revjmoney/revturn-lathe-firmware/tools/resonance/runs/c_speed_50-200rpm/report.md

| C accel (deg/s2) | workout | seconds | sound over quiet (dB) | shake RMS (m/s2) | shake peak | chuck frame change |
|---|---|---|---|---|---|---|
| 50 | ok in 27.0 s | 26.98 | 1.03 | 0.34 | 0.77 | 7.08 |
| 100 | ok in 15.8 s | 15.84 | 0.88 | 0.36 | 0.92 | 7.03 |
| 150 | ok in 12.5 s | 12.56 | 0.99 | 0.38 | 1.42 | 6.93 |
| 200 | ok in 11.3 s | 11.32 | 1.16 | 0.41 | 1.68 | 15.39 |
