revjmoney/revturn-lathe-firmware/tools/resonance/runs/c_spin_one_dot_manual_exposure/spin_report.md

| commanded rpm | camera rpm | error | mark contrast |
|---|---|---|---|
| 10 | 9.9 | -0.1 | 4597.5 |
| 20 | 21.8 | +1.8 | 5310.2 |
| 30 | 31.6 | +1.6 | 5629.8 |
| 60 | 59.8 | -0.2 | 4653.1 |
| 90 | 92.1 | +2.1 | 4888.3 |
| 120 | 120.4 | +0.4 | 3014.3 |
| 150 | 148.1 | -1.9 | 5080.2 |
| 200 | 199.3 | -0.7 | 5007.6 |
| 250 | 249.0 | -1.0 | 4621.6 |
| 275 | 274.4 | -0.6 | 4504.1 |
| 300 | 296.0 | -4.0 | 2987.7 |

camera shift 1.3 s
