revjmoney/revturn-lathe-firmware/tools/resonance/runs/c_spin_two_marks/spin_report.md

| commanded rpm | camera rpm | error | mark contrast |
|---|---|---|---|
| 10 | 10.1 | +0.1 | 1208.2 |
| 20 | 20.4 | +0.4 | 1436.2 |
| 30 | 60.6 | +30.6 | 1276.8 |
| 60 | 120.0 | +60.0 | 1216.7 |
| 90 | 180.2 | +90.2 | 1178.0 |
| 120 | 239.5 | +119.5 | 1102.3 |
| 150 | 150.1 | +0.1 | 1090.0 |
| 200 | 198.9 | -1.1 | 913.7 |
| 250 | 248.5 | -1.5 | 649.2 |
| 275 | 123.0 | -152.0 | 599.2 |
| 300 | 300.4 | +0.4 | 571.6 |

camera shift -0.5 s
