revjmoney/revturn-lathe-firmware/tools/resonance/runs/chords-2026-11-11T19-04-08/machine-info.txt

[VER:1.1f.20261015:]
[OPT:VNSL,100,1024,4,0]
[AXS:4:XYZC]
[NEWOPT:ENUMS,RT+,CCMP,NOPROBE,RF,ES,LATHE,REBOOT,EXPR,TC,SED,RTC,WIFI,FTP,mDNS,FS,YM]
[FIRMWARE:grblHAL]
[SIGNALS:E]
[NVS STORAGE:*FLASH 4K]
[FREE MEMORY:157K]
[DRIVER:ESP32@240MHz]
[DRIVER VERSION:261003]
[DRIVER OPTIONS:4.3.2]
[BOARD:REVTURN by JMSCNC (ESP32 lathe)]
[HOSTNAME:revturn.local]
[NETCON:Websocket]
[PLUGIN:FS stream v1.16]
[PLUGIN:WebUI v0.32]
[SPINDLE:Stepper]
