revjmoney/revturn-lathe-firmware/tools/resonance/runs/chords-2026-11-11T19-04-08/summary.md

# chords.nc (chords)

Recorded 2026-11-11T19:01:48.073Z: 55989 phone samples at 403 Hz, 1289 lathe status lines, background 0.028 m/s^2, median step 2.011 m/s^2.

## Weird things (5 steps flagged)
- **LOUD** X+Z 10 Hz beat: rms 3.0208, strongest 173.1 Hz = 1x pitch, reached 0.999
- **LOUD** Z + spindle, 2 Hz beat: rms 2.9063, strongest 182.9 Hz = 1x pitch, reached 0.997
- **LOUD** all three near unison: 2, 3, 5 Hz beats: rms 2.8585, strongest 181.0 Hz = 1x pitch, reached 1.0
- **LOUD** all three at their resonance: rms 3.3559, strongest 128.1 Hz = 1x pitch, reached 0.997
- **LOUD** spread: rms 2.7664, strongest 199.9 Hz = 1x pitch, reached 0.999

## Chords (loudest first)
- 3.356 m/s^2 (122x background): all three at their resonance  [strongest 128.1 Hz]
- 3.159 m/s^2 (115x background): X+Z both at their resonance, 1 Hz beat  [strongest 127.7 Hz]
- 3.021 m/s^2 (110x background): X+Z 10 Hz beat  [strongest 173.1 Hz]
- 2.906 m/s^2 (106x background): Z + spindle, 2 Hz beat  [strongest 182.9 Hz]
- 2.865 m/s^2 (104x background): X+Z near unison, 2 Hz beat  [strongest 181.0 Hz]
- 2.858 m/s^2 (104x background): all three near unison: 2, 3, 5 Hz beats  [strongest 181.0 Hz]
- 2.766 m/s^2 (101x background): spread  [strongest 199.9 Hz]
- 2.579 m/s^2 (94x background): X+Z minor second, a clash  [strongest 170.3 Hz]
- 2.066 m/s^2 (75x background): A minor chord: X A3, Z C4, C E4  [strongest 141.5 Hz]
- 2.011 m/s^2 (73x background): low rumble  [strongest 99.7 Hz]
- 1.426 m/s^2 (52x background): X + spindle, X at resonance  [strongest 149.0 Hz]
- 1.325 m/s^2 (48x background): C major chord: X C4, Z E4, C G4  [strongest 73.7 Hz]
- 1.306 m/s^2 (47x background): all three in tune: A4 unison  [strongest 183.3 Hz]
- 1.182 m/s^2 (43x background): X+Z perfect fifth  [strongest 72.9 Hz]
- 1.040 m/s^2 (38x background): mid  [strongest 199.5 Hz]
- 0.992 m/s^2 (36x background): X+Z fast, spindle 2 octaves up  [strongest 103.7 Hz]
- 0.831 m/s^2 (30x background): X+Z octave  [strongest 182.9 Hz]
- 0.788 m/s^2 (29x background): everything fast  [strongest 136.4 Hz]
- 0.540 m/s^2 (20x background): X + spindle, 2 Hz beat  [strongest 182.9 Hz]
