revjmoney/revturn-lathe-firmware/tools/resonance/runs/scale_c-2026-11-11T18-59-36/summary.md

# scale_c.nc (C)

Recorded 2026-11-11T18:53:38.636Z: 142893 phone samples at 403 Hz, 2553 lathe status lines, background 0.028 m/s^2, median step 0.127 m/s^2.

## Weird things (45 steps flagged)
- **RING** q 570.6094 Hz = 57.0624 rpm: rms 0.158, strongest 52.8 Hz = other pitch, reached 0.999
- **RING** q 640.4874 Hz = 64.0503 rpm: rms 0.1141, strongest 50.9 Hz = other pitch, reached 0.999
- **RING** E5 659.2551 Hz = 65.9272 rpm: rms 0.1106, strongest 52.0 Hz = other pitch, reached 1.001
- **RING** q 718.9228 Hz = 71.8941 rpm: rms 0.1036, strongest 51.3 Hz = other pitch, reached 1.001
- **RING** F#5 739.9888 Hz = 74.0007 rpm: rms 0.1018, strongest 52.4 Hz = other pitch, reached 1.0
- **RING** q 761.6722 Hz = 76.1691 rpm: rms 0.1317, strongest 95.0 Hz = other pitch, reached 0.998
- **RING** G5 783.9909 Hz = 78.401 rpm: rms 0.1186, strongest 49.7 Hz = other pitch, reached 0.995
- **RING** q 806.9636 Hz = 80.6984 rpm: rms 0.0901, strongest 95.0 Hz = other pitch, reached 1.004
- **RING** q 854.9481 Hz = 85.4969 rpm: rms 0.1233, strongest 54.4 Hz = other pitch, reached 0.994
- **RING** A5 880 Hz = 88.0022 rpm: rms 0.1246, strongest 97.0 Hz = other pitch, reached 1.0
- **RING** q 905.786 Hz = 90.5809 rpm: rms 0.1472, strongest 90.7 Hz = other pitch, reached 1.005
- **RING** A#5 932.3275 Hz = 93.2351 rpm: rms 0.1667, strongest 55.2 Hz = other pitch, reached 0.997
- **RING** B5 987.7666 Hz = 98.7791 rpm: rms 0.1259, strongest 100.9 Hz = other pitch, reached None
- **RING** q 1016.7104 Hz = 101.6736 rpm: rms 0.1239, strongest 52.8 Hz = other pitch, reached None
- **RING** C6 1046.5023 Hz = 104.6528 rpm: rms 0.129, strongest 58.7 Hz = other pitch, reached None
- **RING** q 1077.1671 Hz = 107.7194 rpm: rms 0.1401, strongest 113.5 Hz = other pitch, reached None
- **RING** C#6 1108.7305 Hz = 110.8758 rpm: rms 0.1123, strongest 52.8 Hz = other pitch, reached None
- **RING** q 1141.2188 Hz = 114.1247 rpm: rms 0.1139, strongest 51.6 Hz = other pitch, reached None
- **RING** D6 1174.6591 Hz = 117.4688 rpm: rms 0.1261, strongest 55.6 Hz = other pitch, reached None
- **RING** q 1209.0792 Hz = 120.9109 rpm: rms 0.1487, strongest 93.4 Hz = other pitch, reached None
- **RING** D#6 1244.5079 Hz = 124.4539 rpm: rms 0.1327, strongest 55.6 Hz = other pitch, reached None
- **RING** q 1280.9748 Hz = 128.1007 rpm: rms 0.1304, strongest 52.4 Hz = other pitch, reached None
- **RING** E6 1318.5102 Hz = 131.8543 rpm: rms 0.166, strongest 102.9 Hz = other pitch, reached None
- **RING** q 1357.1455 Hz = 135.7179 rpm: rms 0.2455, strongest 94.6 Hz = other pitch, reached None
- **RING** F6 1396.9129 Hz = 139.6948 rpm: rms 0.2007, strongest 88.3 Hz = other pitch, reached None
- **RING** q 1437.8456 Hz = 143.7882 rpm: rms 0.1965, strongest 106.0 Hz = other pitch, reached None
- **RING** F#6 1479.9777 Hz = 148.0015 rpm: rms 0.2465, strongest 91.1 Hz = other pitch, reached None
- **RING** q 1523.3443 Hz = 152.3382 rpm: rms 0.1742, strongest 58.0 Hz = other pitch, reached None
- **RING** G6 1567.9817 Hz = 156.8021 rpm: rms 0.2034, strongest 113.1 Hz = other pitch, reached None
- **RING** q 1613.9271 Hz = 161.3967 rpm: rms 0.1731, strongest 88.3 Hz = other pitch, reached None
- **RING** G#6 1661.2188 Hz = 166.126 rpm: rms 0.175, strongest 93.8 Hz = other pitch, reached None
- **RING** A6 1760 Hz = 176.0044 rpm: rms 0.2097, strongest 96.6 Hz = other pitch, reached None
- **RING** A#6 1864.655 Hz = 186.4702 rpm: rms 0.1624, strongest 54.4 Hz = other pitch, reached None
- **RING** q 1919.2936 Hz = 191.9342 rpm: rms 0.1744, strongest 54.4 Hz = other pitch, reached None
- **RING** B6 1975.5332 Hz = 197.5583 rpm: rms 0.2016, strongest 112.4 Hz = other pitch, reached None
- **RING** q 2033.4207 Hz = 203.3472 rpm: rms 0.2557, strongest 97.8 Hz = other pitch, reached None
- **RING** C7 2093.0045 Hz = 209.3057 rpm: rms 0.2007, strongest 54.0 Hz = other pitch, reached None
- **RING** q 2154.3342 Hz = 215.4388 rpm: rms 0.2348, strongest 52.8 Hz = other pitch, reached None
- **RING** C#7 2217.461 Hz = 221.7516 rpm: rms 0.2119, strongest 55.6 Hz = other pitch, reached None
- **RING** q 2282.4376 Hz = 228.2495 rpm: rms 0.2605, strongest 147.0 Hz = other pitch, reached None
- **RING** D7 2349.3181 Hz = 234.9377 rpm: rms 0.2348, strongest 151.0 Hz = other pitch, reached None
- **RING** q 2418.1584 Hz = 241.8219 rpm: rms 0.2424, strongest 24.8 Hz = other pitch, reached None
- **RING** D#7 2489.0159 Hz = 248.9078 rpm: rms 0.2801, strongest 26.0 Hz = other pitch, reached None
- **RING** E7 2637.0205 Hz = 263.7086 rpm: rms 0.2524, strongest 26.8 Hz = other pitch, reached 1.001
- **RING** q 2714.2911 Hz = 271.4359 rpm: rms 0.2526, strongest 27.2 Hz = other pitch, reached 0.998

## Smooth notes (21): C2 (6.5408), C#2 (6.9297), F3 (17.4618), F#3 (18.5002), G3 (19.6003), G#3 (20.7658), A3 (22.0006), A#3 (23.3088), B3 (24.6948), C4 (26.1632), D4 (29.3672), E4 (32.9636), F4 (34.9237), F#4 (37.0004), G4 (39.2005), G#4 (41.5315), A4 (44.0011), A#4 (46.6175), B4 (49.3896), C5 (52.3264), D5 (58.7344)
## Roughest steps: D#2 77.7817 Hz / 7.7784 = 0.2911, q 75.5675 Hz / 7.5569 = 0.2851, D#7 2489.0159 Hz / 248.9078 = 0.2801, C#3 138.5913 Hz / 13.8595 = 0.2609, q 2282.4376 Hz / 228.2495 = 0.2605, q 80.0609 Hz / 8.0063 = 0.2598, q 2033.4207 Hz / 203.3472 = 0.2557, q 2714.2911 Hz / 271.4359 = 0.2526
