revjmoney/revturn-lathe-firmware/tools/resonance/runs/scale_x-2026-11-11T18-37-28/summary.md

# scale_x.nc (X)

Recorded 2026-11-11T18:32:01.567Z: 130684 phone samples at 403 Hz, 2996 lathe status lines, background 0.027 m/s^2, median step 0.807 m/s^2.

## Weird things (7 steps flagged)
- **RING** C2 65.4064 Hz = 3.0901 ipm: rms 0.7142, strongest 75.7 Hz = other pitch, reached 0.994
- **RING** C#2 69.2957 Hz = 3.2738 ipm: rms 0.6755, strongest 194.8 Hz = other pitch, reached 0.998
- **RING** q 71.3262 Hz = 3.3697 ipm: rms 0.6167, strongest 188.8 Hz = other pitch, reached 0.993
- **RING** q 75.5675 Hz = 3.5701 ipm: rms 0.6621, strongest 176.2 Hz = other pitch, reached 0.992
- **LOUD** B3 246.9417 Hz = 11.6665 ipm: rms 1.2924, strongest 156.1 Hz = 1x pitch, reached 0.999
- **LOUD** B4 493.8833 Hz = 23.3331 ipm: rms 3.2949, strongest 156.1 Hz = 1/2 pitch, reached 0.999
- **LOUD** q 508.3552 Hz = 24.0168 ipm: rms 2.6687, strongest 149.0 Hz = 1/2 pitch, reached 1.0

## Smooth notes (11): D2 (3.4685), D#2 (3.6747), D3 (6.937), F#3 (8.74), G3 (9.2597), G#3 (9.8103), A3 (10.3937), A#3 (11.0117), F#5 (34.9601), G5 (37.0389), G#5 (39.2414)
## Roughest steps: B4 493.8833 Hz / 23.3331 = 3.2949, q 508.3552 Hz / 24.0168 = 2.6687, q 479.8234 Hz / 22.6688 = 2.2621, C5 523.2511 Hz / 24.7205 = 1.9989, A#4 466.1638 Hz / 22.0235 = 1.671, q 640.4874 Hz / 30.2592 = 1.5945, q 538.5836 Hz / 25.4449 = 1.529, q 452.893 Hz / 21.3965 = 1.516
