revjmoney/revturn-lathe-firmware/tools/resonance/runs/scale_z-2026-11-11T18-43-09/summary.md

# scale_z.nc (Z)

Recorded 2026-11-11T18:37:50.652Z: 127518 phone samples at 403 Hz, 2930 lathe status lines, background 0.026 m/s^2, median step 1.836 m/s^2.

## Weird things (0 steps flagged)

## Smooth notes (12): C2 (2.5591), D#4 (12.173), E4 (12.8969), F4 (13.6637), F#4 (14.4762), G4 (15.337), G#4 (16.249), A4 (17.2152), A#4 (18.2389), B4 (19.3235), C5 (20.4725), C#5 (21.6898)
## Roughest steps: G#3 207.6523 Hz / 8.1245 = 3.0739, G3 195.9977 Hz / 7.6685 = 3.0602, C3 130.8128 Hz / 5.1181 = 3.0349, A3 220 Hz / 8.6076 = 3.0336, C#3 138.5913 Hz / 5.4225 = 2.9716, q 127.0888 Hz / 4.9724 = 2.9675, A#3 233.0819 Hz / 9.1195 = 2.9142, q 134.6459 Hz / 5.2681 = 2.9038
