revjmoney/revturn-lathe-firmware/tools/resonance/runs/chords-2026-11-11T19-04-08/report.csv

n | label | xHz | zHz | cHz | xIpm | zIpm | rpm | pathF | rms | peak_hz | motor_seen | motor_share | peak_is | reached | timed | seconds | flags
4000 | X+Z both at their resonance, 1 Hz beat | 127 | 128 |  | 6 | 5.0081 | 0 | 7.8154 | 3.1595 | 127.7 | 127.0 128.0 | 0.986 | 1x | 0.997 | False | 3.48
4001 | X+Z near unison, 2 Hz beat | 220 | 222 |  | 10.3937 | 8.6859 | 0 | 13.5452 | 2.8647 | 181.0 | 182.9 180.9 | 0.91 | 1x | 1.0 | False | 3.4
4002 | X+Z 10 Hz beat | 220 | 230 |  | 10.3937 | 8.9989 | 0 | 13.748 | 3.0208 | 173.1 | 182.9 172.9 | 0.986 | 1x | 0.999 | False | 3.36 | LOUD
4003 | X+Z minor second, a clash | 220 | 233.08 |  | 10.3937 | 9.1194 | 0 | 13.8272 | 2.5785 | 170.3 | 182.9 169.8 | 0.956 | 1x | 0.999 | False | 3.28
4004 | X+Z perfect fifth | 220 | 330 |  | 10.3937 | 12.9114 | 0 | 16.5751 | 1.1818 | 72.9 | 182.9 72.9 | 0.901 | 1x | 1.0 | False | 3.02
4005 | X+Z octave | 220 | 440 |  | 10.3937 | 17.2152 | 0 | 20.1095 | 0.8314 | 182.9 | 182.9 37.1 | 0.937 | 1/2 | 0.998 | False | 2.85
4006 | X + spindle, 2 Hz beat | 220 |  | 222 | 10.3937 | 0 | 22.2006 | 10.3937 | 0.5404 | 182.9 | 182.9 180.9 | 0.679 | 1x | 0.996 | False | 3.91
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
