revjmoney/revturn-lathe-firmware/tools/resonance/runs/c_accel_2500-3400/report.md

| C accel (deg/s2) | workout | seconds | sound over quiet (dB) | shake RMS (m/s2) | shake peak | chuck frame change |
|---|---|---|---|---|---|---|
| 2500 | ok in 19.4 s | 19.45 | 1.05 | 0.34 | 0.66 | 5.95 |
| 2600 | ok in 19.3 s | 19.30 | 0.68 | 0.34 | 0.68 | 5.49 |
| 2700 | ok in 19.2 s | 19.25 | 0.74 | 0.34 | 0.71 | 6.52 |
| 2800 | ok in 19.1 s | 19.11 | 0.81 | 0.34 | 0.67 | 6.79 |
| 2900 | ok in 19.0 s | 19.05 | 0.97 | 0.34 | 0.90 | 5.86 |
| 3000 | ok in 19.1 s | 19.10 | 1.20 | 0.34 | 0.85 | 6.81 |
| 3100 | ok in 18.9 s | 18.93 | 1.35 | 0.34 | 0.75 | 6.58 |
| 3200 | ok in 18.9 s | 18.93 | 1.55 | 0.34 | 0.80 | 7.54 |
| 3300 | ok in 19.0 s | 19.02 | 1.73 | 0.34 | 0.87 | 8.37 |
| 3400 | ok in 18.8 s | 18.78 | 2.17 | 0.34 | 0.80 | 20.27 |
