revjmoney/revturn-lathe-firmware/tools/resonance/runs/c_accel_400-760/report.md

| C accel (deg/s2) | workout | seconds | sound over quiet (dB) | shake RMS (m/s2) | shake peak | chuck frame change |
|---|---|---|---|---|---|---|
| 400 | ok in 27.5 s | 27.52 | 0.66 | 0.35 | 2.58 | 5.46 |
| 440 | ok in 26.7 s | 26.70 | 0.91 | 0.35 | 1.68 | 5.08 |
| 480 | ok in 25.8 s | 25.84 | 1.27 | 0.35 | 2.20 | 4.87 |
| 520 | ok in 25.4 s | 25.46 | 1.73 | 0.35 | 1.95 | 5.08 |
| 560 | ok in 24.7 s | 24.76 | 2.26 | 0.35 | 1.95 | 5.42 |
| 600 | ok in 24.2 s | 24.23 | 2.76 | 0.35 | 2.04 | 9.49 |
| 640 | ok in 23.8 s | 23.85 | 3.24 | 0.35 | 1.09 | 5.64 |
| 680 | ok in 23.4 s | 23.44 | 3.68 | 0.35 | 2.02 | 5.71 |
| 720 | ok in 23.1 s | 23.13 | 4.07 | 0.35 | 1.70 | 5.10 |
| 760 | ok in 22.9 s | 22.93 | 4.51 | 0.34 | 2.01 | 5.53 |
