revjmoney/revturn-lathe-firmware/tools/resonance/runs/c_accel_800-1250/report.md

| C accel (deg/s2) | workout | seconds | sound over quiet (dB) | shake RMS (m/s2) | shake peak | chuck frame change |
|---|---|---|---|---|---|---|
| 800 | ok in 22.6 s | 22.63 | 0.81 | 0.34 | 0.96 | 7.18 |
| 850 | ok in 22.3 s | 22.34 | 0.67 | 0.34 | 1.42 | 5.94 |
| 900 | ok in 22.0 s | 22.05 | 1.00 | 0.34 | 1.73 | 6.12 |
| 950 | ok in 21.9 s | 21.96 | 1.44 | 0.34 | 1.66 | 6.24 |
| 1000 | ok in 21.5 s | 21.52 | 1.90 | 0.34 | 1.60 | 6.38 |
| 1050 | ok in 21.4 s | 21.43 | 2.35 | 0.34 | 1.02 | 6.44 |
| 1100 | ok in 21.2 s | 21.26 | 3.58 | 0.34 | 1.95 | 7.33 |
| 1150 | ok in 21.0 s | 21.05 | 3.37 | 0.35 | 1.05 | 19.30 |
| 1200 | ok in 21.0 s | 21.02 | 3.75 | 0.34 | 1.32 | 7.32 |
| 1250 | ok in 20.8 s | 20.84 | 4.18 | 0.34 | 1.39 | 6.96 |
