revjmoney/revturn-lathe-firmware/tools/resonance/runs/scale_c-2026-11-11T18-59-36/report.csv

n | axis | note | q | hz | speed | rms | peak_hz | motor_seen | motor_share | peak_is | reached | timed | seconds | flags
3000 | C | C2 | 0 | 65.4064 | 6.5408 | 0.0696 | 130.9 | 65.4 | 0.649 | 2x | 1.07 | False | 1.96
3001 | C |  | 1 | 67.3229 | 6.7325 | 0.0922 | 134.8 | 67.3 | 0.683 | 2x | 1.04 | False | 1.76
3002 | C | C#2 | 2 | 69.2957 | 6.9297 | 0.0924 | 138.8 | 69.3 | 0.787 | 2x | 1.01 | False | 1.79
3003 | C |  | 3 | 71.3262 | 7.1328 | 0.0932 | 71.4 | 71.3 | 0.69 | 1x | 0.981 | False | 1.76
3004 | C | D2 | 4 | 73.4162 | 7.3418 | 0.1703 | 146.7 | 73.4 | 0.836 | 2x | 0.953 | False | 1.76
3005 | C |  | 5 | 75.5675 | 7.5569 | 0.2851 | 152.2 | 75.6 | 0.872 | 2x | 1.059 | False | 1.8
3006 | C | D#2 | 6 | 77.7817 | 7.7784 | 0.2911 | 77.7 | 77.8 | 0.973 | 1x | 1.028 | False | 1.61
3007 | C |  | 7 | 80.0609 | 8.0063 | 0.2598 | 160.1 | 80.1 | 0.914 | 2x | 0.999 | False | 1.75
3008 | C | E2 | 8 | 82.4069 | 8.2409 | 0.2523 | 164.8 | 82.4 | 0.971 | 2x | 0.971 | False | 1.72
3009 | C |  | 9 | 84.8216 | 8.4824 | 0.1958 | 84.8 | 84.8 | 0.965 | 1x | 0.943 | False | 1.7
3010 | C | F2 | 10 | 87.3071 | 8.7309 | 0.1977 | 87.5 | 87.3 | 0.876 | 1x | 1.031 | False | 1.77
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
