revjmoney/revturn-lathe-firmware/tools/resonance/runs/scale_x-2026-11-11T18-37-28/report.csv

n | axis | note | q | hz | speed | rms | peak_hz | motor_seen | motor_share | peak_is | reached | seconds | flags
1000 | X | C2 | 0 | 65.4064 | 3.0901 | 0.7142 | 75.7 | 65.4 | 0.05 | other | 0.994 | 2.87 | RING
1001 | X |  | 1 | 67.3229 | 3.1806 | 0.6115 | 134.0 | 67.3 | 0.737 | 2x | 0.99 | 2.82
1002 | X | C#2 | 2 | 69.2957 | 3.2738 | 0.6755 | 194.8 | 69.3 | 0.122 | other | 0.998 | 2.8 | RING
1003 | X |  | 3 | 71.3262 | 3.3697 | 0.6167 | 188.8 | 71.3 | 0.195 | other | 0.993 | 2.85 | RING
1004 | X | D2 | 4 | 73.4162 | 3.4685 | 0.593 | 147.1 | 73.4 | 0.356 | 2x | 0.999 | 2.83
1005 | X |  | 5 | 75.5675 | 3.5701 | 0.6621 | 176.2 | 75.6 | 0.237 | other | 0.992 | 2.82 | RING
1006 | X | D#2 | 6 | 77.7817 | 3.6747 | 0.6148 | 169.9 | 77.8 | 0.296 | other | 0.996 | 2.82
1007 | X |  | 7 | 80.0609 | 3.7824 | 0.7352 | 162.4 | 80.1 | 0.563 | 2x | 0.999 | 2.82
1008 | X | E2 | 8 | 82.4069 | 3.8932 | 0.7497 | 164.8 | 82.4 | 0.309 | 2x | 0.991 | 2.82
1009 | X |  | 9 | 84.8216 | 4.0073 | 0.7226 | 148.6 | 84.8 | 0.382 | other | 0.992 | 2.88
1010 | X | F2 | 10 | 87.3071 | 4.1247 | 0.8027 | 141.1 | 87.3 | 0.333 | other | 0.993 | 2.71
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
