revjmoney/revturn-lathe-firmware/tools/resonance/runs/scale_z-2026-11-11T18-43-09/report.csv

n | axis | note | q | hz | speed | rms | peak_hz | motor_seen | motor_share | peak_is | reached | seconds | flags
2000 | Z | C2 | 0 | 65.4064 | 2.5591 | 1.4152 | 130.9 | 65.4 | 0.705 | 2x | 1.0 | 2.83
2001 | Z |  | 1 | 67.3229 | 2.634 | 1.4668 | 134.4 | 67.3 | 0.743 | 2x | 0.986 | 2.94
2002 | Z | C#2 | 2 | 69.2957 | 2.7112 | 1.6434 | 138.8 | 69.3 | 0.821 | 2x | 0.987 | 2.35
2003 | Z |  | 3 | 71.3262 | 2.7907 | 1.7028 | 142.7 | 71.3 | 0.818 | 2x | 0.988 | 2.63
2004 | Z | D2 | 4 | 73.4162 | 2.8724 | 1.7288 | 146.7 | 73.4 | 0.818 | 2x | 0.987 | 2.56
2005 | Z |  | 5 | 75.5675 | 2.9566 | 1.63 | 151.4 | 75.6 | 0.749 | 2x | 0.999 | 2.81
2006 | Z | D#2 | 6 | 77.7817 | 3.0433 | 1.632 | 155.3 | 77.8 | 0.83 | 2x | 0.996 | 2.62
2007 | Z |  | 7 | 80.0609 | 3.1324 | 1.5171 | 80.4 | 80.1 | 0.831 | 1x | 0.993 | 3.02
2008 | Z | E2 | 8 | 82.4069 | 3.2242 | 1.5699 | 82.4 | 82.4 | 0.885 | 1x | 0.989 | 2.59
2009 | Z |  | 9 | 84.8216 | 3.3187 | 1.5405 | 84.8 | 84.8 | 0.879 | 1x | 0.997 | 2.61
2010 | Z | F2 | 10 | 87.3071 | 3.4159 | 1.5438 | 87.5 | 87.3 | 0.887 | 1x | 0.991 | 2.62
2011 | Z |  | 11 | 89.8653 | 3.516 | 1.6144 | 89.9 | 89.9 | 0.898 | 1x | 0.997 | 2.6
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
