revjmoney/revturn-lathe-firmware/tools/resonance/runs/spindle_sweep-2026-11-11T17-56-22/report.csv

rpm | rms_m_s2 | x_background | peak_hz | peak_share | seconds
20 | 0.1097 | 4.16 | 200.0 | 0.422 | 3.2
35 | 0.0826 | 3.14 | 83.8 | 0.135 | 2.6
50 | 0.0765 | 2.91 | 96.9 | 0.042 | 2.6
65 | 0.0791 | 3.00 | 162.6 | 0.044 | 2.6
80 | 0.1593 | 6.05 | 51.5 | 0.039 | 2.7
95 | 0.1151 | 4.37 | 90.4 | 0.041 | 2.5
110 | 0.1690 | 6.42 | 93.9 | 0.046 | 2.6
125 | 0.2439 | 9.26 | 98.0 | 0.030 | 2.6
140 | 0.2280 | 8.66 | 99.5 | 0.070 | 2.6
155 | 0.2073 | 7.87 | 97.5 | 0.049 | 2.6
170 | 0.2895 | 10.99 | 93.4 | 0.048 | 2.6
185 | 0.2031 | 7.71 | 103.5 | 0.033 | 2.6
200 | 0.2691 | 10.22 | 94.4 | 0.037 | 2.6
215 | 0.1589 | 6.03 | 102.0 | 0.036 | 2.7
230 | 0.1714 | 6.51 | 58.1 | 0.026 | 2.6
245 | 0.2044 | 7.76 | 96.9 | 0.059 | 2.6
260 | 0.2467 | 9.36 | 13.1 | 0.035 | 2.6
275 | 0.2700 | 10.25 | 13.6 | 0.037 | 2.7
