revjmoney/revturn-lathe-firmware/tools/resonance/runs/x_sweep-2026-11-11T17-59-14/report.csv

feed | rms_m_s2 | x_background | peak_hz | peak_share | seconds
2 | 0.3672 | 14.01 | 169.2 | 0.074 | 2.2
3 | 0.6368 | 24.30 | 85.8 | 0.262 | 2.8
4 | 0.6667 | 25.44 | 149.5 | 0.147 | 1.6
5 | 0.6837 | 26.09 | 191.9 | 0.118 | 1.8
6 | 1.1313 | 43.17 | 149.0 | 0.165 | 1.2
8 | 0.7447 | 28.42 | 169.2 | 0.078 | 1.4
10 | 0.5491 | 20.95 | 191.9 | 0.105 | 1.1
12 | 1.4162 | 54.04 | 149.0 | 0.165 | 1.5
14 | 0.6685 | 25.51 | 147.9 | 0.100 | 1.2
16 | 1.0422 | 39.77 | 169.2 | 0.177 | 1.3
18 | 0.6605 | 25.20 | 190.4 | 0.137 | 1.1
20 | 1.0832 | 41.33 | 191.4 | 0.157 | 1.1
22 | 1.4093 | 53.77 | 170.2 | 0.141 | 1.0
25 | 1.7964 | 68.54 | 139.4 | 0.137 | 1.1
