revjmoney/revturn-lathe-firmware/tools/resonance/runs/x_sweep_long-2026-11-11T18-24-11/report.csv

feed | rms_m_s2 | x_background | peak_hz | peak_share | seconds
2 | 0.4205 | 16.48 | 169.1 | 0.372 | 11.7
3 | 0.6652 | 26.06 | 85.3 | 0.420 | 11.3
4 | 0.7097 | 27.81 | 149.0 | 0.489 | 11.4
5 | 0.7933 | 31.08 | 191.4 | 0.513 | 10.5
6 | 1.2161 | 47.65 | 149.0 | 0.832 | 10.9
8 | 0.6800 | 26.64 | 169.1 | 0.376 | 10.7
10 | 0.5806 | 22.75 | 191.4 | 0.568 | 10.5
12 | 1.4199 | 55.63 | 149.0 | 0.680 | 10.4
14 | 0.7025 | 27.52 | 147.9 | 0.369 | 10.4
16 | 1.0965 | 42.96 | 169.1 | 0.577 | 10.1
18 | 0.5716 | 22.40 | 190.4 | 0.657 | 10.2
20 | 1.1095 | 43.47 | 191.4 | 0.750 | 10.3
22 | 1.5127 | 59.27 | 170.2 | 0.766 | 16.4
25 | 1.8521 | 72.57 | 138.3 | 0.538 | 14.0
28 | 0.9754 | 38.22 | 107.0 | 0.522 | 12.0
32 | 0.7458 | 29.22 | 64.6 | 0.443 | 9.9
36 | 0.4056 | 15.89 | 22.2 | 0.347 | 8.1
40 | 0.2904 | 11.38 | 20.2 | 0.135 | 6.8
