revjmoney/revturn-lathe-firmware/tools/resonance/runs/z_sweep-2026-11-11T18-04-04/report.csv

feed | rms_m_s2 | x_background | peak_hz | peak_share | seconds
2 | 1.1413 | 43.44 | 153.5 | 0.382 | 7.2
3 | 1.6582 | 63.12 | 76.7 | 0.386 | 7.2
4 | 1.9649 | 74.79 | 102.0 | 0.361 | 7.1
5 | 2.8891 | 109.96 | 127.7 | 0.829 | 7.1
6 | 2.3292 | 88.65 | 153.5 | 0.464 | 7.0
8 | 2.9357 | 111.74 | 198.4 | 0.733 | 6.8
10 | 2.1855 | 83.18 | 147.4 | 0.445 | 6.8
12 | 1.7610 | 67.03 | 96.4 | 0.169 | 6.6
14 | 0.5209 | 19.83 | 178.7 | 0.439 | 6.4
16 | 0.6434 | 24.49 | 198.4 | 0.580 | 6.3
18 | 0.5255 | 20.00 | 173.2 | 0.266 | 6.1
20 | 0.5396 | 20.54 | 127.7 | 0.358 | 6.1
22 | 0.8104 | 30.84 | 140.4 | 0.505 | 6.0
25 | 6.0413 | 229.94 | 138.9 | 0.474 | 5.7
