revjmoney/revturn-lathe-firmware/tools/resonance/runs/z_sweep-2026-11-11T18-17-05/report.csv

feed | rms_m_s2 | x_background | peak_hz | peak_share | seconds
2 | 1.3087 | 48.23 | 153.5 | 0.320 | 7.3
3 | 1.6361 | 60.29 | 76.7 | 0.437 | 7.2
4 | 2.0577 | 75.83 | 102.0 | 0.349 | 7.2
5 | 3.1338 | 115.49 | 127.7 | 0.839 | 7.1
6 | 2.3791 | 87.67 | 153.5 | 0.427 | 7.0
8 | 3.0555 | 112.60 | 198.4 | 0.754 | 6.9
10 | 2.2139 | 81.59 | 147.4 | 0.448 | 6.7
12 | 1.8255 | 67.27 | 153.5 | 0.196 | 6.6
14 | 1.0401 | 38.33 | 178.7 | 0.663 | 6.5
16 | 0.6067 | 22.36 | 198.4 | 0.349 | 6.4
18 | 0.4885 | 18.00 | 115.1 | 0.248 | 6.2
20 | 0.5447 | 20.07 | 127.7 | 0.333 | 6.1
22 | 0.7940 | 29.26 | 140.4 | 0.602 | 12.9
