revjmoney/revturn-lathe-firmware/docs/screenshots/revturn-cycles-thread.png

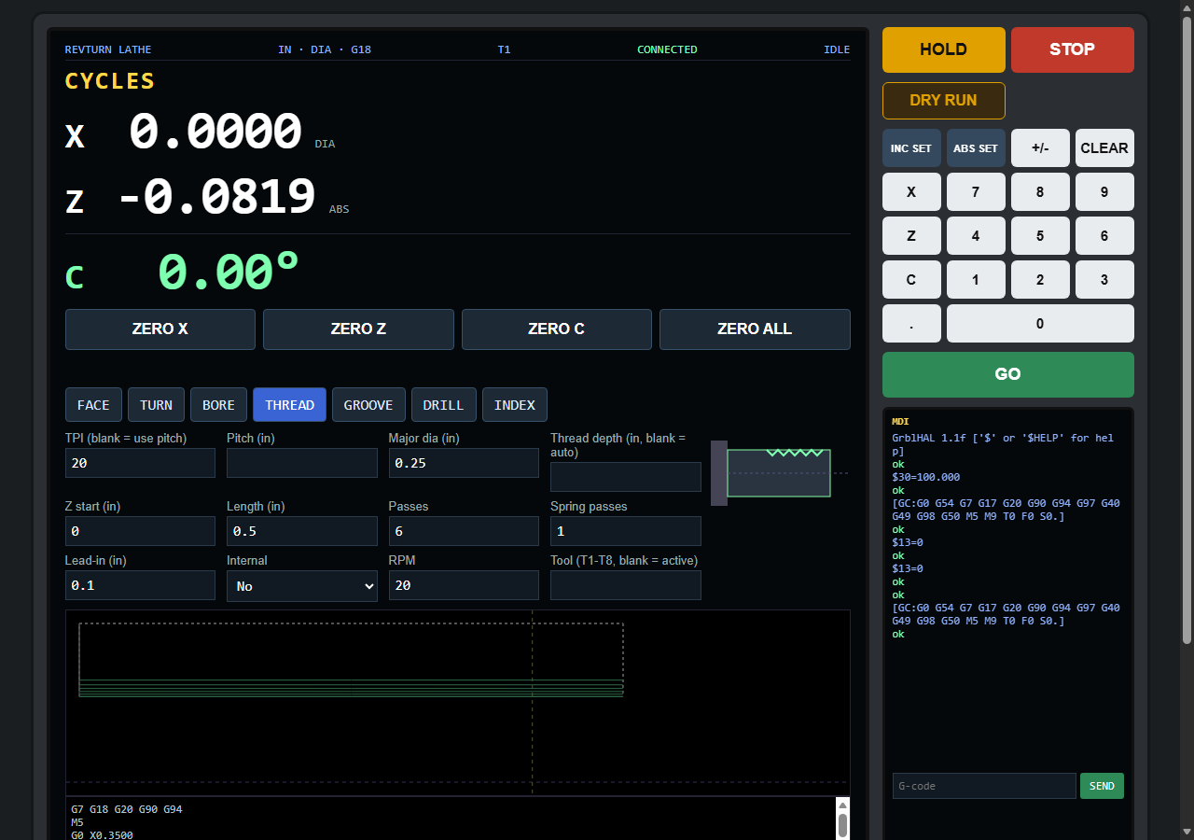
docs/screenshots/revturn-cycles-thread.png
