revjmoney/revturn-lathe-firmware/docs/screenshots/revturn-dro.png

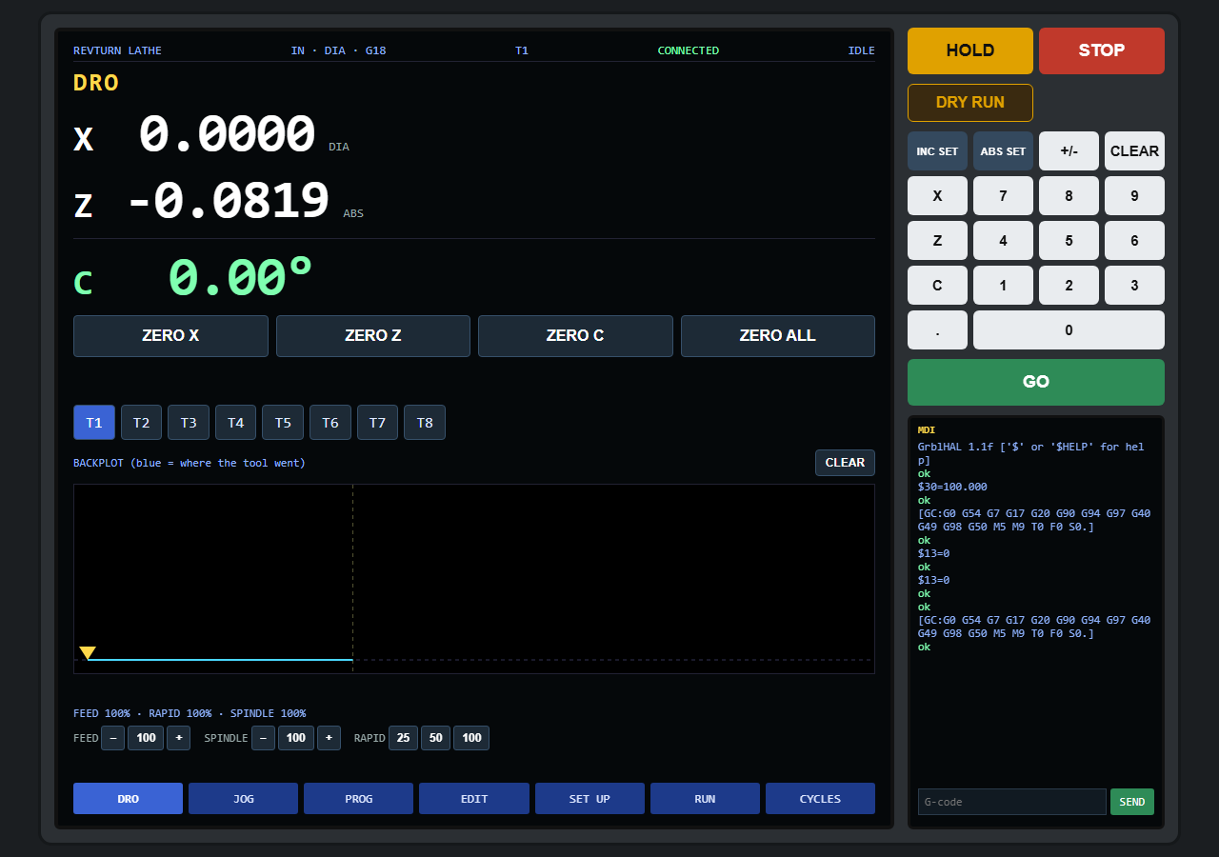
docs/screenshots/revturn-dro.png
