revjmoney/revturn-lathe-firmware/docs/screenshots/revturn-jog.png

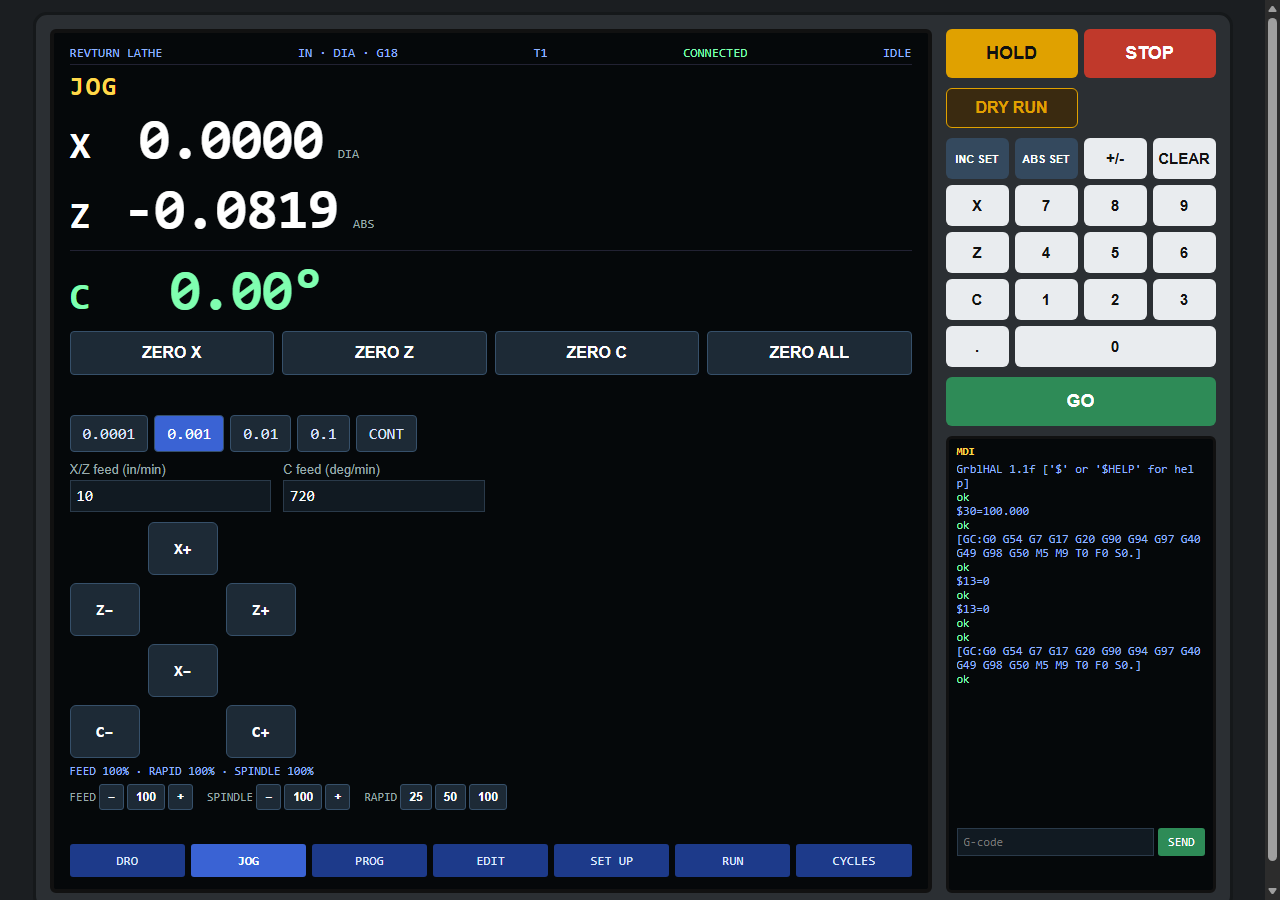
docs/screenshots/revturn-jog.png
