revjmoney/revturn-lathe-firmware/docs/screenshots/revturn-phone.png

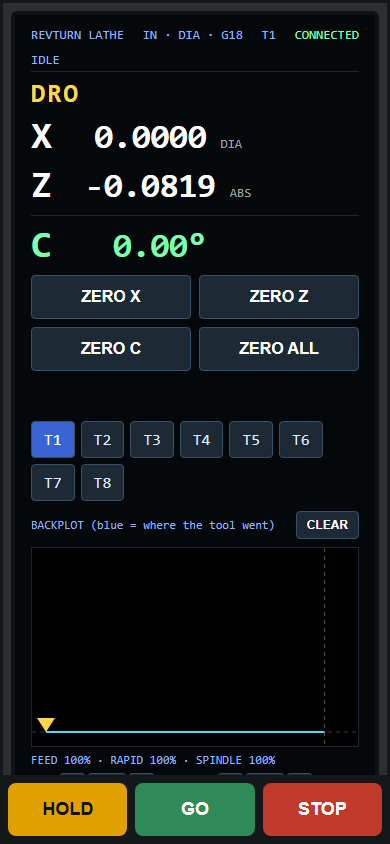
docs/screenshots/revturn-phone.png
