revjmoney/revturn-lathe-firmware/docs/screenshots/revturn-run-backplot.png

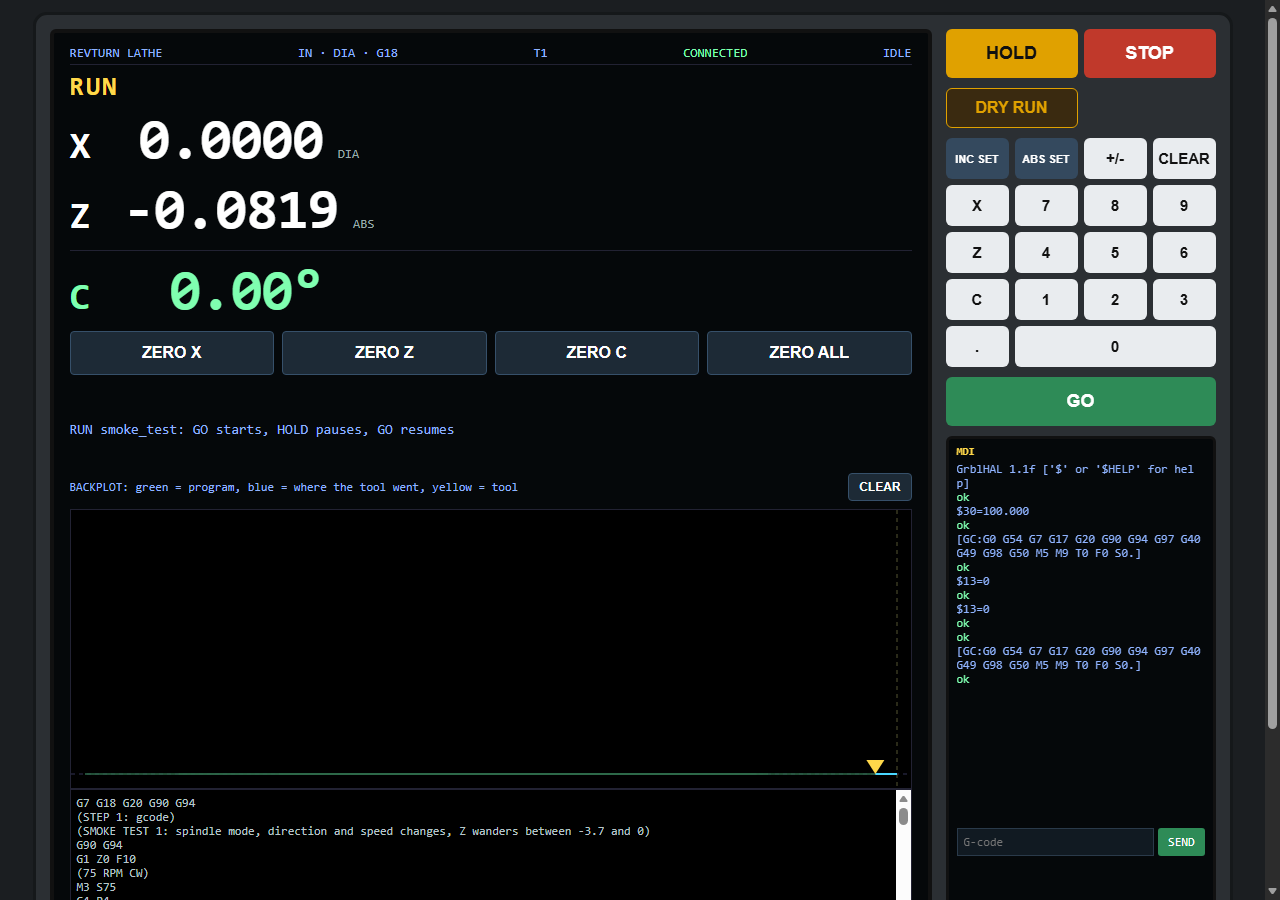
docs/screenshots/revturn-run-backplot.png
