revjmoney/revturn-lathe-firmware/hardware/drawings/drawings_r8_direct.png

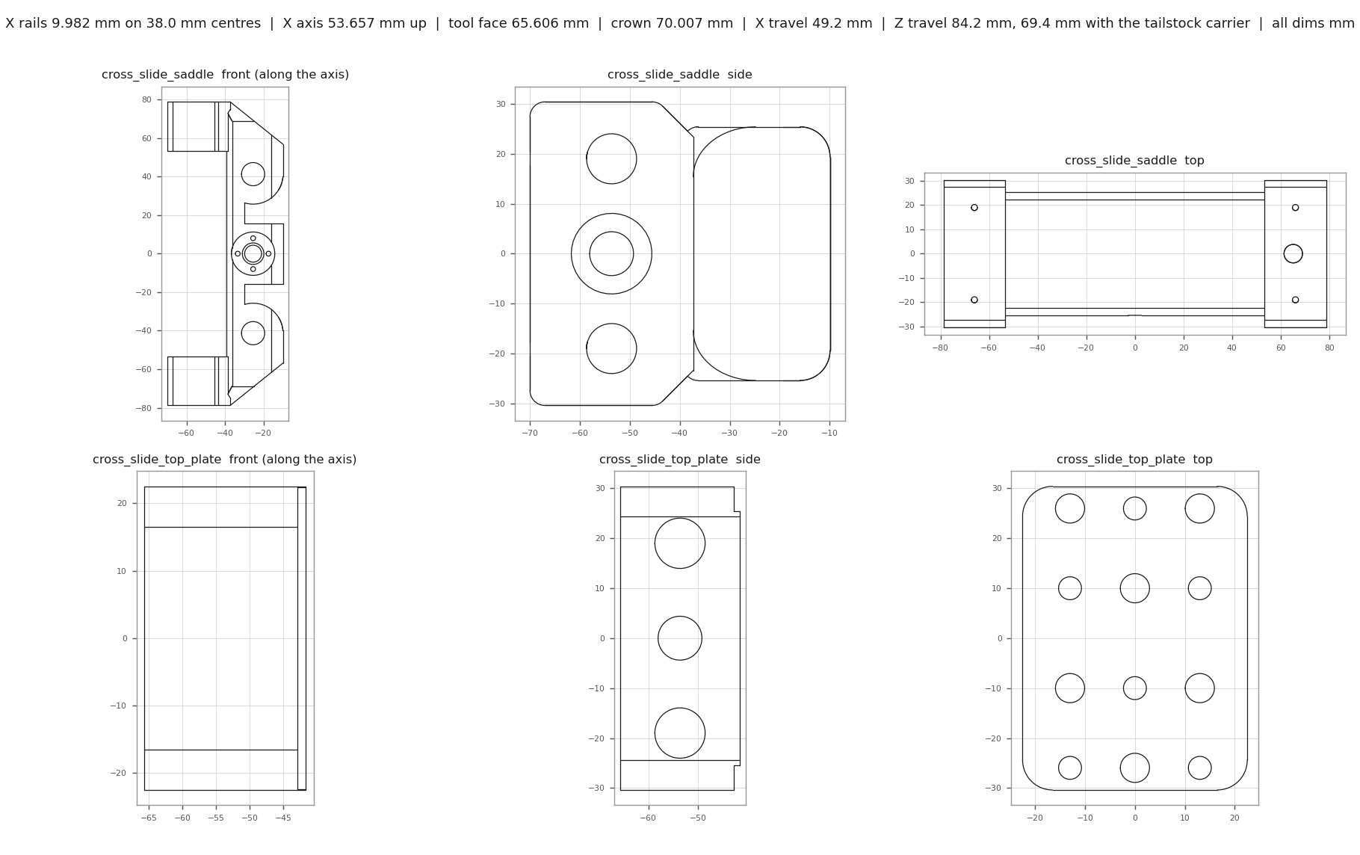
hardware/drawings/drawings_r8_direct.png
