revjmoney/revturn-lathe-firmware/hardware/drawings/tool-post/tool_post_at_90_iso.png

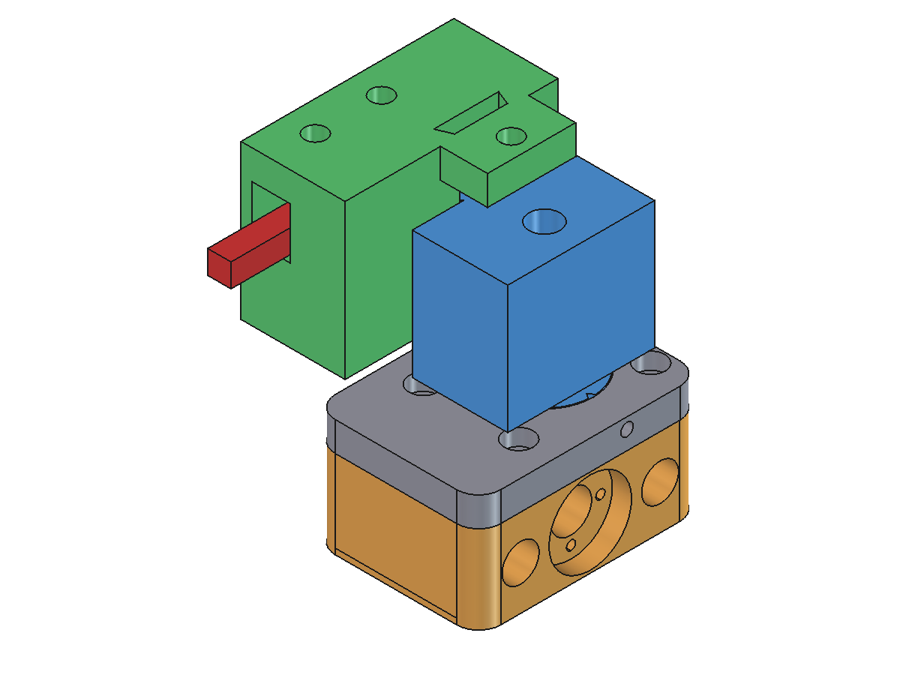
hardware/drawings/tool-post/tool_post_at_90_iso.png
