revjmoney/revturn-lathe-firmware/hardware/drawings/tool-post/tool_post_boring_iso.png

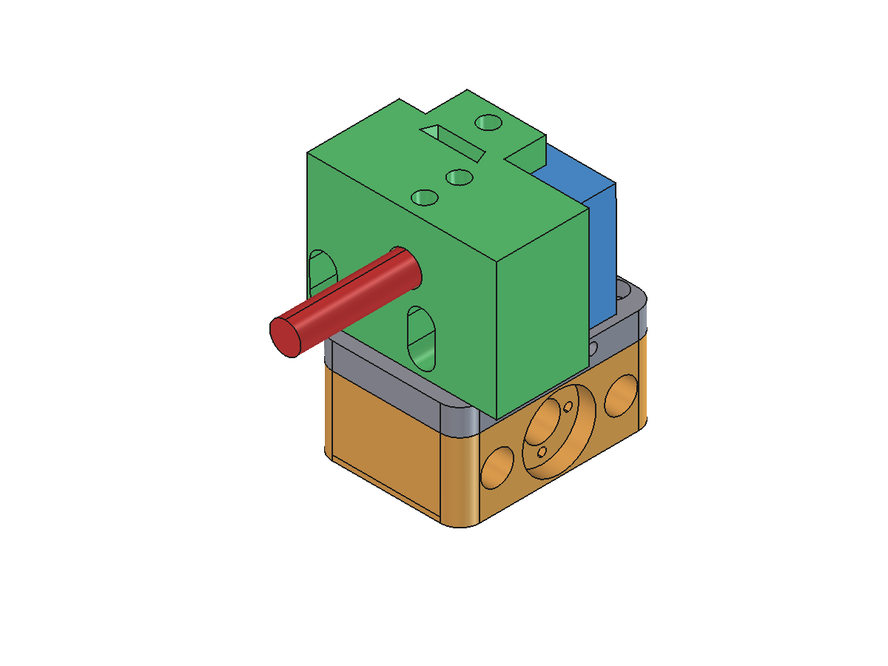
hardware/drawings/tool-post/tool_post_boring_iso.png
