revjmoney/revturn-lathe-firmware/hardware/drawings/x_motor_inline_rail_mount_r9.png

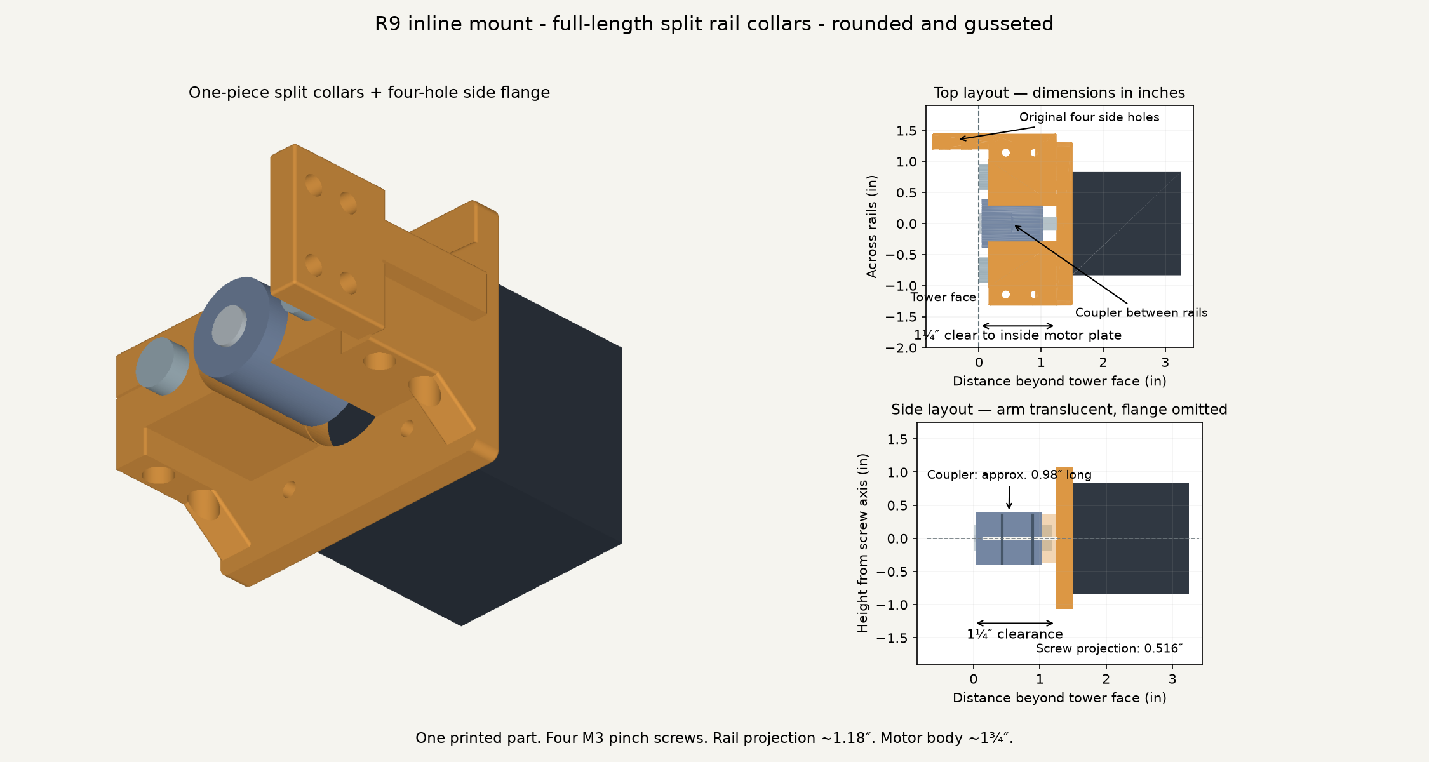
hardware/drawings/x_motor_inline_rail_mount_r9.png
