revjmoney/revturn-lathe-firmware/screen/src/brand/header-120.png

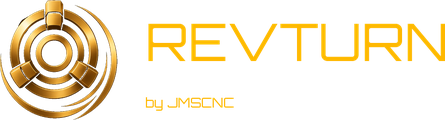
screen/src/brand/header-120.png
