revjmoney/revturn-lathe-firmware/screen/src/brand/monkey-320.png

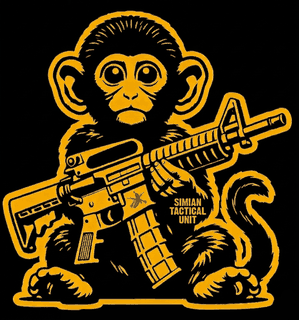
screen/src/brand/monkey-320.png
