revjmoney/revturn-lathe-firmware/site/media/drawings_bases.png

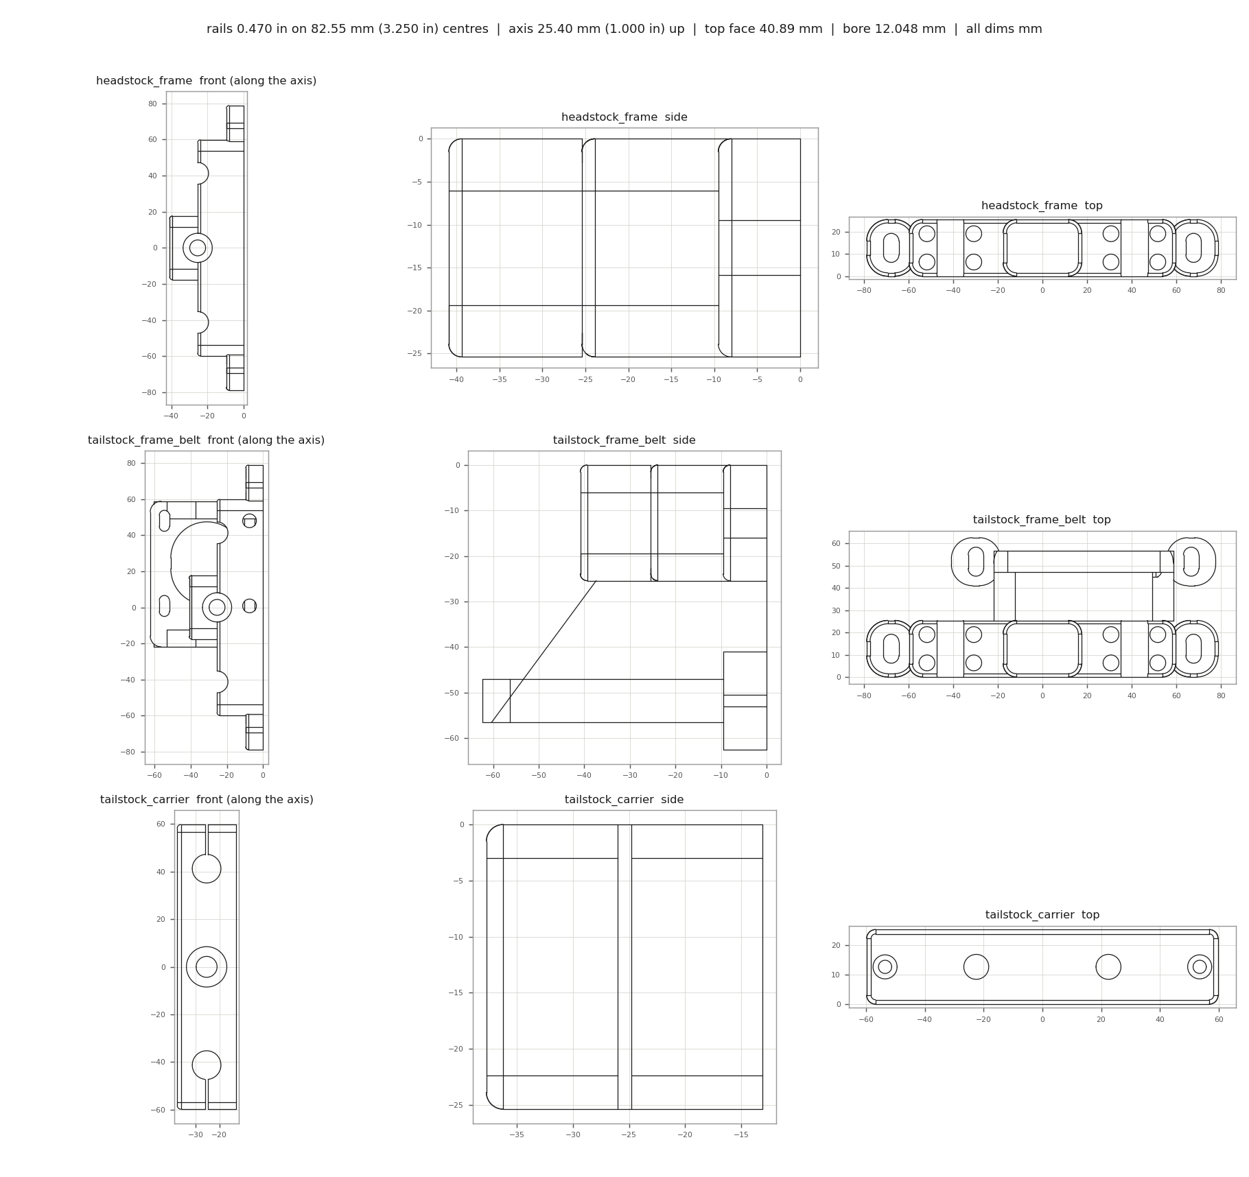
site/media/drawings_bases.png
