revjmoney/revturn-lathe-firmware/site/media/res-c-waterfall.jpg

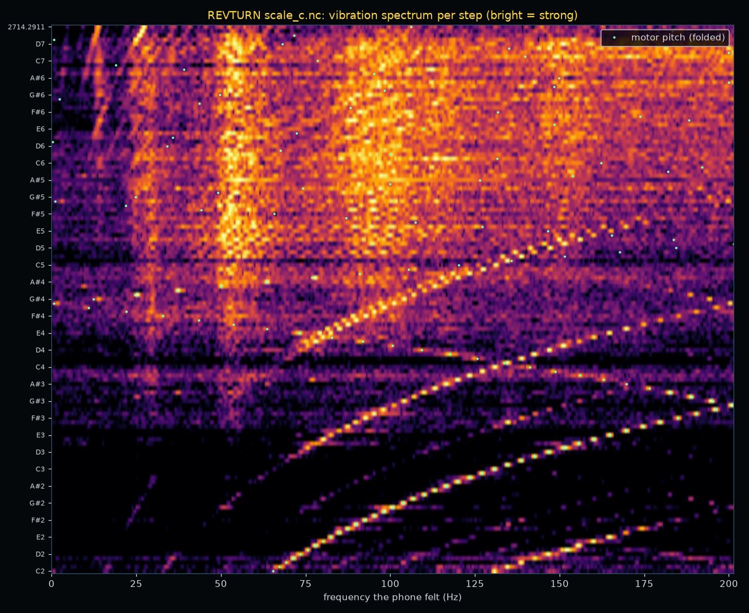
site/media/res-c-waterfall.jpg
