revjmoney/revturn-lathe-firmware/site/media/res-chords.png

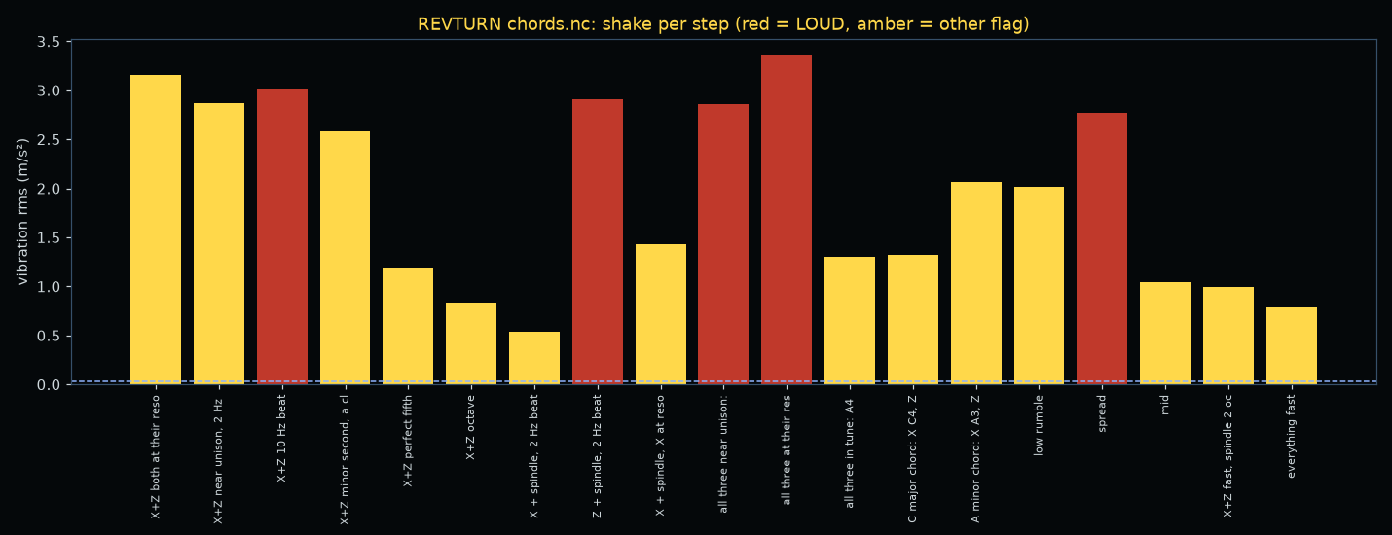
site/media/res-chords.png
