revjmoney/revturn-lathe-firmware/site/media/res-x-waterfall.jpg

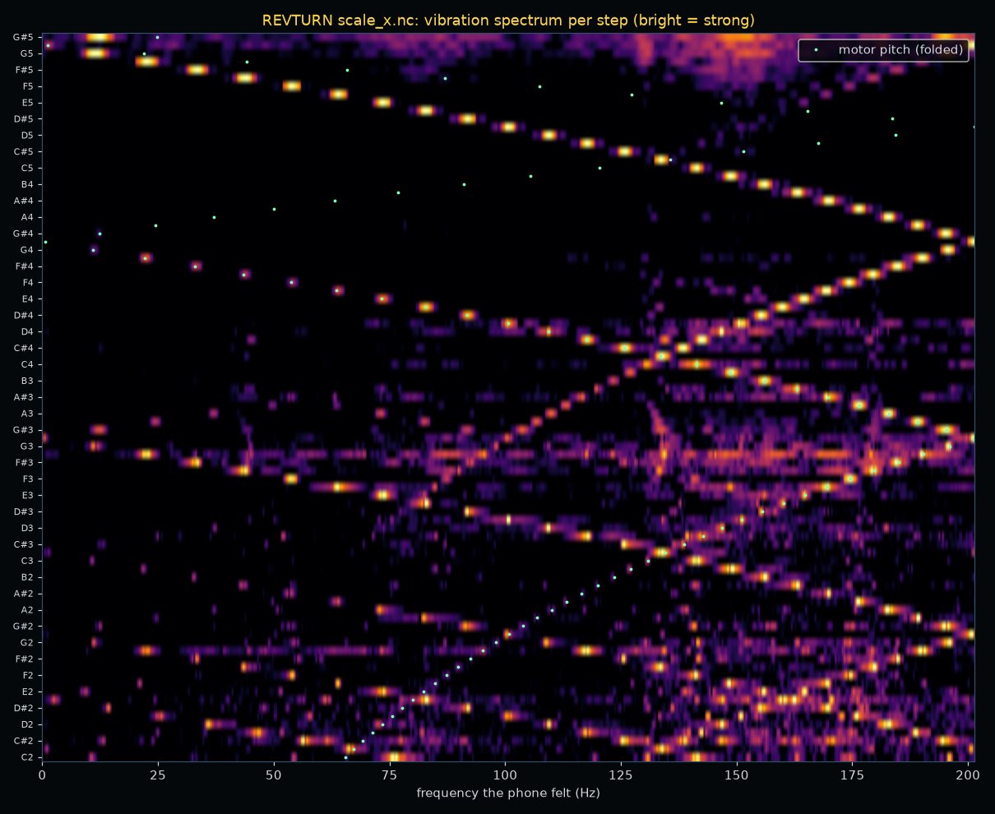
site/media/res-x-waterfall.jpg
