revjmoney/revturn-lathe-firmware/site/media/res-z-rms.png

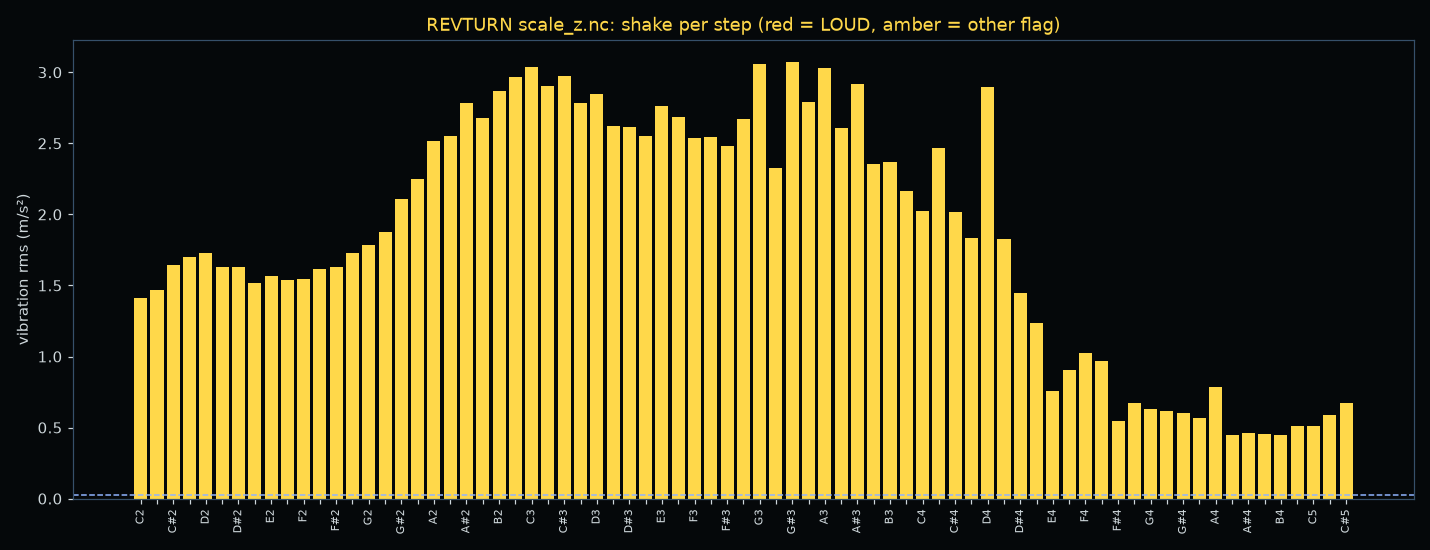
site/media/res-z-rms.png
