revjmoney/revturn-lathe-firmware/site/media/res-z-waterfall.jpg

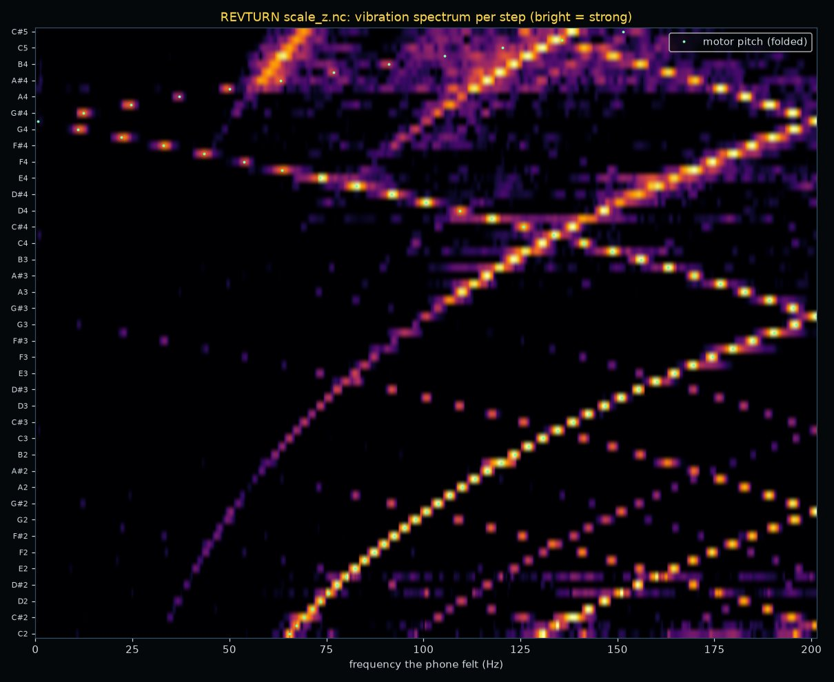
site/media/res-z-waterfall.jpg
