revjmoney/revturn-lathe-firmware/site/media/revturn-board.jpg

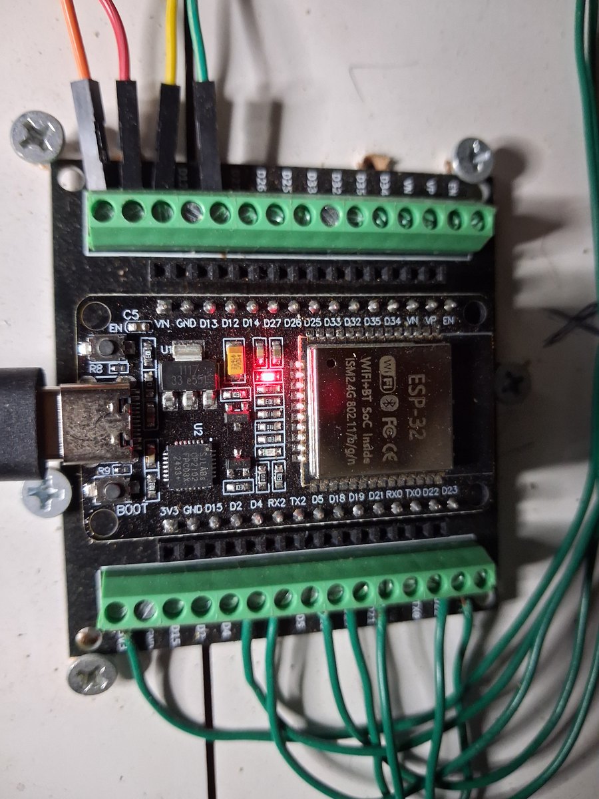
site/media/revturn-board.jpg
