revjmoney/revturn-lathe-firmware/site/media/screen-about.png

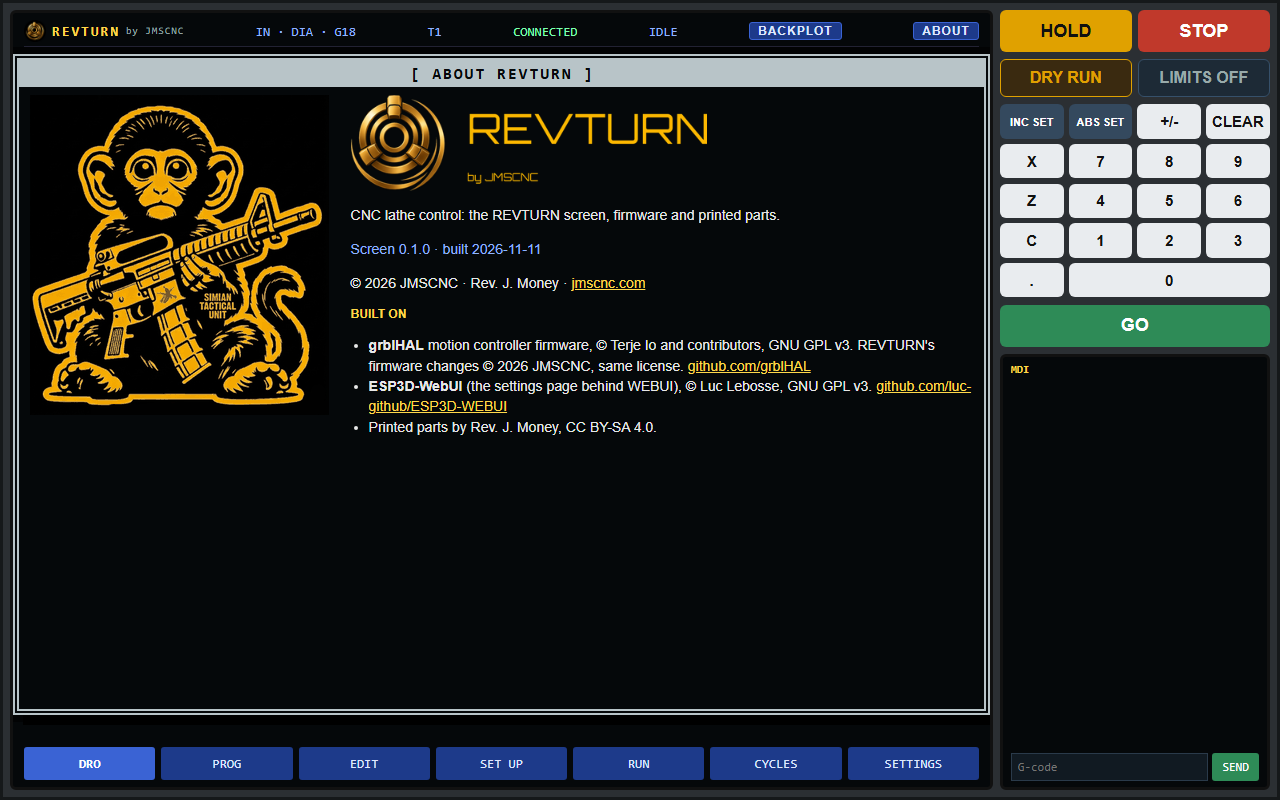
site/media/screen-about.png
