revjmoney/revturn-lathe-firmware/site/media/screen-cycles-face.png

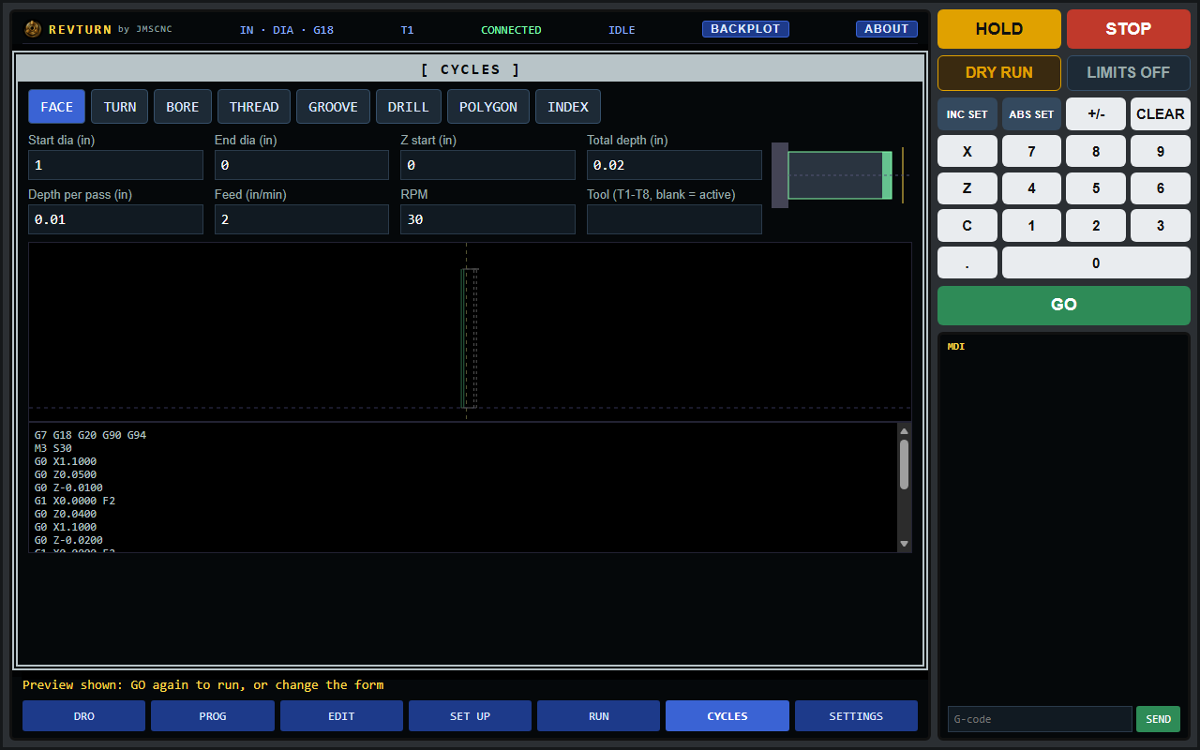
site/media/screen-cycles-face.png
