revjmoney/revturn-lathe-firmware/site/media/screen-cycles-turn.png

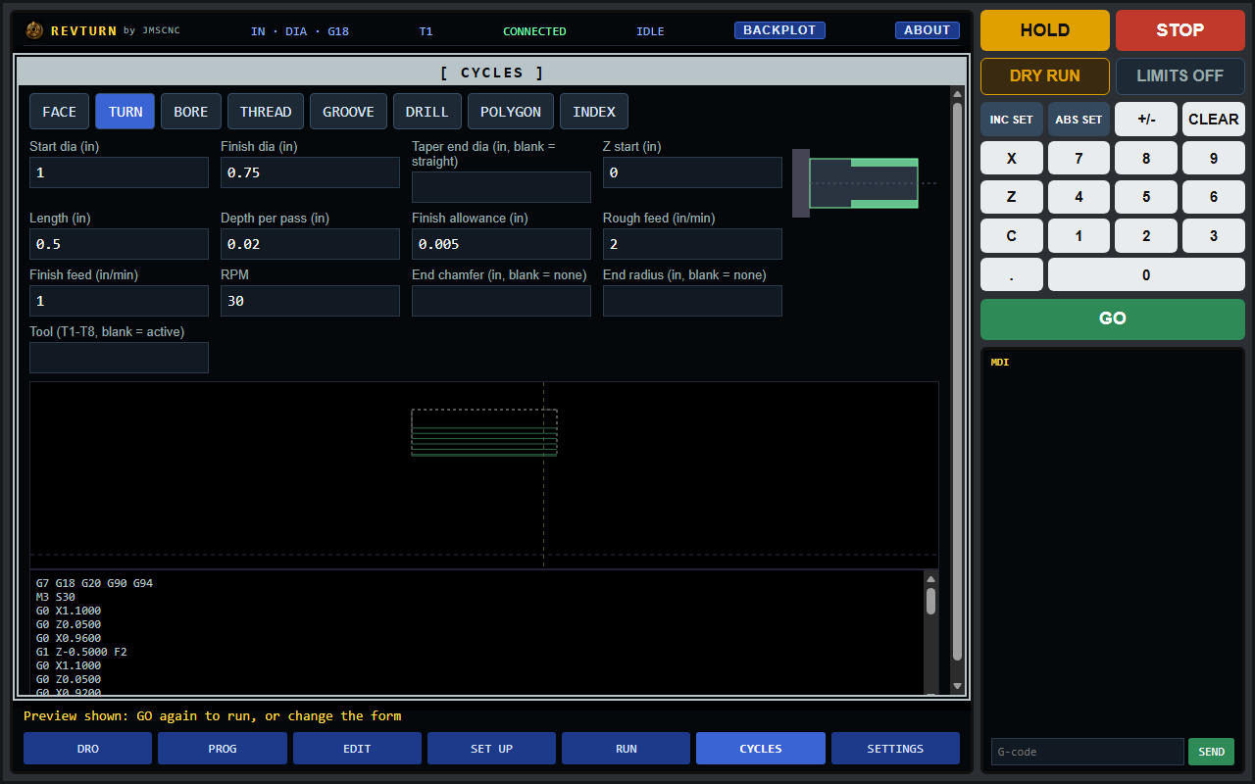
site/media/screen-cycles-turn.png
