revjmoney/revturn-lathe-firmware/site/media/screen-edit.png

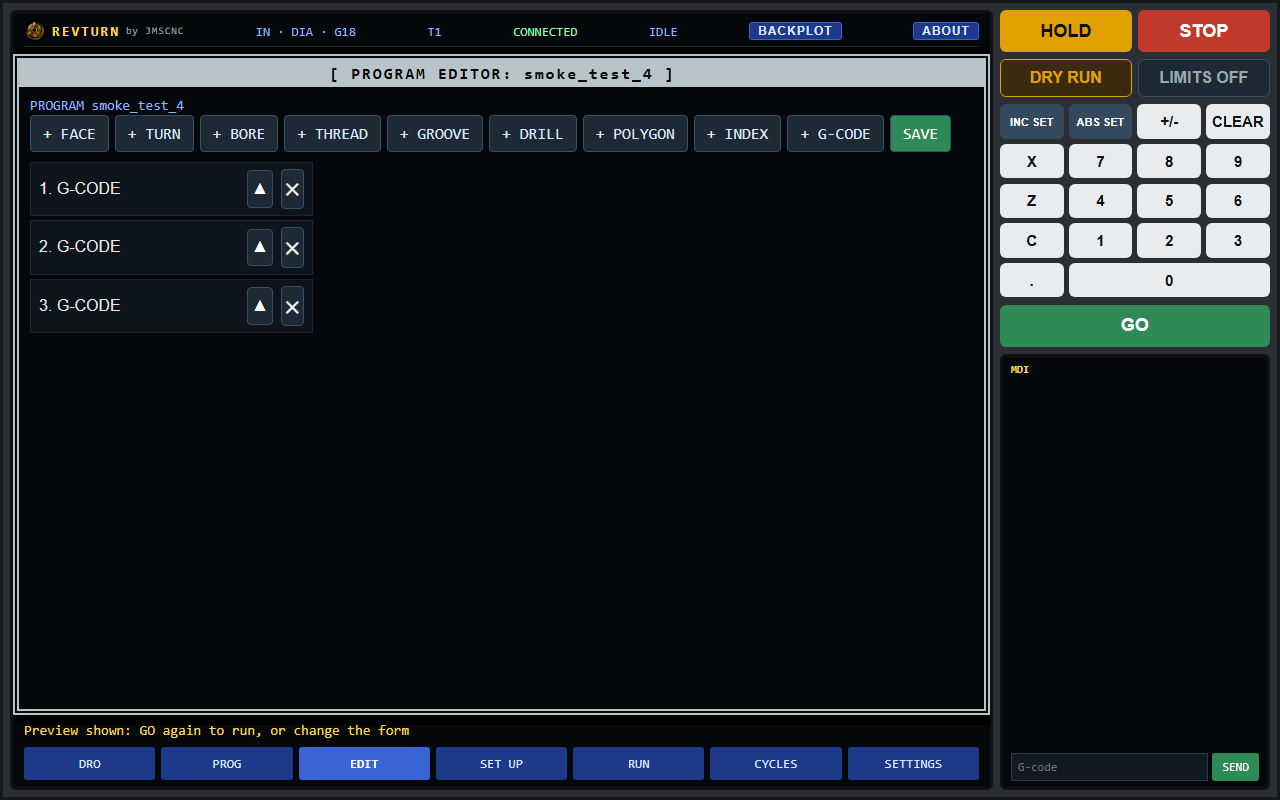
site/media/screen-edit.png
