revjmoney/revturn-lathe-firmware/site/media/screen-prog.png

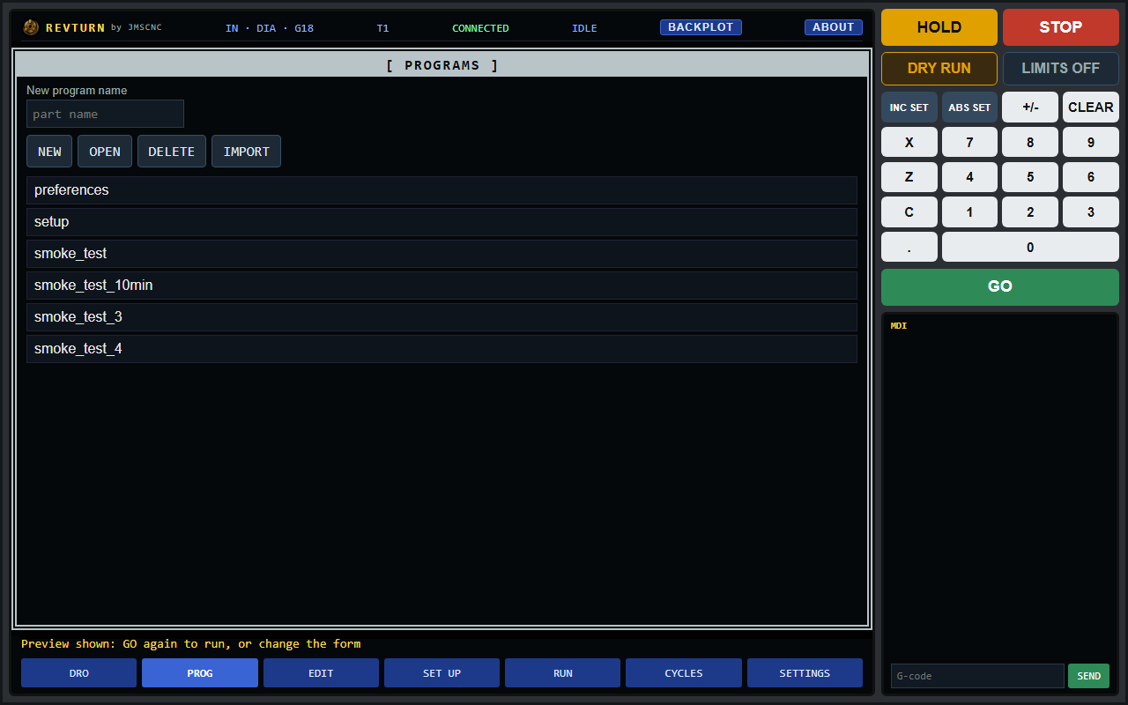
site/media/screen-prog.png
