revjmoney/revturn-lathe-firmware/site/media/screen-settings-general.png

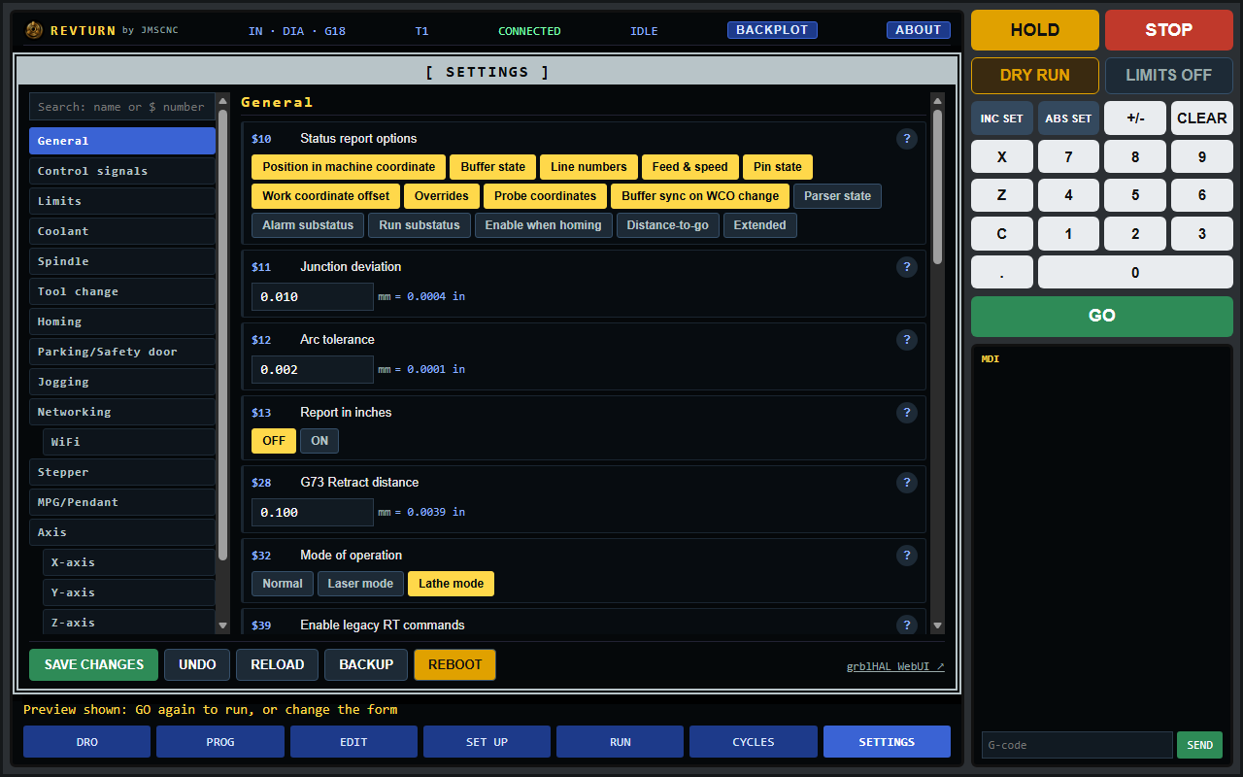
site/media/screen-settings-general.png
