revjmoney/revturn-lathe-firmware/site/media/screen-settings-spindle.png

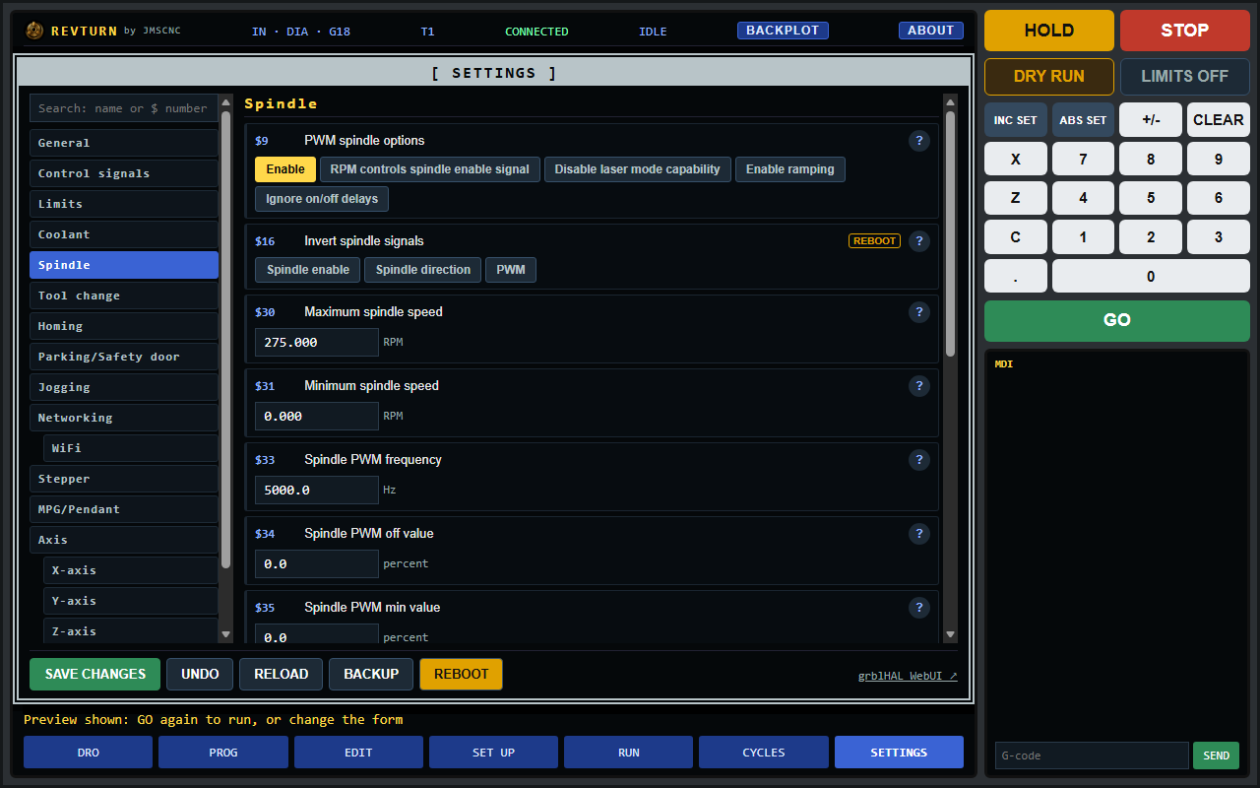
site/media/screen-settings-spindle.png
