revjmoney/revturn-lathe-firmware/site/media/tool_post_angles_top.png

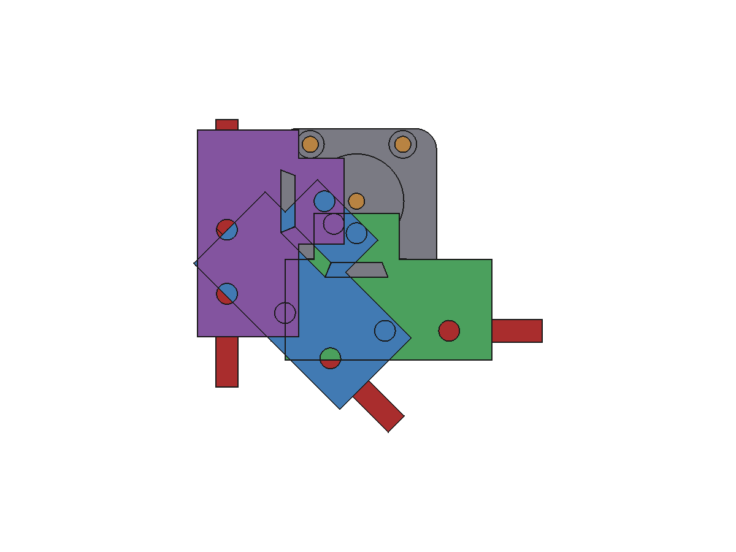
site/media/tool_post_angles_top.png
