revjmoney/revturn-lathe-firmware/site/media/tool_post_solid_quarter_iso.png

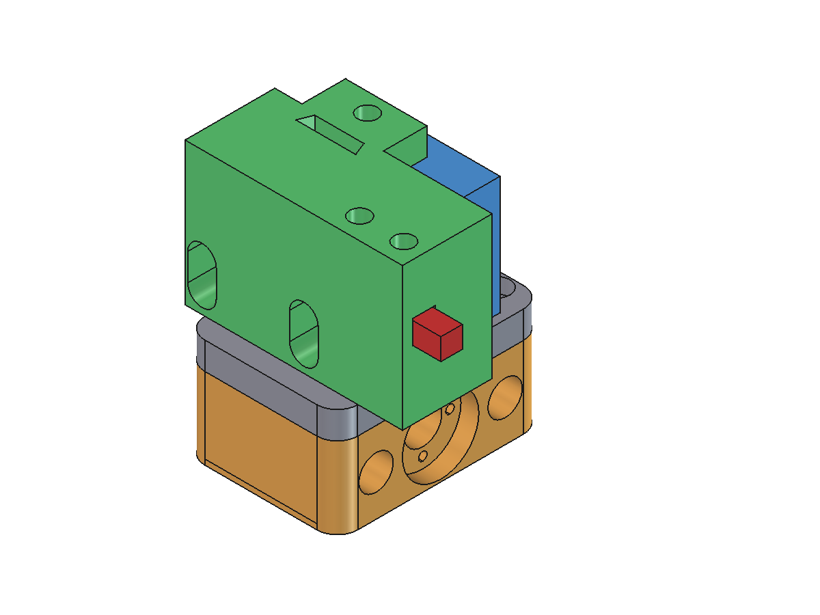
site/media/tool_post_solid_quarter_iso.png
