revjmoney/revturn-lathe-firmware/site/media/x_motor_inline_rail_mount_both_options.png

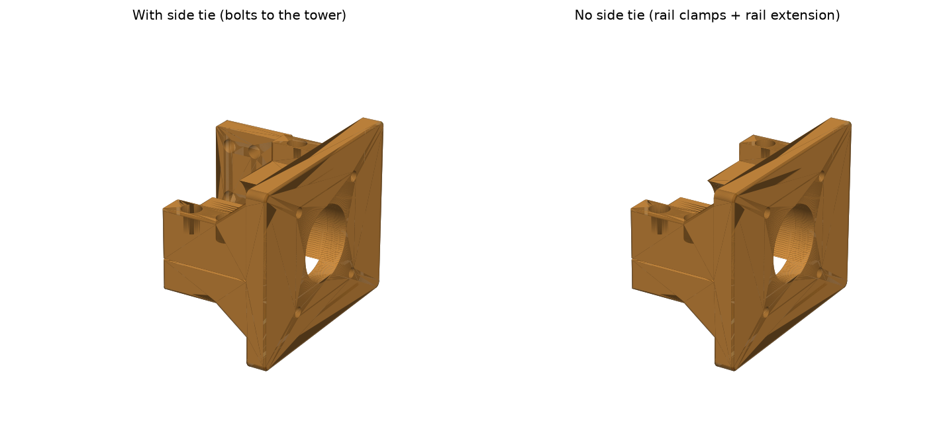
site/media/x_motor_inline_rail_mount_both_options.png
