revjmoney/revturn-lathe-firmware/tools/resonance/runs/chords-2026-11-11T19-04-08/waterfall.png

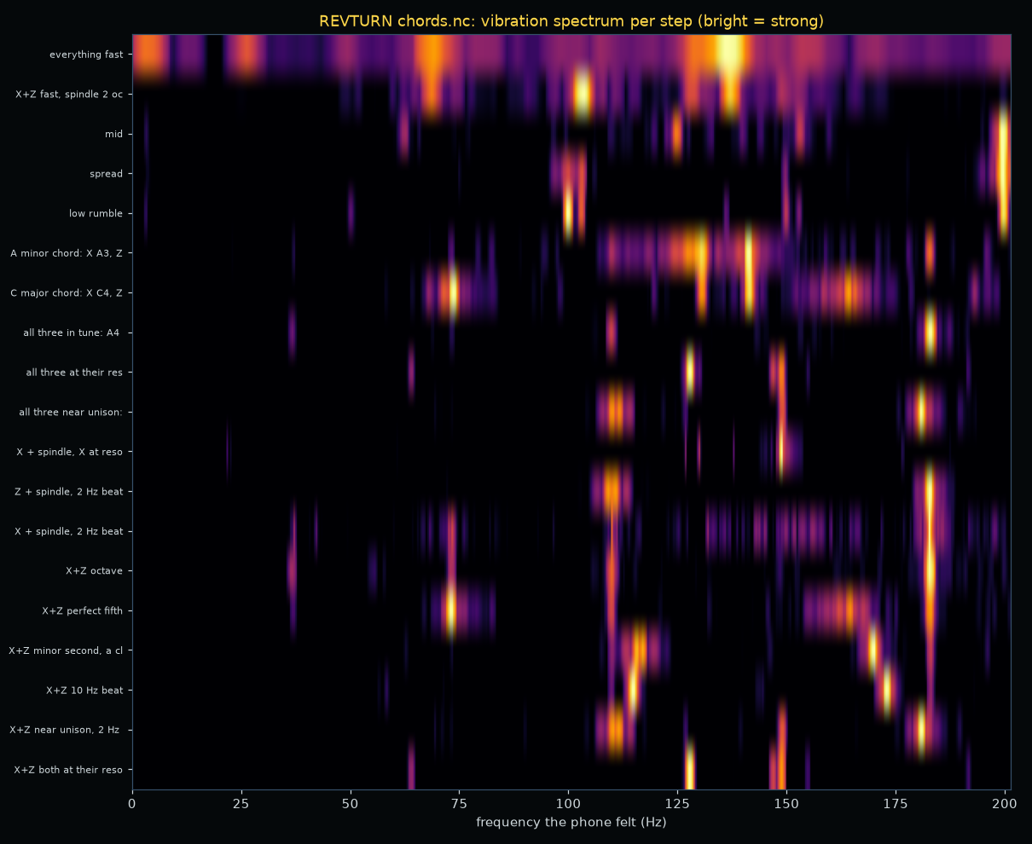
tools/resonance/runs/chords-2026-11-11T19-04-08/waterfall.png
