revjmoney/revturn-lathe-firmware/tools/resonance/runs/ode_to_joy-2026-11-11T21-31-43/song_shake.png

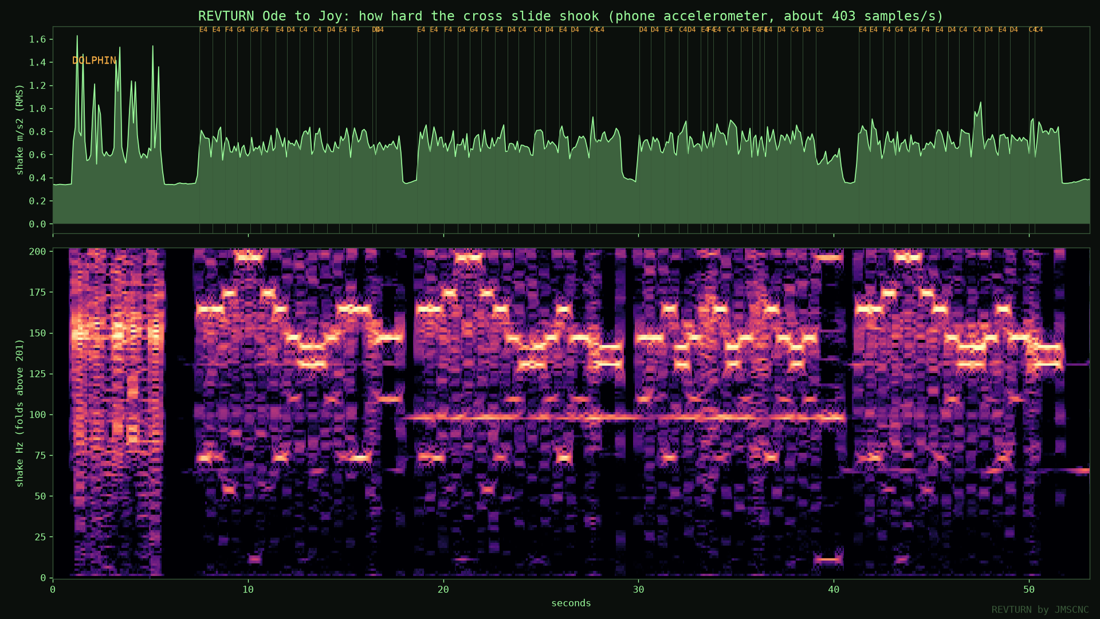
tools/resonance/runs/ode_to_joy-2026-11-11T21-31-43/song_shake.png
