revjmoney/revturn-lathe-firmware/tools/resonance/runs/ode_to_joy-2026-11-11T21-31-43/song_spectrogram.png

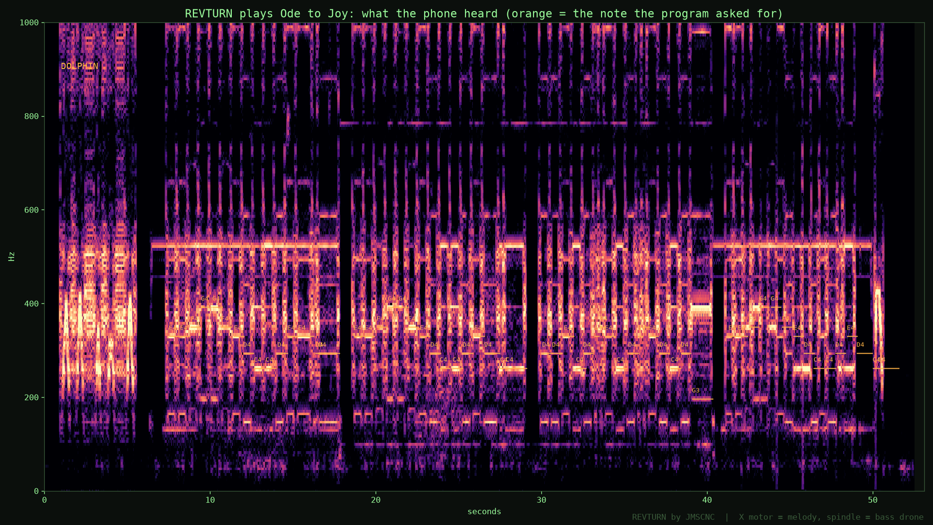
tools/resonance/runs/ode_to_joy-2026-11-11T21-31-43/song_spectrogram.png
