revjmoney/revturn-lathe-firmware/tools/resonance/runs/ode_to_joy_take1-2026-11-11T21-29-43/song_pitch.png

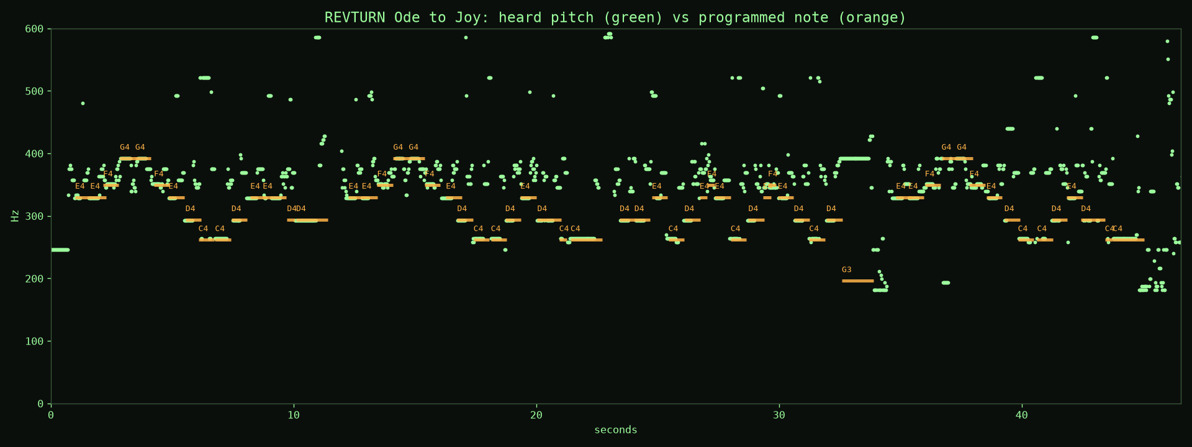
tools/resonance/runs/ode_to_joy_take1-2026-11-11T21-29-43/song_pitch.png
