revjmoney/revturn-lathe-firmware/tools/resonance/runs/ode_to_joy_zbass-2026-11-11T21-33-22/song_pitch.png

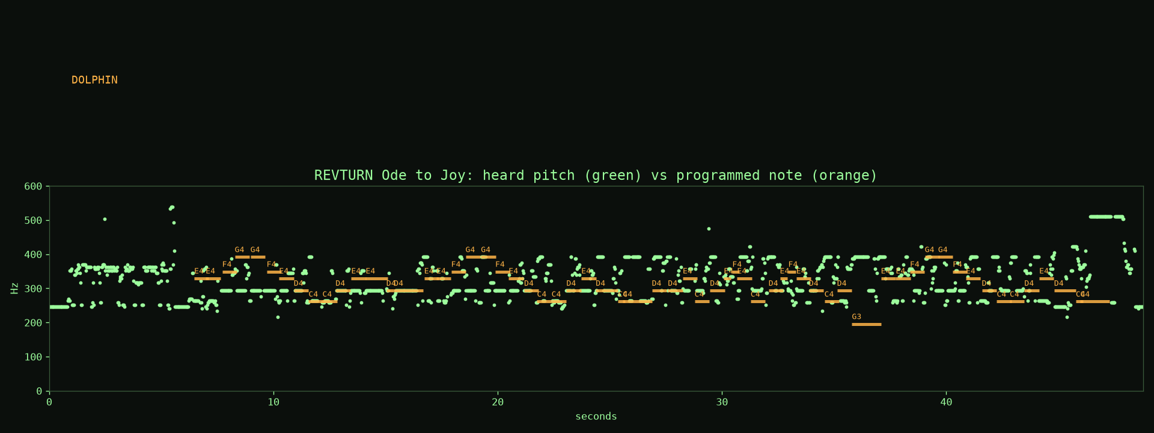
tools/resonance/runs/ode_to_joy_zbass-2026-11-11T21-33-22/song_pitch.png
