revjmoney/revturn-lathe-firmware/tools/resonance/runs/scale_c-2026-11-11T18-59-36/rms.png

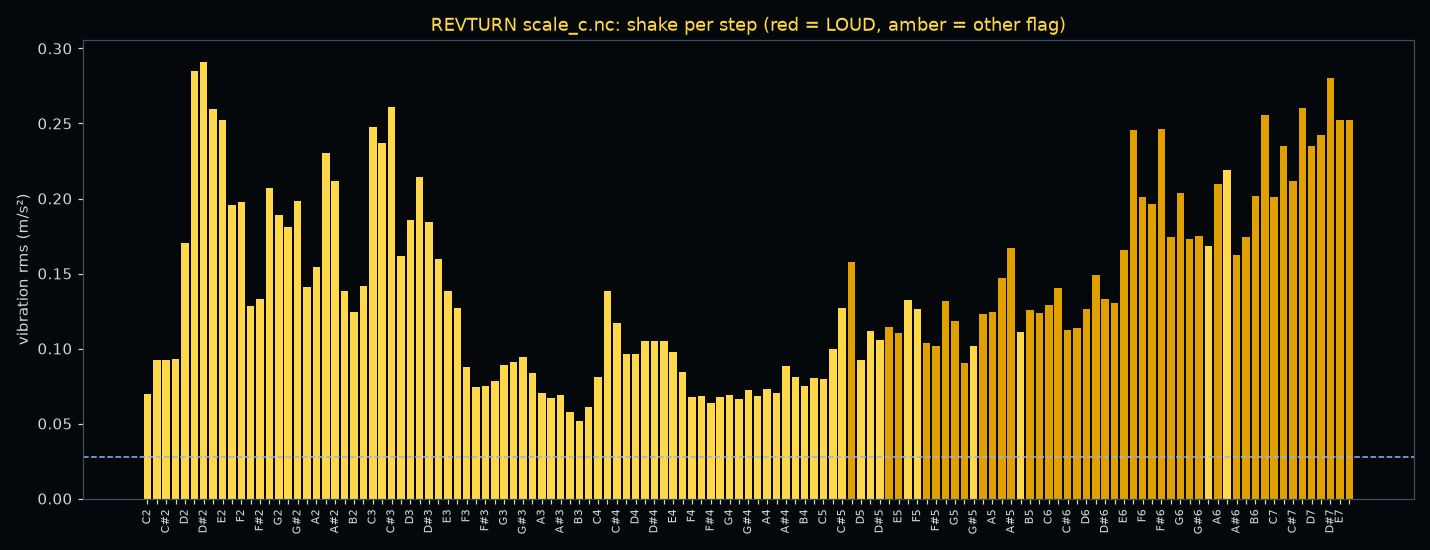
tools/resonance/runs/scale_c-2026-11-11T18-59-36/rms.png
