revjmoney/revturn-lathe-firmware/tools/resonance/runs/scale_x-2026-11-11T18-37-28/rms.png

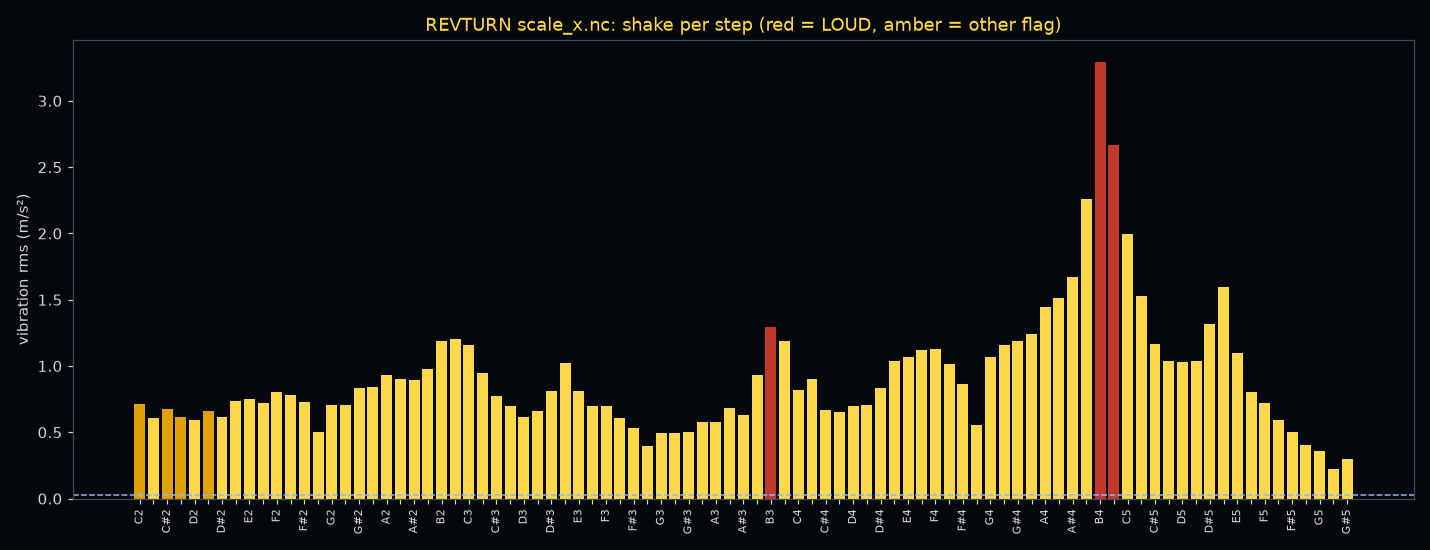
tools/resonance/runs/scale_x-2026-11-11T18-37-28/rms.png
