revjmoney/revturn-lathe-firmware/tools/resonance/runs/spindle_sweep-2026-11-11T17-56-22/report.png

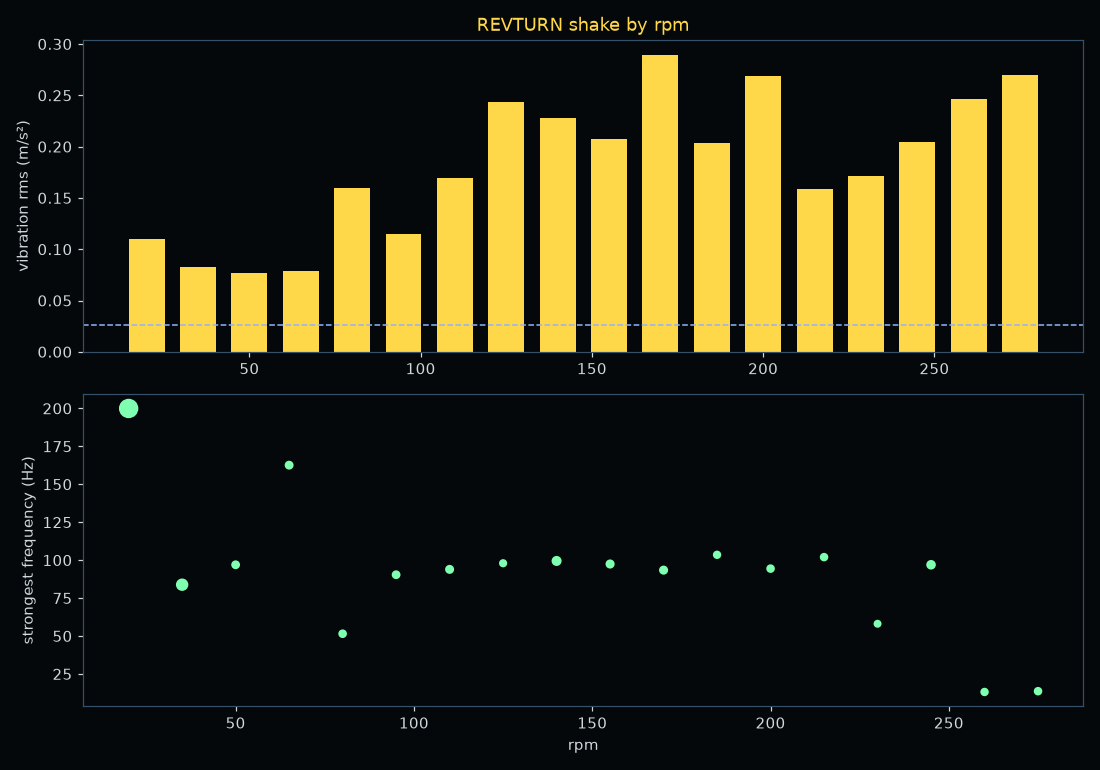
tools/resonance/runs/spindle_sweep-2026-11-11T17-56-22/report.png
