revjmoney/revturn-lathe-firmware/tools/resonance/runs/x_sweep-2026-11-11T17-59-14/report.png

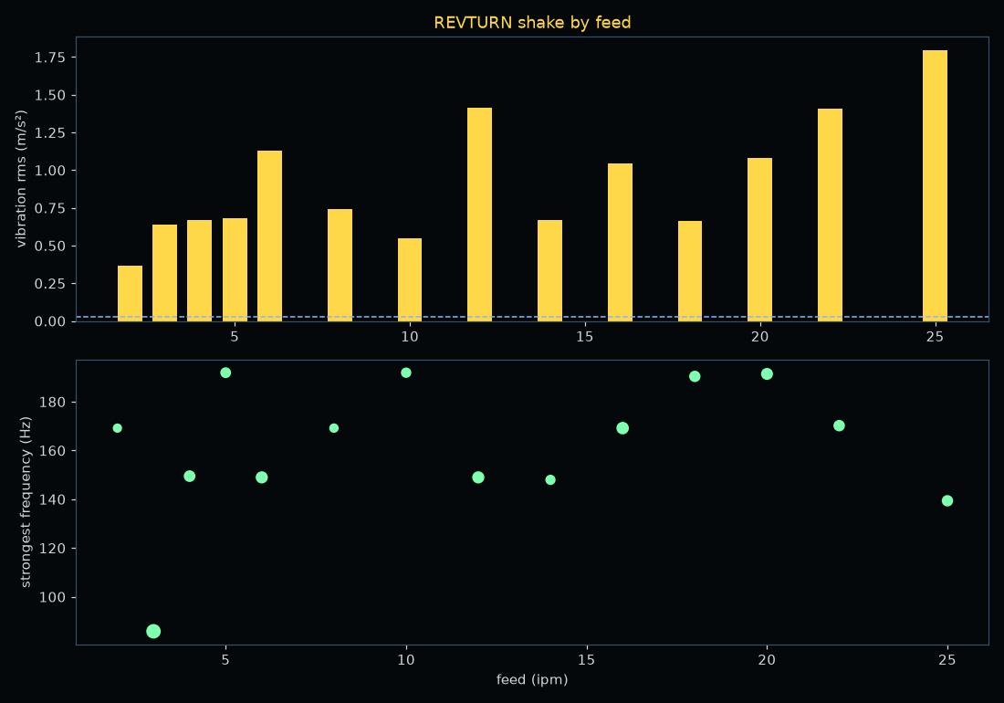
tools/resonance/runs/x_sweep-2026-11-11T17-59-14/report.png
