revjmoney/revturn-lathe-firmware/tools/resonance/runs/x_sweep_long-2026-11-11T18-24-11/report.png

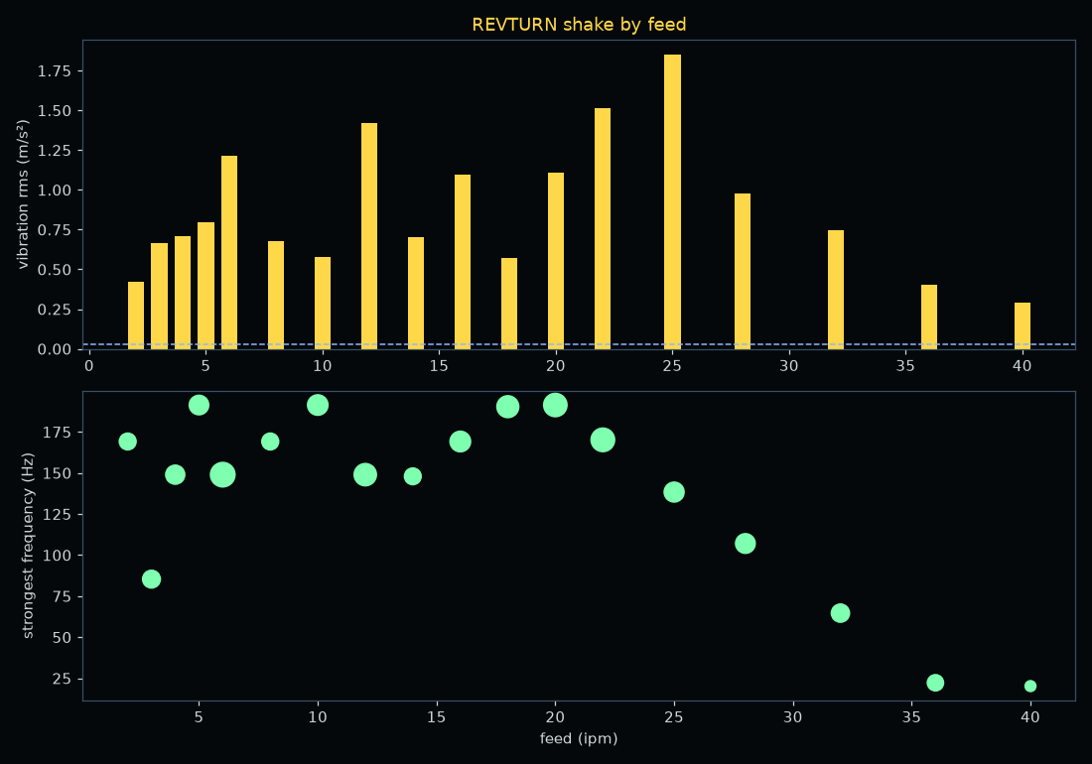
tools/resonance/runs/x_sweep_long-2026-11-11T18-24-11/report.png
