revjmoney/revturn-lathe-firmware/tools/resonance/runs/z_sweep-2026-11-11T18-04-04/report.png

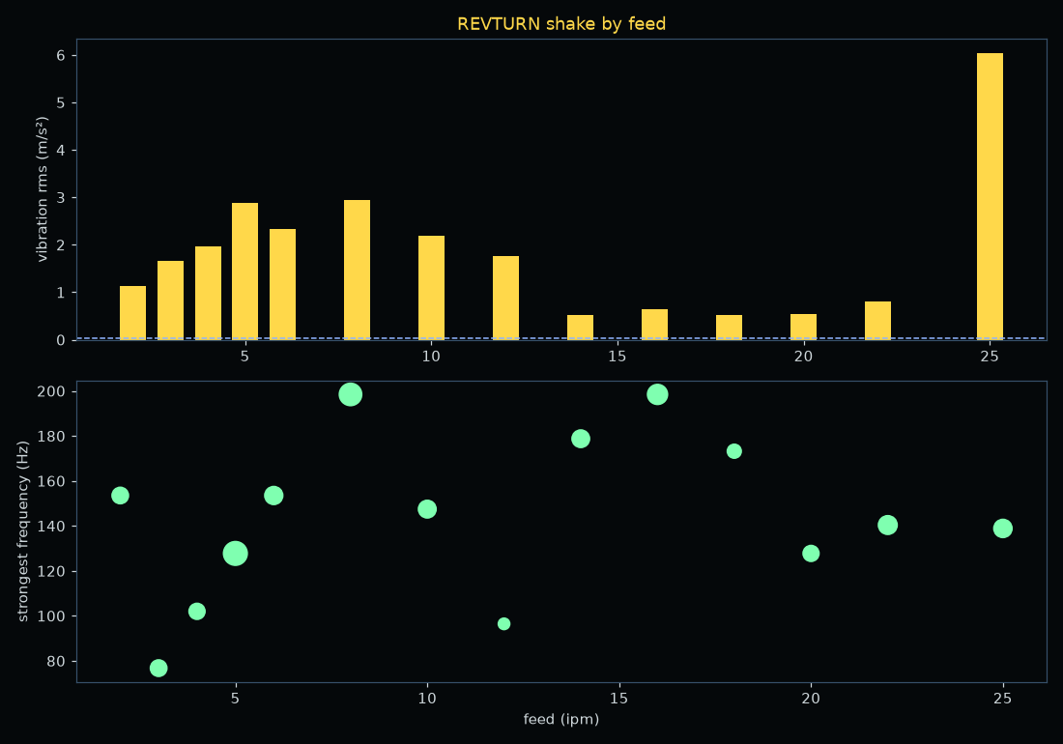
tools/resonance/runs/z_sweep-2026-11-11T18-04-04/report.png
