revjmoney/revturn-lathe-firmware/tools/resonance/runs/ode_to_joy-2026-11-11T21-31-43/song_notes.csv

note | hz | heard_median_hz | in_tune
E4 | 329.63 | 351.6 | True
E4 | 329.63 | 366.2 | True
F4 | 349.23 | 351.6 | True
G4 | 392 | 521.5 | False
G4 | 392 | 377.9 | True
F4 | 349.23 | 345.7 | True
E4 | 329.63 | 351.6 | True
D4 | 293.66 | 521.5 | False
C4 | 261.63 | 263.7 | True
C4 | 261.63 | 521.5 | True
D4 | 293.66 | 451.2 | False
E4 | 329.63 | 521.5 | False
E4 | 329.63 | 328.1 | True
D4 | 293.66 | 360.4 | False
D4 | 293.66 | 521.5 | False
E4 | 329.63 | 328.1 | True
E4 | 329.63 | 328.1 | True
F4 | 349.23 | 351.6 | True
G4 | 392 | 369.1 | True
G4 | 392 | 383.8 | True
F4 | 349.23 | 351.6 | True
E4 | 329.63 | 328.1 | True
D4 | 293.66 | 293.0 | True
C4 | 261.63 | 521.5 | True
C4 | 261.63 | 263.7 | True
D4 | 293.66 | 293.0 | True
E4 | 329.63 | 328.1 | True
D4 | 293.66 | 293.0 | True
C4 | 261.63 | 369.1 | True
C4 | 261.63 | 521.5 | True
D4 | 293.66 | 360.4 | True
D4 | 293.66 | 398.4 | True
E4 | 329.63 | 348.6 | True
C4 | 261.63 | 375.0 | True
D4 | 293.66 | 293.0 | True
E4 | 329.63 | 351.6 | False
F4 | 349.23 | 339.8 | True
E4 | 329.63 | 380.9 | False
C4 | 261.63 | 263.7 | True
D4 | 293.66 | 369.1 | False
E4 | 329.63 | 345.7 | False
F4 | 349.23 | 369.1 | False
E4 | 329.63 | 328.1 | True
D4 | 293.66 | 369.1 | True
C4 | 261.63 | 263.7 | True
D4 | 293.66 | 293.0 | True
G3 | 196 | 392.6 | True
E4 | 329.63 | 369.1 | False
E4 | 329.63 | 351.6 | False
F4 | 349.23 | 392.6 | False
G4 | 392 | 521.5 | False
G4 | 392 | 436.5 | False
F4 | 349.23 | 521.5 | False
E4 | 329.63 | 263.7 | False
D4 | 293.66 | 304.7 | False
C4 | 261.63 | 521.5 | True
C4 | 261.63 | 521.5 | True
D4 | 293.66 | 304.7 | False
E4 | 329.63 | 357.4 | False
D4 | 293.66 | 521.5 | False
C4 | 261.63 | 398.4 | False
C4 | 261.63 | 246.1 | False
