revjmoney/revturn-lathe-firmware/tools/resonance/runs/ode_to_joy_take1-2026-11-11T21-29-43/song_notes.csv

note | hz | heard_median_hz | in_tune
E4 | 329.63 | 363.3 | False
E4 | 329.63 | 348.6 | True
F4 | 349.23 | 351.6 | True
G4 | 392 | 392.6 | True
G4 | 392 | 392.6 | True
F4 | 349.23 | 351.6 | True
E4 | 329.63 | 357.4 | False
D4 | 293.66 | 345.7 | True
C4 | 261.63 | 521.5 | True
C4 | 261.63 | 263.7 | True
D4 | 293.66 | 331.1 | True
E4 | 329.63 | 375.0 | False
E4 | 329.63 | 328.1 | True
D4 | 293.66 | 369.1 | False
D4 | 293.66 | 293.0 | True
E4 | 329.63 | 369.1 | True
E4 | 329.63 | 392.6 | False
F4 | 349.23 | 351.6 | True
G4 | 392 | 392.6 | True
G4 | 392 | 392.6 | True
F4 | 349.23 | 351.6 | True
E4 | 329.63 | 369.1 | False
D4 | 293.66 | 351.6 | True
C4 | 261.63 | 263.7 | True
C4 | 261.63 | 263.7 | True
D4 | 293.66 | 366.2 | True
E4 | 329.63 | 342.8 | True
D4 | 293.66 | 345.7 | True
C4 | 261.63 | 380.9 | False
C4 | 261.63 | 263.7 | True
D4 | 293.66 | 316.4 | True
D4 | 293.66 | 293.0 | True
E4 | 329.63 | 351.6 | True
C4 | 261.63 | 263.7 | True
D4 | 293.66 | 351.6 | False
E4 | 329.63 | 372.1 | False
F4 | 349.23 | 357.4 | True
E4 | 329.63 | 328.1 | True
C4 | 261.63 | 351.6 | True
D4 | 293.66 | 345.7 | False
E4 | 329.63 | 351.6 | False
F4 | 349.23 | 345.7 | True
E4 | 329.63 | 328.1 | True
D4 | 293.66 | 322.3 | True
C4 | 261.63 | 313.5 | True
D4 | 293.66 | 369.1 | True
G3 | 196 | 392.6 | True
E4 | 329.63 | 351.6 | False
E4 | 329.63 | 328.1 | True
F4 | 349.23 | 351.6 | True
G4 | 392 | 345.7 | False
G4 | 392 | 375.0 | True
F4 | 349.23 | 351.6 | True
E4 | 329.63 | 328.1 | True
D4 | 293.66 | 369.1 | False
C4 | 261.63 | 263.7 | True
C4 | 261.63 | 369.1 | True
D4 | 293.66 | 351.6 | False
E4 | 329.63 | 334.0 | True
D4 | 293.66 | 363.3 | True
C4 | 261.63 | 351.6 | True
C4 | 261.63 | 263.7 | True
