revjmoney/revturn-lathe-firmware/tools/resonance/runs/ode_to_joy_zbass-2026-11-11T21-33-22/song_notes.csv

note | hz | heard_median_hz | in_tune
E4 | 329.63 | 322.3 | False
E4 | 329.63 | 263.7 | False
F4 | 349.23 | 293.0 | False
G4 | 392 | 293.0 | False
G4 | 392 | 293.0 | False
F4 | 349.23 | 293.0 | False
E4 | 329.63 | 293.0 | False
D4 | 293.66 | 304.7 | True
C4 | 261.63 | 263.7 | True
C4 | 261.63 | 263.7 | True
D4 | 293.66 | 293.0 | True
E4 | 329.63 | 293.0 | False
E4 | 329.63 | 293.0 | False
D4 | 293.66 | 796.9 | False
D4 | 293.66 | 293.0 | True
E4 | 329.63 | 351.6 | False
E4 | 329.63 | 328.1 | False
F4 | 349.23 | 293.0 | False
G4 | 392 | 293.0 | False
G4 | 392 | 304.7 | False
F4 | 349.23 | 293.0 | False
E4 | 329.63 | 293.0 | False
D4 | 293.66 | 313.5 | True
C4 | 261.63 | 345.7 | False
C4 | 261.63 | 257.8 | True
D4 | 293.66 | 351.6 | False
E4 | 329.63 | 293.0 | False
D4 | 293.66 | 293.0 | True
C4 | 261.63 | 820.3 | False
C4 | 261.63 | 263.7 | True
D4 | 293.66 | 392.6 | False
D4 | 293.66 | 293.0 | True
E4 | 329.63 | 357.4 | False
C4 | 261.63 | 293.0 | False
D4 | 293.66 | 369.1 | False
E4 | 329.63 | 342.8 | True
F4 | 349.23 | 823.2 | False
E4 | 329.63 | 392.6 | False
C4 | 261.63 | 293.0 | False
D4 | 293.66 | 366.2 | True
E4 | 329.63 | 319.3 | False
F4 | 349.23 | 284.2 | False
E4 | 329.63 | 304.7 | False
D4 | 293.66 | 328.1 | True
C4 | 261.63 | 331.1 | False
D4 | 293.66 | 263.7 | False
G3 | 196 | 392.6 | True
E4 | 329.63 | 357.4 | False
E4 | 329.63 | 345.7 | False
F4 | 349.23 | 293.0 | False
G4 | 392 | 351.6 | False
G4 | 392 | 293.0 | False
F4 | 349.23 | 293.0 | False
E4 | 329.63 | 392.6 | False
D4 | 293.66 | 293.0 | True
C4 | 261.63 | 293.0 | False
C4 | 261.63 | 293.0 | False
D4 | 293.66 | 392.6 | False
E4 | 329.63 | 263.7 | False
D4 | 293.66 | 246.1 | False
C4 | 261.63 | 357.4 | False
C4 | 261.63 | 509.8 | True
