revjmoney/revturn-lathe-firmware/hardware/assembly/REVTURN_lathe_assembly.step

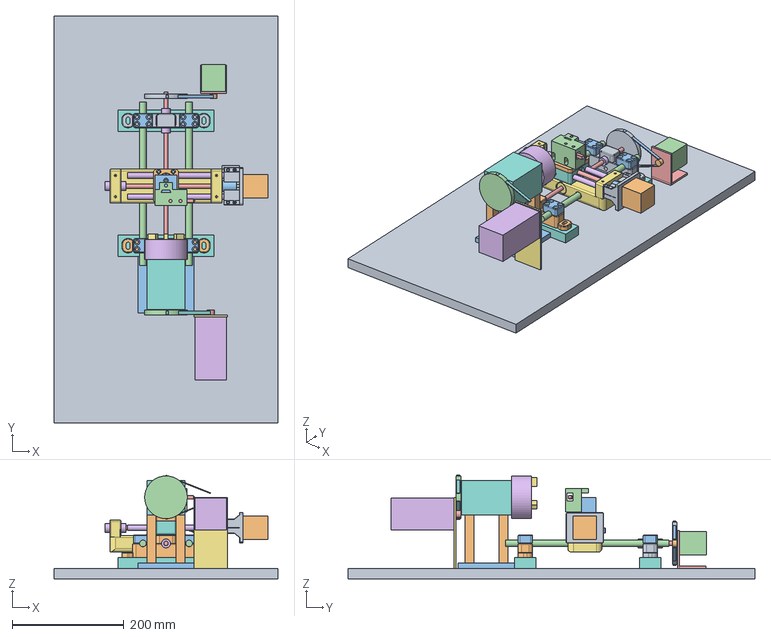
[picture p55: CAD file, 2026-11-11]
hardware/assembly/REVTURN_lathe_assembly.step
400.0 x 728.4 x 185.8 mm
