revjmoney/revturn-lathe-firmware/hardware/freecad/x-motor-mount/inline-rail-mount/inline_mount_assembly.FCStd

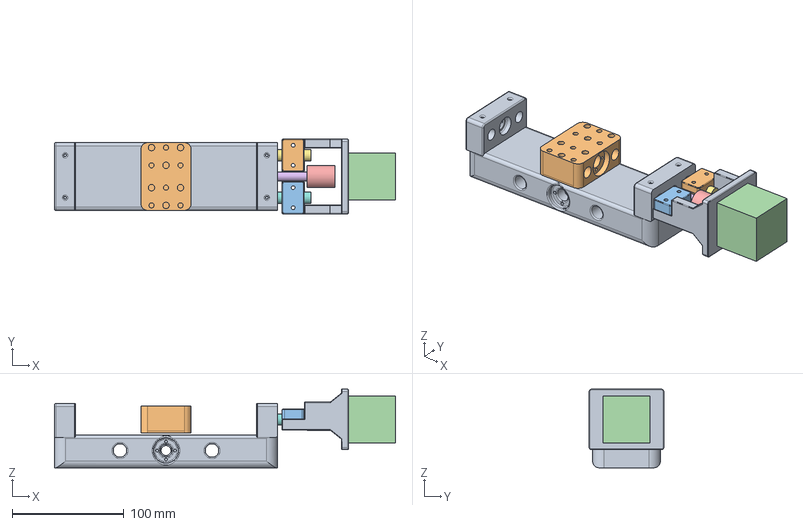
[picture p56: CAD file, 2026-11-11]
hardware/freecad/x-motor-mount/inline-rail-mount/inline_mount_assembly.FCStd
305.8 x 67.0 x 70.5 mm
MainBracket
ClampCapPositive
ClampCapNegative
MotorReference (NOT FOR PRINT)
CouplerReference (NOT FOR PRINT)
LeadscrewReference (NOT FOR PRINT)
RailPositiveReference (NOT FOR PRINT)
RailNegativeReference (NOT FOR PRINT)
SaddleReference (NOT FOR PRINT)
SlideReference (NOT FOR PRINT)
