revjmoney/revturn-lathe-firmware/hardware/freecad/x-motor-mount/split-rail-mount-no-side-tie/inline_no_side_tie_assembly.FCStd

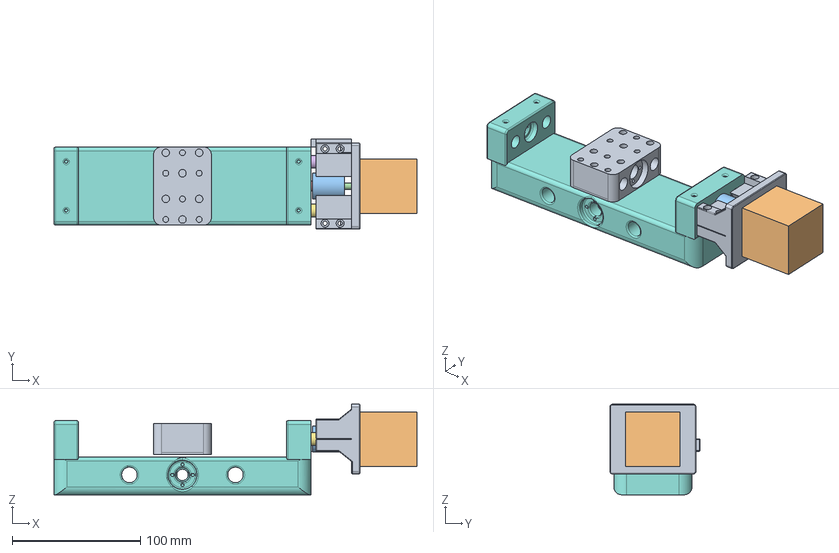
[picture p58: CAD file, 2026-11-11]
hardware/freecad/x-motor-mount/split-rail-mount-no-side-tie/inline_no_side_tie_assembly.FCStd
282.5 x 70.2 x 70.5 mm
main
motor (REFERENCE ONLY)
coupler (REFERENCE ONLY)
shaft (REFERENCE ONLY)
screw (REFERENCE ONLY)
rail_positive (REFERENCE ONLY)
rail_negative (REFERENCE ONLY)
saddle (REFERENCE ONLY)
slide (REFERENCE ONLY)
