revjmoney/revturn-lathe-firmware/hardware/freecad/x-motor-mount/inline-rail-mount/baseline/tailstock_carrier.step

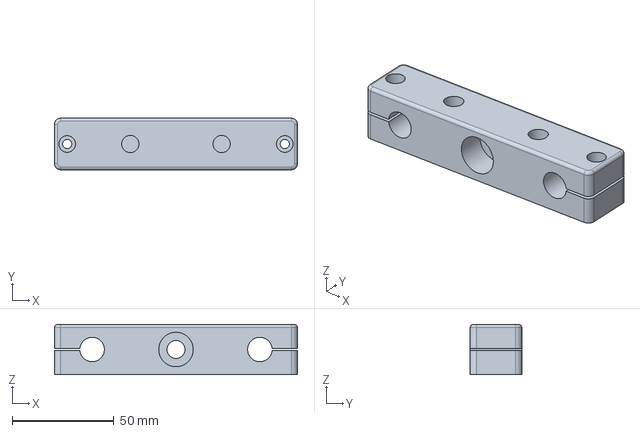
[picture p59: CAD file, 2026-11-11]
hardware/freecad/x-motor-mount/inline-rail-mount/baseline/tailstock_carrier.step
119.6 x 25.4 x 24.6 mm
