revjmoney/revturn-lathe-firmware/hardware/freecad/x-motor-mount/split-rail-mount-no-side-tie/inline_motor_mount_EXTENDED_SPLIT_CLAMPS_NO_SIDE_TIE.FCStd

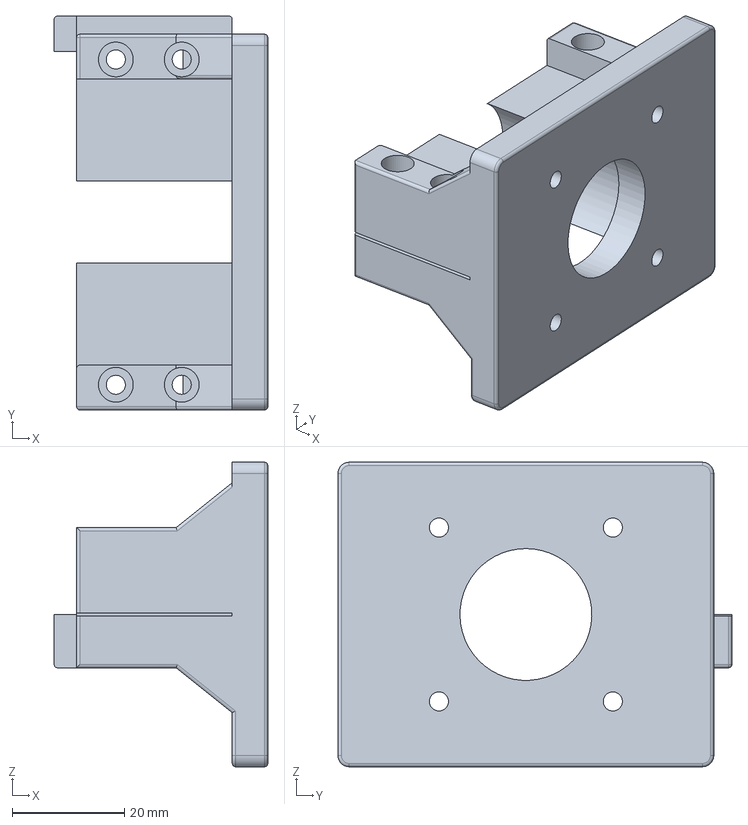
[picture p60: CAD file, 2026-11-11]
hardware/freecad/x-motor-mount/split-rail-mount-no-side-tie/inline_motor_mount_EXTENDED_SPLIT_CLAMPS_NO_SIDE_TIE.FCStd
38.1 x 70.2 x 54.3 mm
