revjmoney/revturn-lathe-firmware/hardware/freecad/x-motor-mount/split-rail-mount/inline_motor_mount_EXTENDED_SPLIT_CLAMPS.FCStd

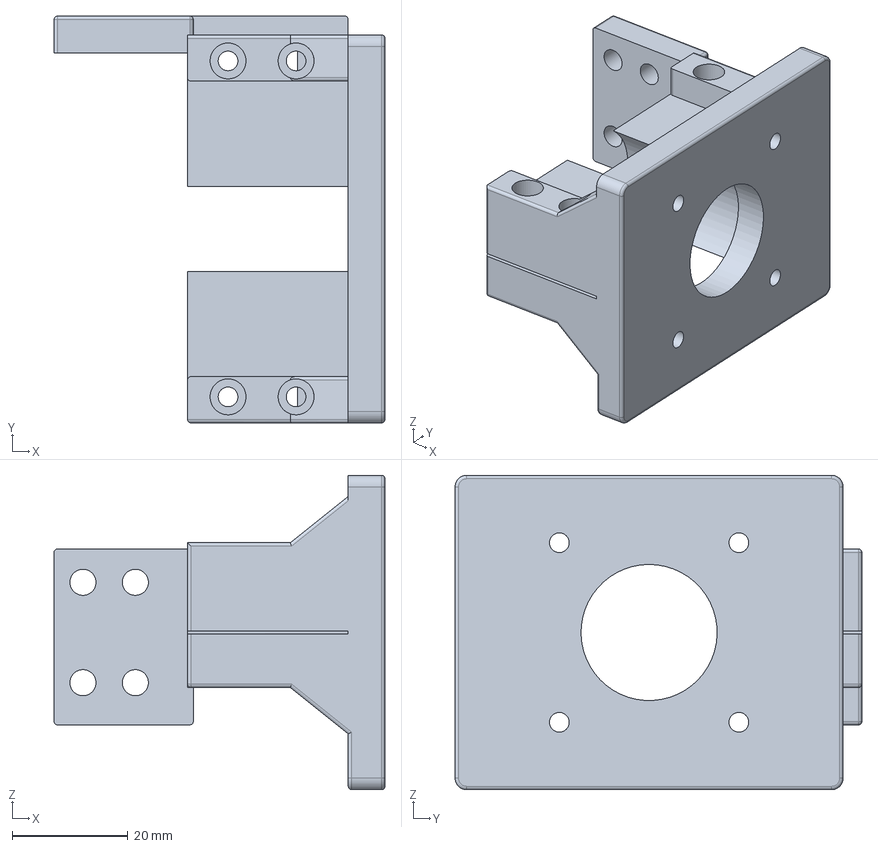
[picture p61: CAD file, 2026-11-11]
hardware/freecad/x-motor-mount/split-rail-mount/inline_motor_mount_EXTENDED_SPLIT_CLAMPS.FCStd
57.1 x 70.2 x 54.3 mm
