revjmoney/revturn-lathe-firmware/hardware/step/tool_post_holder_10mm_round.step

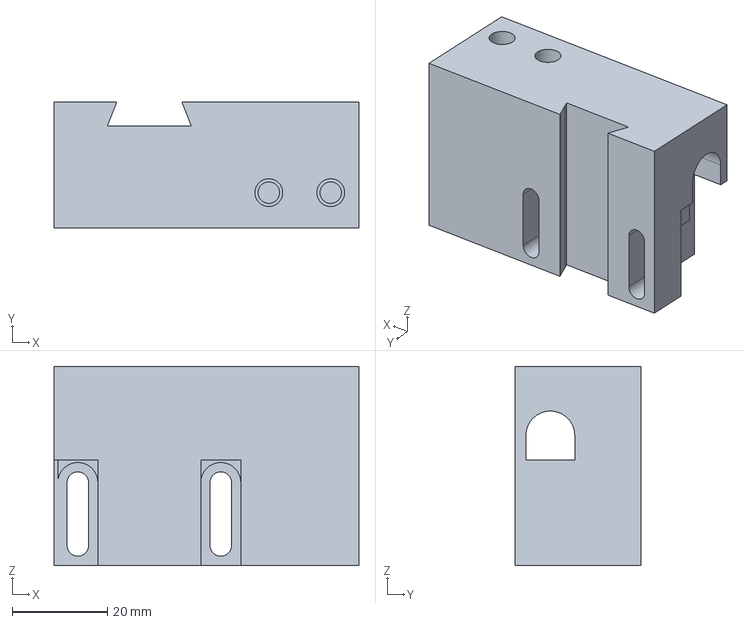
[picture p62: CAD file, 2026-11-14]
hardware/step/tool_post_holder_10mm_round.step
64.0 x 26.4 x 41.9 mm
