revjmoney/revturn-lathe-firmware/hardware/stl/tailstock_frame_belt.stl

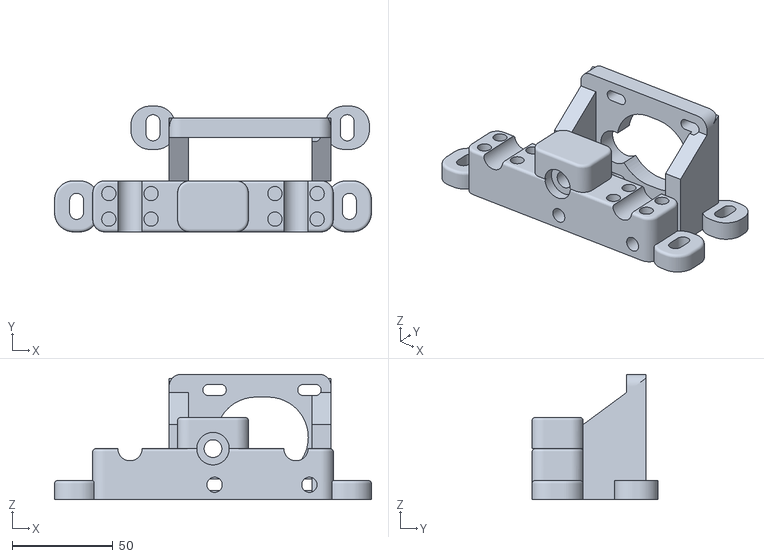
[picture p63: CAD file, 2026-11-09]
hardware/stl/tailstock_frame_belt.stl
157.6 x 62.5 x 62.4
