revjmoney/revturn-lathe-firmware/hardware/freecad/x-motor-mount/inline-rail-mount/baseline/x_belt_motor_bracket_r9.step

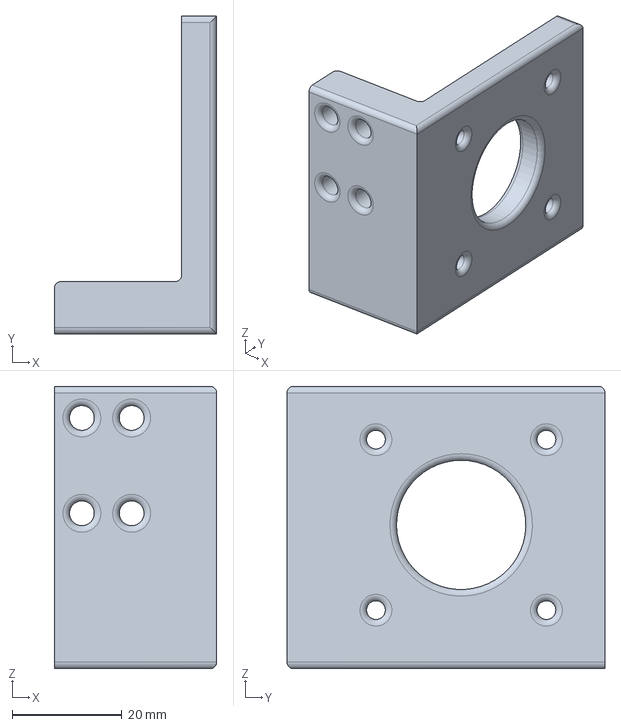
[picture p64: CAD file, 2026-11-09]
hardware/freecad/x-motor-mount/inline-rail-mount/baseline/x_belt_motor_bracket_r9.step
29.5 x 57.8 x 51.4 mm
