revjmoney/revturn-lathe-firmware/hardware/freecad/x-motor-mount/solid-half-rail-mount/baseline/headstock_frame.step

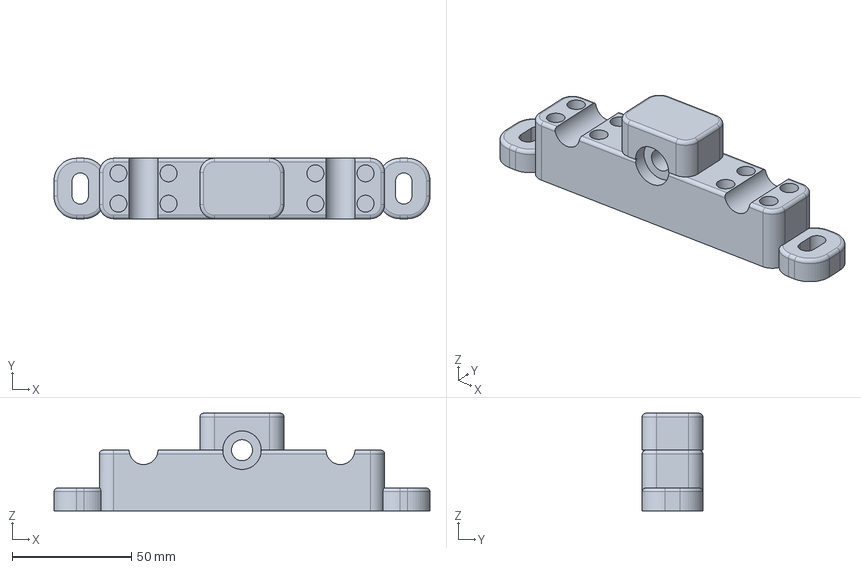
[picture p65: CAD file, 2026-11-09]
hardware/freecad/x-motor-mount/solid-half-rail-mount/baseline/headstock_frame.step
157.6 x 25.4 x 40.9 mm
