revjmoney/revturn-lathe-firmware/hardware/freecad/x-motor-mount/solid-half-rail-mount/inline_motor_mount_SOLID_HALF_SIDE_TIE.FCStd

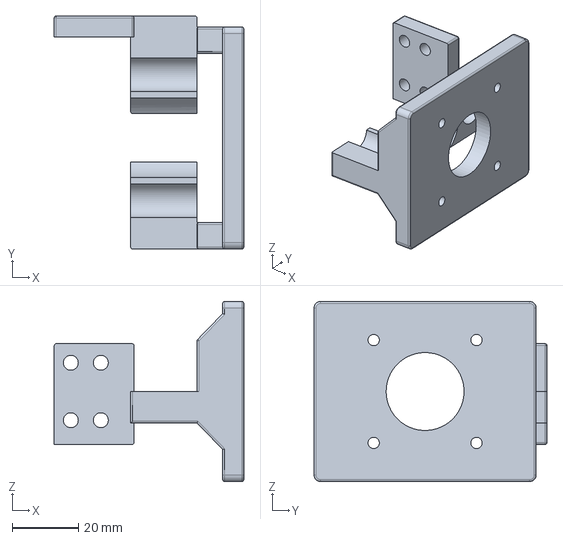
[picture p66: CAD file, 2026-11-11]
hardware/freecad/x-motor-mount/solid-half-rail-mount/inline_motor_mount_SOLID_HALF_SIDE_TIE.FCStd
57.1 x 70.2 x 54.3 mm
