revjmoney/revturn-lathe-firmware/hardware/stl/rail_clamp_cap_x4.stl

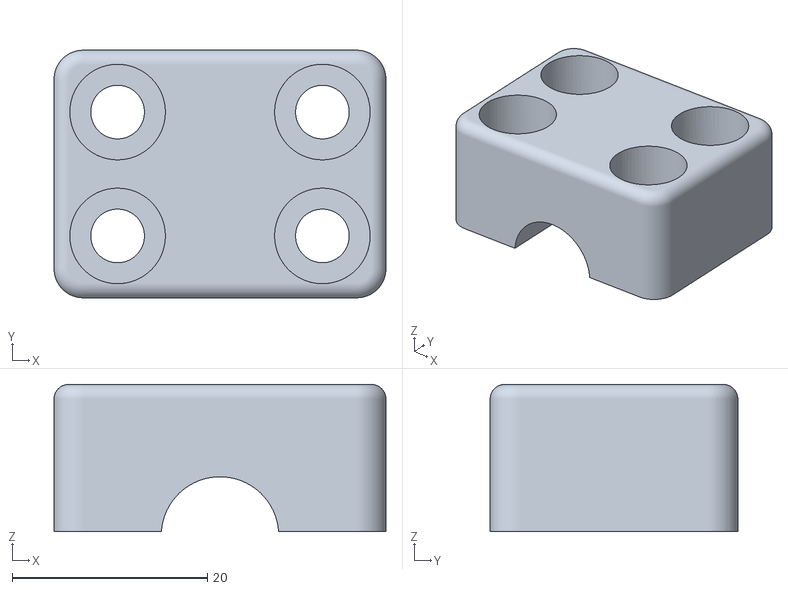
[picture p68: CAD file, 2026-11-09]
hardware/stl/rail_clamp_cap_x4.stl
34.0 x 25.4 x 15.1
