revjmoney/revturn-lathe-firmware/hardware/freecad/x-motor-mount/solid-half-rail-mount/baseline/cross_slide_saddle_r9.step

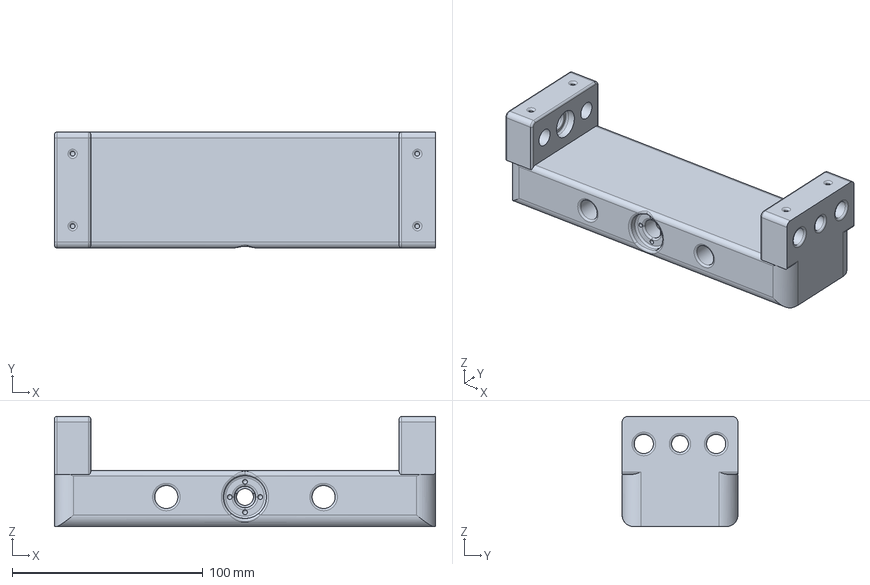
[picture p69: CAD file, 2026-11-09]
hardware/freecad/x-motor-mount/solid-half-rail-mount/baseline/cross_slide_saddle_r9.step
200.0 x 60.8 x 57.8 mm
