revjmoney/revturn-lathe-firmware/hardware/freecad/x-motor-mount/split-rail-mount-no-side-tie/baseline/cross_slide_top_plate_r9.step

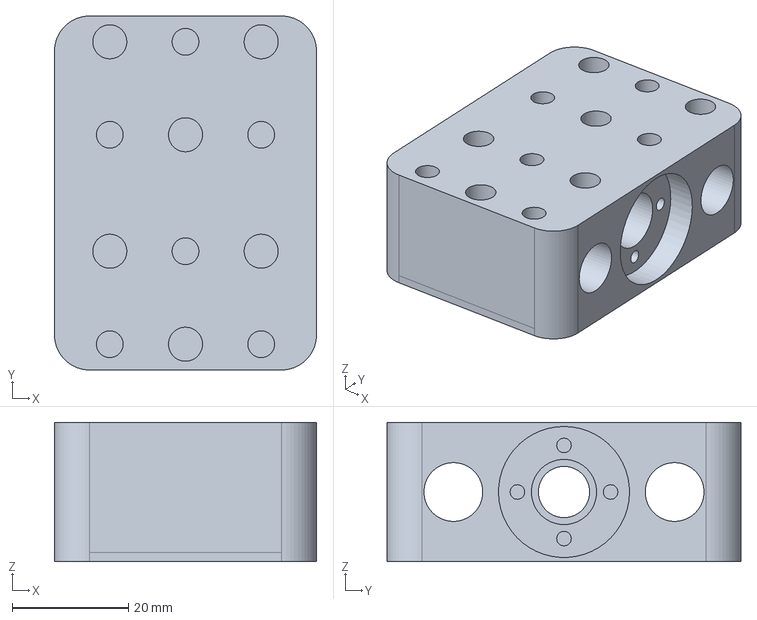
[picture p70: CAD file, 2026-11-09]
hardware/freecad/x-motor-mount/split-rail-mount-no-side-tie/baseline/cross_slide_top_plate_r9.step
45.0 x 60.8 x 23.9 mm
