revjmoney/revturn-lathe-firmware/hardware/step/tool_post_holder_quarter_inch_solid.step

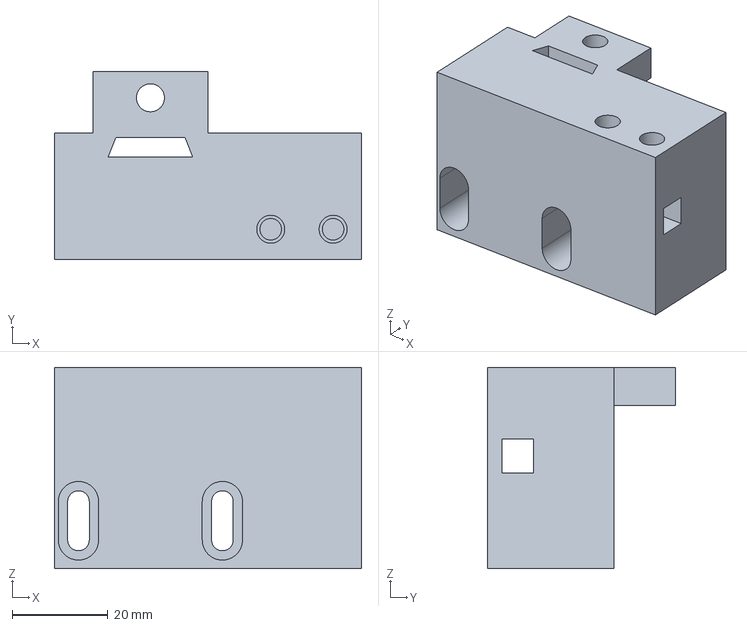
[picture p71: CAD file, 2026-11-11]
hardware/step/tool_post_holder_quarter_inch_solid.step
64.0 x 39.2 x 42.0 mm
