revjmoney/revturn-lathe-firmware/hardware/step/tool_post_base.step

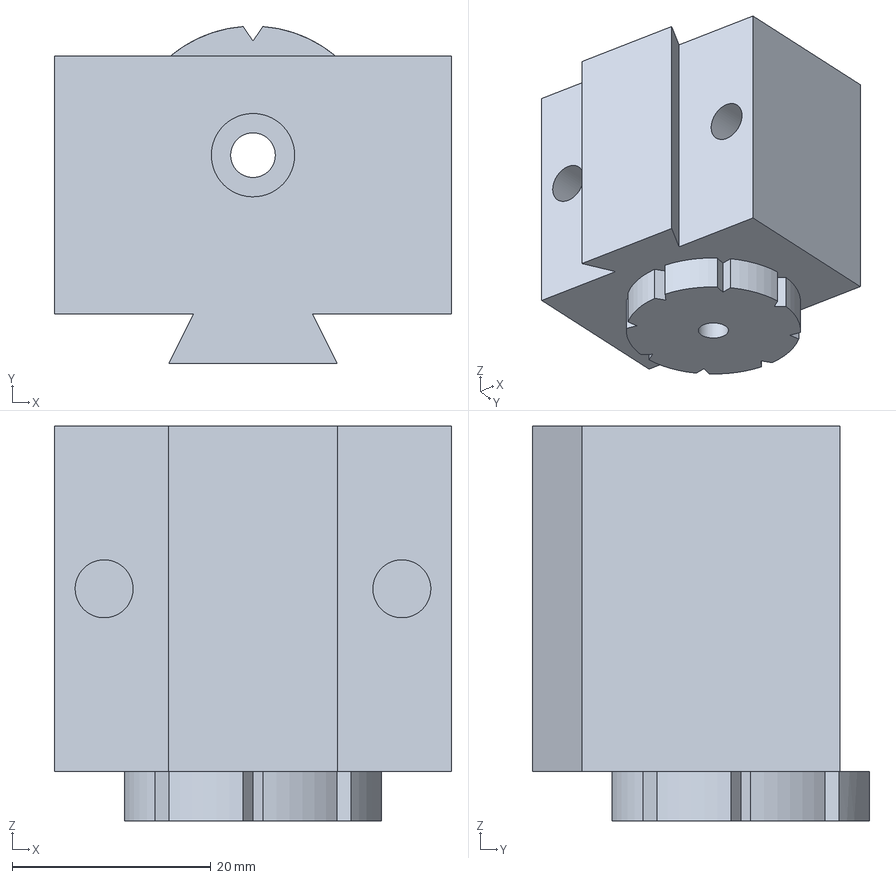
[picture p72: CAD file, 2026-11-11]
hardware/step/tool_post_base.step
40.0 x 34.0 x 39.8 mm
