revjmoney/revturn-lathe-firmware/hardware/step/tool_post_v_shim_round_bits.step

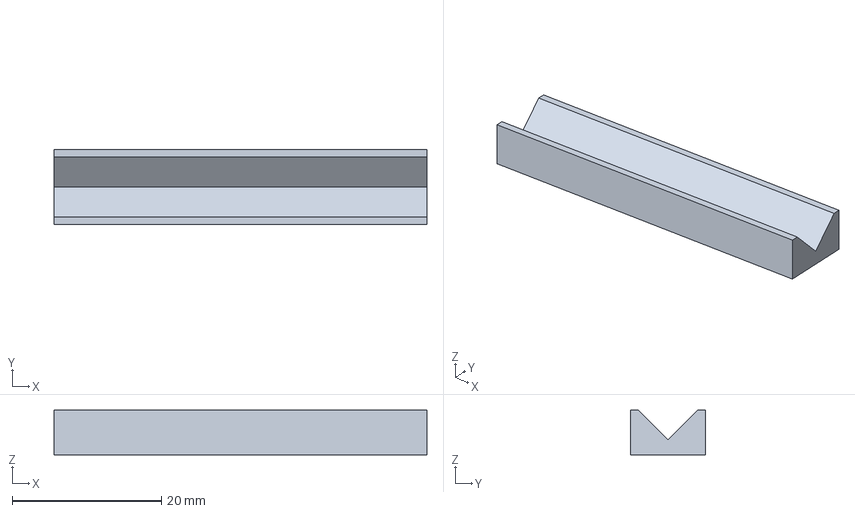
[picture p73: CAD file, 2026-11-11]
hardware/step/tool_post_v_shim_round_bits.step
50.0 x 10.1 x 6.00 mm
