revjmoney/revturn-lathe-firmware/hardware/step/tool_post_holder_boring.step

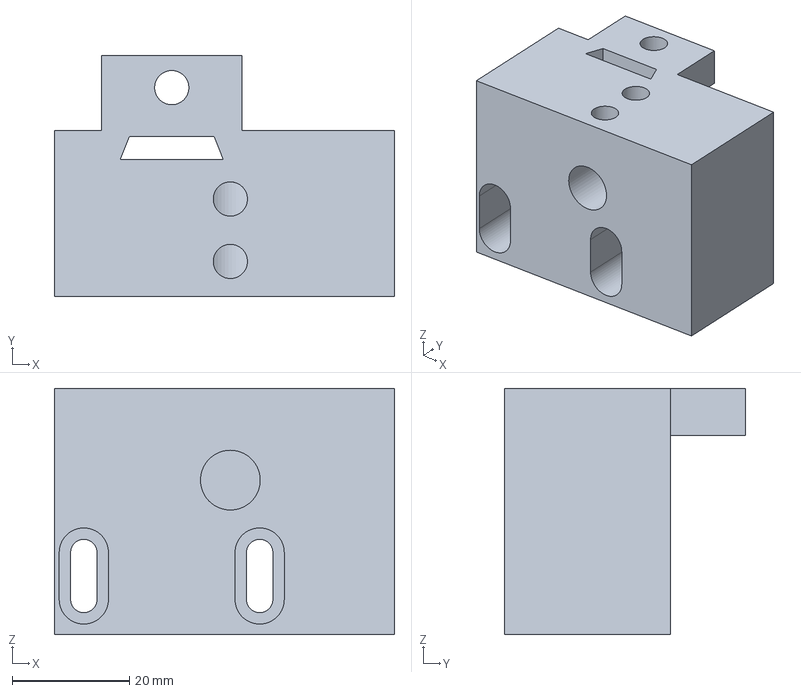
[picture p74: CAD file, 2026-11-11]
hardware/step/tool_post_holder_boring.step
58.0 x 41.1 x 42.0 mm
