revjmoney/revturn-lathe-firmware/hardware/step/tool_post_swivel_ring.step

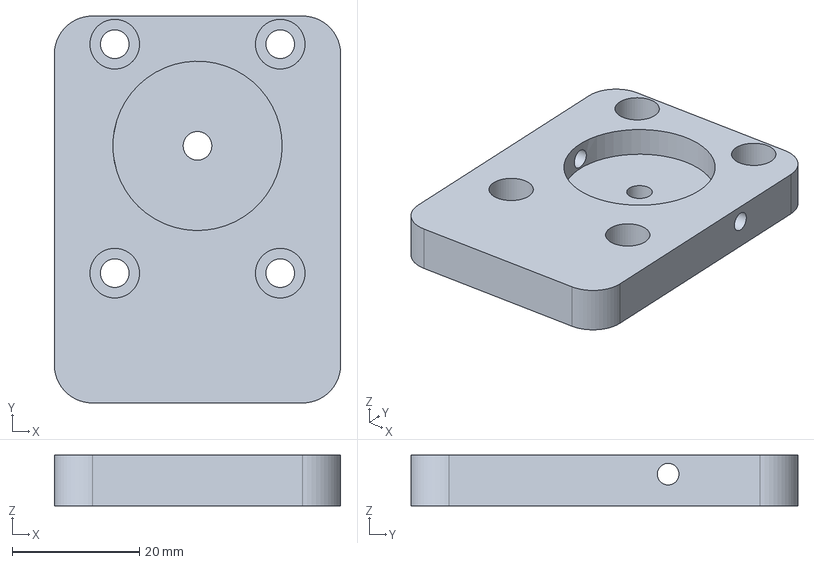
[picture p75: CAD file, 2026-11-11]
hardware/step/tool_post_swivel_ring.step
45.0 x 60.8 x 8.00 mm
