revjmoney/revturn-lathe-firmware/hardware/step/x_motor_plate_r8_direct.step

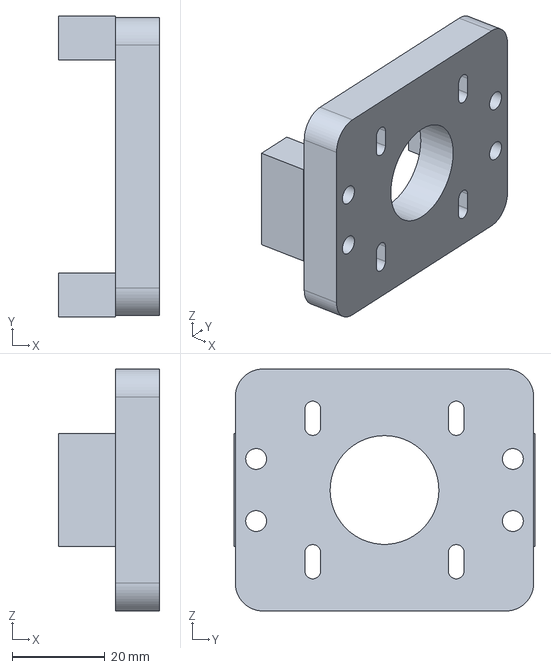
[picture p76: CAD file, 2026-11-10]
hardware/step/x_motor_plate_r8_direct.step
21.9 x 65.0 x 52.3 mm
