revjmoney/revturn-lathe-firmware/hardware/step/cross_slide_saddle_r8_direct.step

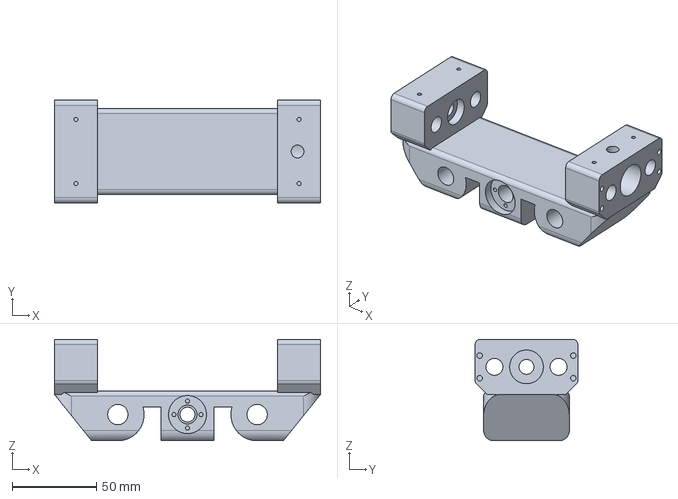
[picture p77: CAD file, 2026-11-10]
hardware/step/cross_slide_saddle_r8_direct.step
157.6 x 60.8 x 60.1 mm
