revjmoney/revturn-lathe-firmware/hardware/step/pulley_30t_motor_bore5_r9.step

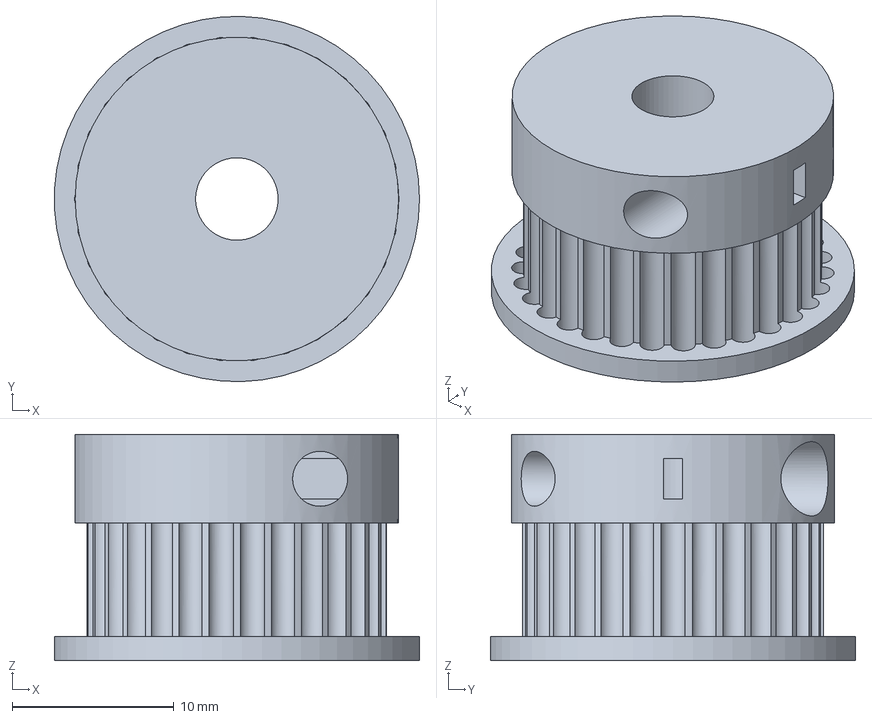
[picture p78: CAD file, 2026-11-09]
hardware/step/pulley_30t_motor_bore5_r9.step
22.6 x 22.6 x 14.0 mm
