revjmoney/revturn-lathe-firmware/(list of files, cad)

Other CAD files:
hardware/freecad/x-motor-mount/split-rail-mount/inline_side_tie_assembly.FCStd
hardware/stl/headstock_frame.stl
hardware/freecad/x-motor-mount/inline-rail-mount/baseline/rail_clamp_cap_x4.step
hardware/freecad/x-motor-mount/split-rail-mount-no-side-tie/baseline/rail_clamp_cap_x4.step
hardware/stl/x_belt_motor_bracket_r9.stl
hardware/freecad/x-motor-mount/solid-half-rail-mount/baseline/rail_clamp_cap_x4.step
hardware/freecad/x-motor-mount/split-rail-mount/baseline/rail_clamp_cap_x4.step
hardware/stl/cross_slide_saddle_r9.stl
hardware/stl/cross_slide_top_plate_r9.stl
hardware/freecad/x-motor-mount/inline-rail-mount/baseline/tailstock_frame_belt.step
hardware/freecad/x-motor-mount/solid-half-rail-mount/baseline/tailstock_frame_belt.step
hardware/freecad/x-motor-mount/split-rail-mount-no-side-tie/baseline/tailstock_frame_belt.step
hardware/freecad/x-motor-mount/split-rail-mount/baseline/tailstock_frame_belt.step
hardware/step/x_motor_inline_rail_mount_no_side_tie_r9.step
hardware/step/x_motor_inline_rail_mount_r9.step
hardware/step/cross_slide_top_plate_r8_direct.step
hardware/assembly/REVTURN_lathe_assembly.FCStd
hardware/step/pulley_30t_screw_bore8.step
hardware/step/thrust_washer_x2.step
hardware/stl/cross_slide_saddle_r8_direct.stl
hardware/stl/cross_slide_top_plate_r8_direct.stl
hardware/stl/pulley_30t_motor_bore5_r9.stl
hardware/stl/pulley_30t_screw_bore8.stl
hardware/stl/thrust_washer_x2.stl
hardware/stl/tool_post_base.stl
hardware/stl/tool_post_holder_10mm_round.stl
hardware/stl/tool_post_holder_boring.stl
hardware/stl/tool_post_holder_quarter_inch_solid.stl
hardware/stl/tool_post_holder_turning.stl
hardware/stl/tool_post_swivel_ring.stl
hardware/stl/tool_post_v_shim_round_bits.stl
hardware/stl/x_motor_inline_rail_mount_no_side_tie_r9.stl
hardware/stl/x_motor_inline_rail_mount_r9.stl
hardware/stl/x_motor_plate_r8_direct.stl
