revjmoney/revturn-lathe-firmware/tools/resonance/runs/c_spin_one_dot_manual_exposure/lathe.csv

t_ms | state | sd_pct | line_n | mpos_xyzc
1422 | Idle |  | 663 | 72.113 0.000 -48.986 227880.968
1480 | Idle |  | 663 | 72.113 0.000 -48.986 227880.968
1586 | Idle |  | 663 | 72.113 0.000 -48.986 227880.968
1695 | Idle |  | 663 | 72.113 0.000 -48.986 227880.968
1785 | Idle |  | 663 | 72.113 0.000 -48.986 227880.968
1910 | Idle |  | 663 | 72.113 0.000 -48.986 227880.968
2002 | Idle |  | 663 | 72.113 0.000 -48.986 227880.968
2106 | Idle |  | 663 | 72.113 0.000 -48.986 227880.968
2214 | Idle |  | 663 | 72.113 0.000 -48.986 227880.968
2274 | Idle |  | 663 | 72.113 0.000 -48.986 227880.968
2499 | Idle |  | 663 | 72.113 0.000 -48.986 227880.968
2564 | Idle |  | 663 | 72.113 0.000 -48.986 227880.968
2675 | Idle |  | 663 | 72.113 0.000 -48.986 227880.968
2797 | Idle |  | 663 | 72.113 0.000 -48.986 227880.968
2869 | Idle |  | 663 | 72.113 0.000 -48.986 227880.968
3002 | Idle |  | 663 | 72.113 0.000 -48.986 227880.968
3076 | Idle |  | 663 | 72.113 0.000 -48.986 227880.968
3190 | Idle |  | 663 | 72.113 0.000 -48.986 227880.968
3292 | Idle |  | 663 | 72.113 0.000 -48.986 227880.968
3430 | Idle |  | 663 | 72.113 0.000 -48.986 227880.968
3528 | Idle |  | 663 | 72.113 0.000 -48.986 227880.968
3640 | Idle |  | 663 | 72.113 0.000 -48.986 227880.968
3768 | Idle |  | 663 | 72.113 0.000 -48.986 227880.968
3847 | Idle |  | 663 | 72.113 0.000 -48.986 227880.968
4816 | Idle |  | 663 | 72.113 0.000 -48.986 227880.968
4816 | Idle |  | 663 | 72.113 0.000 -48.986 227880.968
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
136540 | Idle |  | 663 | 72.113 0.000 -48.986 300961.000
136714 | Idle |  | 663 | 72.113 0.000 -48.986 300961.000
136774 | Idle |  | 663 | 72.113 0.000 -48.986 300961.000
136867 | Idle |  | 663 | 72.113 0.000 -48.986 300961.000
136971 | Idle |  | 663 | 72.113 0.000 -48.986 300961.000
