revjmoney/revturn-lathe-firmware/docs/screenshots/revturn-setup.png

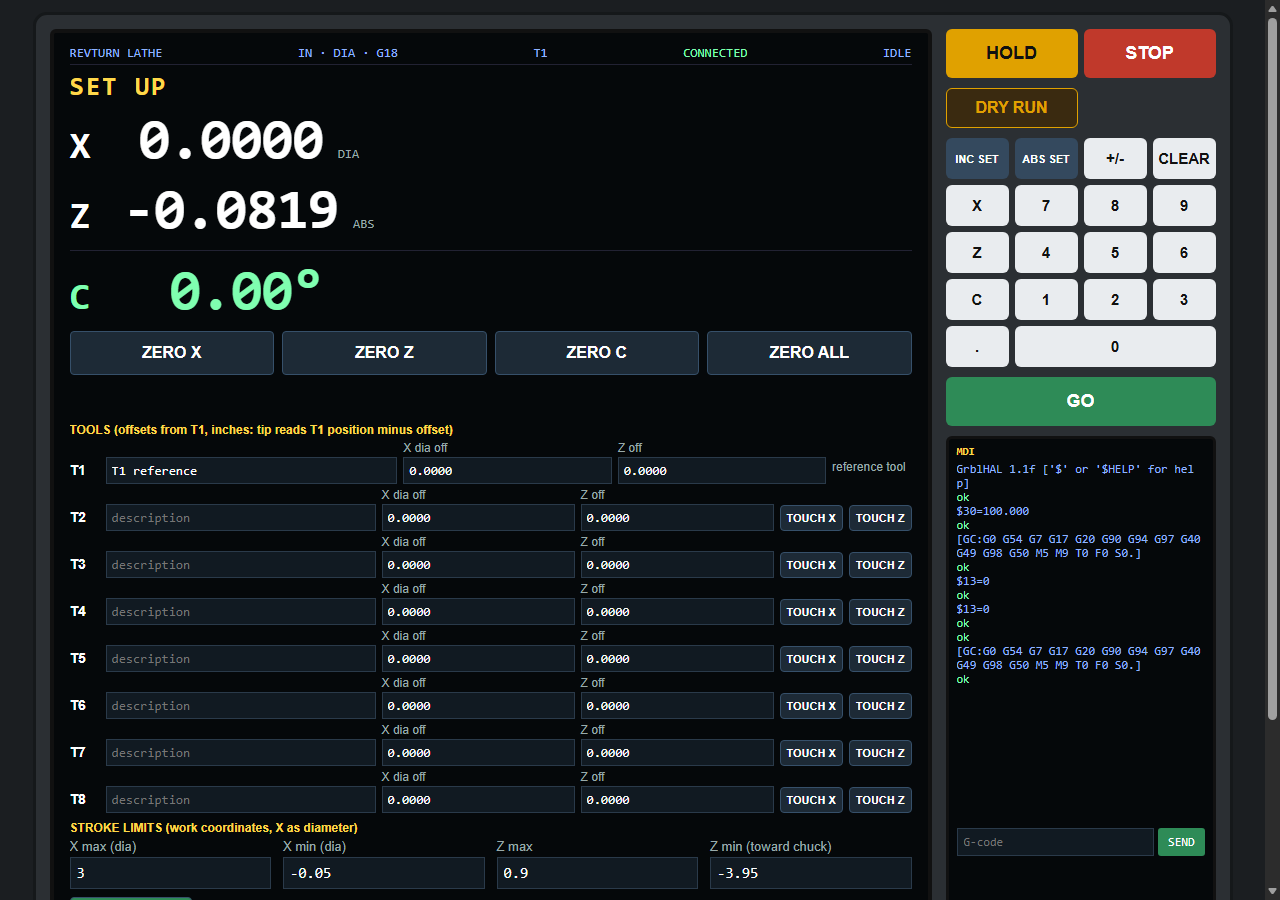
docs/screenshots/revturn-setup.png
