revjmoney/revturn-lathe-firmware/site/media/screen-edit-step.png

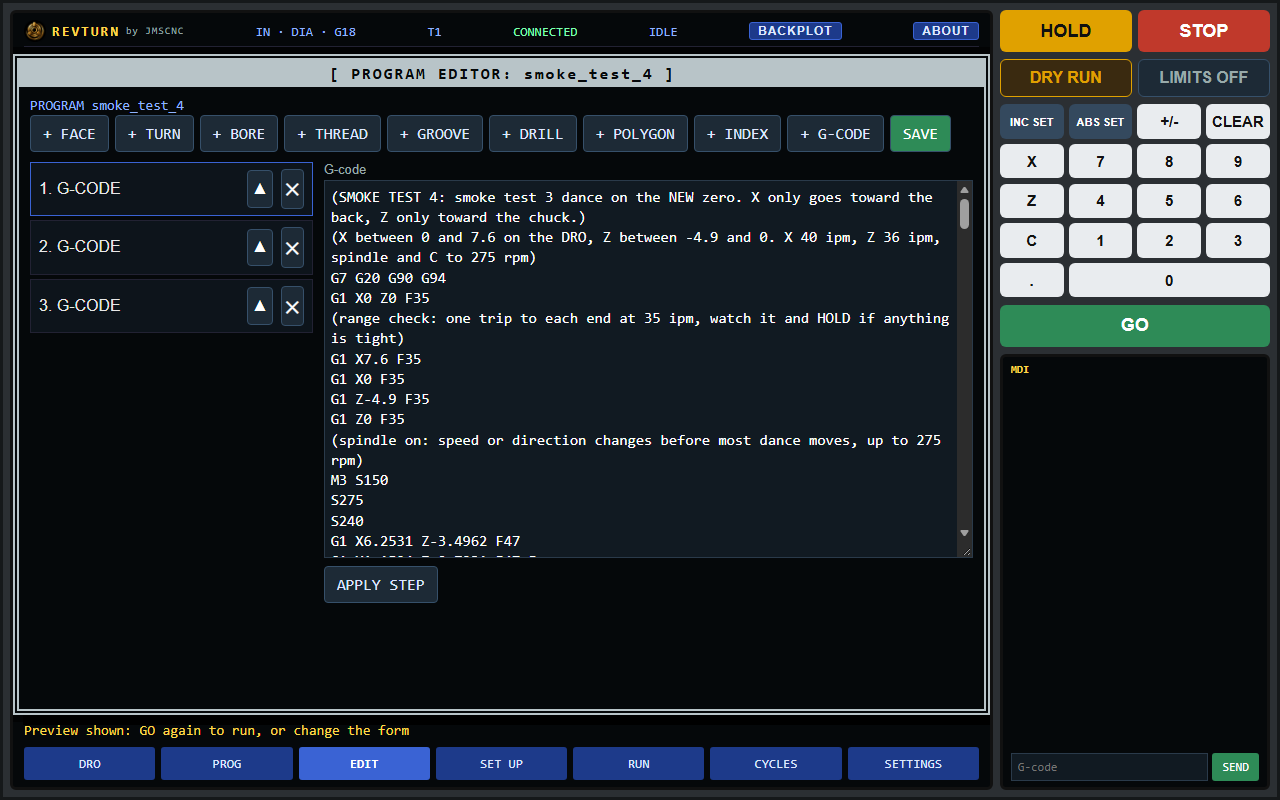
site/media/screen-edit-step.png
