revjmoney/revturn-lathe-firmware/main/my_machine.h

/*
  Part of grblHAL

  Copyright (c) 2020-2025 Terje Io
  REVTURN changes Copyright (c) 2026 JMSCNC / Rev. J. Money (jmscnc.com), same license.

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
  You should have received a copy of the GNU General Public License
  along with grblHAL. If not, see <http://www.gnu.org/licenses/>.
*/

// NOTE: Only one board may be enabled!
// If none is enabled pin mappings from generic_map.h will be used
//#define BOARD_BDRING_V3P5             			//
//#define BOARD_BDRING_V4               			//
//#define BOARD_BDRING_I2S6A            			//
//#define BOARD_BDRING_6X               			//
//#define BOARD_BDRING_I2S_6PACK_EXT_V2 			//
//#define BOARD_BDRING_6X_V3            			//
//#define BOARD_BLACKBOX_X32            			// NOTE: Enable in CMakeLists.txt to set board specific defaults for the core!
//#define BOARD_BTT_RODENT              			// Uses TMC2160 drivers, untested!
//#define BOARD_CORGI                   			// 6-axis, external drivers
//#define BOARD_CNC_BOOSTERPACK         			//
//#define BOARD_CNC3040                 			//
//#define BOARD_ESPDUINO32              			//
//#define BOARD_FYSETC_E4               			//
//#define BOARD_JACKPOT                 			// Uses TMC2209 drivers, untested!
//#define BOARD_MKS_DLC32_MAX_V1        			// Has a ESP32-S3 MCU
//#define BOARD_MKS_DLC32_V2P0          			//
//#define BOARD_MKS_TINYBEE_V1          			//
//#define BOARD_OOZNEST_CNC                         // Has a ESP32-S3 MCU
//#define BOARD_PIBOT_I2S_6_AXIS        			// PiBot 6-axis I2S board
//#define BOARD_PIBOT_5_88_ULTRA        			// Has a ESP32-S3 MCU
//#define BOARD_PROTONEER_3XX           			//
//#define BOARD_ROOTCNC_PRO             			//
//#define BOARD_ROOTCNC_V2              			//
//#define BOARD_ROOTCNC_V3              			//
//#define BOARD_SOURCERABBIT_RABBITBOARD_4_AXIS		// Rabbit Board 4-Axis
//#define BOARD_SOURCERABBIT_4AXIS      			// 4-Axis CNC Motherboard v1.2 configuration
//#define BOARD_XPRO_V5                 			//
//#define BOARD_GENERIC_S3              			// Generic map for ESP32-S3, untested - WIP!
//#define BOARD_GENERIC_I2S_S3          			// Generic map for ESP32-S3 with I2S shift registers for I/O expansion, untested - WIP!
#define BOARD_MY_MACHINE              			// Add my_machine_map.h in the boards directory before enabling this!


// --- Rev's mini lathe (REVTURN ESP32): axis count, C letter, lathe mode and polarity are in
// main/CMakeLists.txt, because the grbl core files do not include this header.
#define PROBE_ENABLE            0      // Rev 2026-11-10: probe input on GPIO 14 (pulled up: unwired = not triggered)
#define WEBUI_INFLASH           1      // Rev 2026-11-08: serve the embedded index.html.gz, no upload step
//#define I2C_ENABLE            1      // Rev 2026-11-08: OLED removed (module dead); code kept in rev-patches/retired/oled_my_plugin.c

// Configuration
// Uncomment to enable, for some a value > 1 may be assigned, if so the default value is shown.

#if CONFIG_IDF_TARGET_ESP32S3
#define USB_SERIAL_CDC          0 // Serial communication via native USB.
#endif

// Spindle selection:
// Up to four specific spindle drivers can be instantiated at a time
// depending on N_SPINDLE and N_SYS_SPINDLE definitions in grbl/config.h.
// If none are specified the default PWM spindle is instantiated.
// Spindle definitions can be found in grbl/spindle_control.h.
// More here https://github.com/grblHAL/Plugins_spindle
#define SPINDLE0_ENABLE         SPINDLE_STEPPER // Rev lathe: DM542T stepper is the spindle and the C axis
#define SPINDLE1_ENABLE         SPINDLE_PWM0_NODIR // Rev 2026-11-08: second spindle (router/live tool). PWM GPIO4, enable GPIO5. N_SPINDLE=2 is in CMakeLists.txt
//#define SPINDLE2_ENABLE         SPINDLE_NONE
//#define SPINDLE3_ENABLE         SPINDLE_NONE
//#define SPINDLE_OFFSET          1 // Uncomment to enable settings for laser spindle XY-offset.
// **********************
//#define MODBUS_ENABLE           1 // Set to 1 for auto direction, 2 for direction signal on auxiliary output pin.
#define WEBUI_ENABLE            3 // Rev 2026-11-08: ESP3D WebUI v3 ONLY (1 = auto answered ESP800 in v2 format, WebUI 3.0 websocket failed). Enable ESP3D-WEBUI plugin along with networking and SD card plugins.
//#define WEBUI_AUTH_ENABLE       1 // Enable ESP3D-WEBUI authentication.
#define WIFI_ENABLE             1 // Rev 2026-11-08
#define WIFI_SOFTAP             1 // Rev 2026-11-08: boots as hotspot grblHAL_AP, set home WiFi from the WebUI. Use Soft AP mode for WiFi.
//#define ETHERNET_ENABLE         1 // Ethernet streaming. Uses networking plugin.
//#define BLUETOOTH_ENABLE        1 // Set to 1 for native radio, 2 for HC-05 module.
#define SDCARD_ENABLE           0 // Rev 2026-11-08: NO SD hardware. Default SD SPI pins 18/19/23 are the spindle and enable! Run gcode programs from SD card. Set to 2 to enable YModem upload.
#define LITTLEFS_ENABLE         2 // Rev 2026-11-08: flash file system mounted as root (files + WebUI). Enable flash based storage, automatically enabled if WebUI is enabled. Set to 2 to mount as root.
//#define MPG_ENABLE              1 // Enable MPG interface. Requires a serial stream and means to switch between normal and MPG mode.
                                    // 1: Mode switching is by handshake pin.
                                    // 2: Mode switching is by the CMD_MPG_ENABLE_TOGGLE (0x8B) command character.
//#define KEYPAD_ENABLE           1 // 1: uses a I2C keypad for input.
                                    // 2: uses a serial stream for input. If MPG_ENABLE is set > 0 the serial stream is shared with the MPG.
//#define DISPLAY_ENABLE          9 // Set to 9 for I2C display protocol, 17 for I2C LED protocol. Other options may be available via plugins.
//#define MACROS_ENABLE           0 // Macros plugin. For macros that can be triggered by keypad plugin or auxiliary inputs.
                                    // Set to 1 for aux input triggers, 2 for keypad triggers or 3 for both.
//#define N_MACROS                3 // Number of macros to enable, max 8. If commented out default is 4 when triggered by aux inputs, 8 otherwise.
//#define LASER_COOLANT_ENABLE    1 // Laser coolant plugin. To be completed.
//#define LB_CLUSTERS_ENABLE      1 // LaserBurn cluster support.
//#define LASER_OVD_ENABLE        1
//#define OPENPNP_ENABLE          1 // OpenPNP plugin. To be completed.
//#define FANS_ENABLE             1 // Enable fan control via M106/M107. Enables fans plugin.
//#define EMBROIDERY_ENABLE       1 // Embroidery plugin. To be completed.
//#define OPENPNP_ENABLE          1 // OpenPNP plugin. To be completed.
//#define TRINAMIC_ENABLE      2130 // Trinamic TMC2130 stepper driver support.
//#define TRINAMIC_ENABLE      5160 // Trinamic TMC5160 stepper driver support.
//#define TRINAMIC_ENABLE      2209 // Trinamic TMC2209 stepper driver support.
//#define TRINAMIC_R_SENSE      110 // R sense resistance in milliohms, 2130 and 2209 default is 110, 5160 is 75.
//#define TRINAMIC_ENABLE      2240 // Trinamic TMC2240 stepper driver support.
//#define TRINAMIC_R_REF         12 // R ref resistance in kiloohms, used for 2240 - default value is 12.
//#define TRINAMIC_I2C            1 // Trinamic I2C - SPI bridge interface.
//#define TRINAMIC_DEV            1 // Development mode, adds a few M-codes to aid debugging. Do not enable in production code.
//#define EEPROM_ENABLE          16 // I2C EEPROM/FRAM support. Set to 16 for 2K, 32 for 4K, 64 for 8K, 128 for 16K and 256 for 16K capacity.
//#define EEPROM_IS_FRAM          1 // Uncomment when EEPROM is enabled and chip is FRAM, this to remove write delay.
//#define ESTOP_ENABLE            0 // When enabled only real-time report requests will be executed when the reset pin is asserted.
                                    // NOTE: if left commented out the default setting is determined from COMPATIBILITY_LEVEL.
//#define RGB_LED_ENABLE          2 // Set to 1 to enable strip length settings $536 and $537, set to 2 to also enable M150 LED strip control.
//#define PWM_SERVO_ENABLE        1 // Enable M280 PWM servo support, requires at least one PWM capable auxiliary output.
//#define BLTOUCH_ENABLE          1 // Enable M401/M402 BLTouch support. requires and claims one auxiliary PWM servo output.
//#define EVENTOUT_ENABLE         1 // Enable binding events (triggers) to control auxiliary outputs.
//#define ESP_AT_ENABLE           1 // Enable support for Telnet communication via UART connected ESP32 running ESP-AT.
//#define FEED_OVERRIDE_ENABLE    1 // Enable M200 feed override control.
//#define HOMING_PULLOFF_ENABLE   1 // Enable per axis homing pulloff distance settings.
//#define TOOLTABLE_ENABLE        1 // Enable file based tool table.

// --- IO expanders: ---
//#define MCP3221_ENABLE          1 // MCP3221 I2C 12 bit ADC input, default address is 0x9A (MCP3221_ADDRESS).
//#define MCP4725_ENABLE          1 // MCP4725 I2C 12 bit DAC output, default address is 0xC0 (MCP3221_ADDRESS).
//#define MCP23017_ENABLE         1 // MCP23017 I2C 16 channel digital I/O, default address is 0x40 (MCP23017_ADDRESS).
                                    // 1: Port A as outputs, port B as inputs.
                                    // 2: Port A and B as outputs.
                                    // 3: Port A and B as inputs.
//#define PCA9654E_ENABLE         1 // PCA9654E I2C 8 channel digital out, default address is 0x40 (PCA9654E_ADDRESS).
//#define HC595_ENABLE            1 // 74HC595 SPI shift register 8 - 32 channel digital outputs.
                                    // 1:  8 channels.
                                    // 2: 16 channels.
                                    // 3: 24 channels.
                                    // 4: 32 channels.
//#define FNC_EXPANDER_ENABLE     1 // FluidNC STM32F103 based I/O expander (Airedale)

// Optional control signals:
// These will be assigned to aux input pins. Use the $pins command to check which pins are assigned.
// NOTE: If not enough pins are available assignment will silently fail.
//#define PROBE_ENABLE            0 // Uncomment to disable probe input.
//#define PROBE2_ENABLE           1 // Enable second regular probe input, depending on the board the input assigned may be predefined.
//#define TOOLSETTER_ENABLE       1 // Enable toolsetter input, depending on the board the input assigned may be predefined.
//#define SAFETY_DOOR_ENABLE      1
//#define MOTOR_FAULT_ENABLE      1
//#define MOTOR_WARNING_ENABLE    1
//#define PROBE_DISCONNECT_ENABLE 1
//#define STOP_DISABLE_ENABLE     1
//#define BLOCK_DELETE_ENABLE     1
//#define SINGLE_BLOCK_ENABLE     1
//#define LIMITS_OVERRIDE_ENABLE  1

// If the selected board map supports more than three motors ganging and/or auto-squaring
// of axes can be enabled here.
//#define X_GANGED            1
//#define X_AUTO_SQUARE       1
//#define Y_GANGED            1
//#define Y_AUTO_SQUARE       1
//#define Z_GANGED            1
//#define Z_AUTO_SQUARE       1
// For ganged axes the limit switch input (if available) can be configured to act as a max travel limit switch.
// NOTE: If board map already has max limit inputs defined this configuration will be ignored.
//#define X_GANGED_LIM_MAX    1
//#define Y_GANGED_LIM_MAX    1
//#define Z_GANGED_LIM_MAX    1
//

#if WIFI_ENABLE || ETHERNET_ENABLE || WEBUI_ENABLE
#define TELNET_ENABLE         1 // Telnet daemon - requires WiFi streaming enabled.
//#define WEBSOCKET_ENABLE      1 // Websocket daemon - requires WiFi streaming enabled.
//#define MDNS_ENABLE           0 // mDNS daemon. Do NOT enable here, enable in CMakeLists.txt!
//#define SSDP_ENABLE           1 // SSDP daemon - requires HTTP enabled.
//#define MQTT_ENABLE           1 // MQTT client API, only enable if needed by plugin code.
#if SDCARD_ENABLE || WEBUI_ENABLE
#define FTP_ENABLE            1 // Ftp daemon - requires SD card enabled.
//#define HTTP_ENABLE           1 // http daemon - requires SD card enabled.
//#define WEBDAV_ENABLE         1 // webdav protocol - requires http daemon and SD card enabled.
#endif
// The following symbols have the default values as shown, uncomment and change as needed.
#define NETWORK_STA_HOSTNAME    "revturn" // REVTURN by JMSCNC (Rev 2026-11-11)
//#define NETWORK_STA_IPMODE      1 // 0 = static, 1 = DHCP, 2 = AutoIP
//#define NETWORK_STA_IP          "192.168.5.1"
//#define NETWORK_STA_GATEWAY     "192.168.5.1"
//#define NETWORK_STA_MASK        "255.255.255.0"
#if WIFI_SOFTAP
#define NETWORK_AP_SSID         "REVTURN_AP" // REVTURN by JMSCNC (Rev 2026-11-11)
//#define NETWORK_AP_PASSWORD     "grblHALap"
#define NETWORK_AP_HOSTNAME     "revturn-ap"
//#define NETWORK_AP_IPMODE       0              // Do not change!
//#define NETWORK_AP_IP           "192.168.4.1"  // Do not change!
//#define NETWORK_AP_GATEWAY      "192.168.4.1"  // Do not change!
//#define NETWORK_AP_MASK         "255.255.255.0"
#endif
//#define NETWORK_FTP_PORT     21
//#define NETWORK_TELNET_PORT  23
//#define NETWORK_HTTP_PORT    80
#if HTTP_ENABLE
//#define NETWORK_WEBSOCKET_PORT  81
#else
//#define NETWORK_WEBSOCKET_PORT  80
#endif // HTTP_ENABLE
#endif // WIFI_ENABLE
