revjmoney/revturn-lathe-firmware/main/wifi.c

/*
  wifi.c - An embedded CNC Controller with rs274/ngc (g-code) support

  WiFi comms

  Part of grblHAL

  Copyright (c) 2018-2026 Terje Io
  REVTURN changes Copyright (c) 2026 JMSCNC / Rev. J. Money (jmscnc.com), same license.

  Some parts of the code is based on example code by Espressif, in the public domain

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
  You should have received a copy of the GNU General Public License
  along with grblHAL. If not, see <http://www.gnu.org/licenses/>.
*/

#include "driver.h"

#if WIFI_ENABLE

#include <string.h>

#include "freertos/FreeRTOS.h"
#include "freertos/task.h"
#include "freertos/event_groups.h"

#include <esp_log.h>
#include <esp_wifi.h>
#include <esp_event.h>
#include "mdns.h"

#include "nvs_flash.h"

#include "networking/networking.h"
#include "networking/utils.h"
//#include "lwip/timeouts.h"

#include "wifi.h"
#include "dns_server.h"
#include "grbl/report.h"
#include "grbl/task.h"
#include "grbl/nvs_buffer.h"
#include "grbl/protocol.h"
#include "grbl/state_machine.h"
#include "esp_timer.h"
#include "esp_system.h"

typedef struct {
    grbl_wifi_mode_t mode;
    wifi_sta_settings_t sta;
    wifi_ap_settings_t ap;
} wifi_settings_t;

/* The event group allows multiple bits for each event,
   but we only care about one event - are we connected
   to the AP with an IP? */
const static int CONNECTED_BIT = BIT0;
const static int SCANNING_BIT = BIT1;
const static int APSTA_BIT = BIT2;

static EventGroupHandle_t wifi_event_group;
static network_settings_t network;
static network_services_t services = {0}, allowed_services;
static wifi_config_t wifi_sta_config;

// Rev patch 2026-11-08: STA auto-reconnect. Stock grblHAL wiped the STA credentials on any disconnect and
// never called esp_wifi_connect() again, so a brief WiFi drop left the lathe off the home network until a
// reboot. Pattern from the ESP-IDF station example + ESPHome: keep the credentials, retry with backoff
// (1 s doubling to 30 s), reset on GOT_IP, and as a last resort reboot after 15 min offline, only when Idle.
#define STA_RETRY_MIN_MS 1000
#define STA_RETRY_MAX_MS 30000
static esp_timer_handle_t sta_retry_timer = NULL;
static uint32_t sta_retry_ms = STA_RETRY_MIN_MS;
static int64_t sta_down_since = 0;
static SemaphoreHandle_t aplist_mutex = NULL;
static ap_list_t ap_list = {0};
static wifi_settings_t wifi;
static nvs_address_t nvs_address;
static esp_netif_t *sta_netif = NULL, *ap_netif = NULL;
static network_flags_t sta_status = {}, ap_status = {};
static char netservices[NETWORK_SERVICES_LEN] = "", sta_if_name[NETIF_NAMESIZE] = "", ap_if_name[NETIF_NAMESIZE] = "";
static char *country_codes[] = {
    "01", "AT", "AU", "BE", "BG", "BR", "CA", "CH", "CN", "CY", "CZ", "DE", "DK",
    "EE", "ES", "FI", "FR", "GB", "GR", "HK", "HR", "HU", "IE", "IN", "IS", "IT",
    "JP", "KR", "LI", "LT", "LU", "LV", "MT", "MX", "NL", "NO", "NZ", "PL", "PT",
    "RO", "SE", "SI", "SK", "TW", "US", ""
};

static bool validate_country_code (char *country_id)
{
    uint_fast8_t idx = 0;

    if(*country_id) while(*country_codes[idx]) {
        if(!strcmp(country_id, country_codes[idx]))
            return true;
        idx++;
    }

    return false;
}

#if MQTT_ENABLE

static void status_event_publish (network_flags_t changed);

static on_mqtt_client_connected_ptr on_client_connected;

static void mqtt_connection_changed (bool connected)
{
    ap_status.mqtt_connected = connected;

    status_event_publish((network_flags_t){ .mqtt_connected = On });

    if(on_client_connected)
         on_client_connected(connected);
}

#endif

static void status_event_out (void *data)
{
    networking.event(sta_if_name, (network_status_t){ .value = (uint32_t)data });
}

static void status_event_publish (network_flags_t changed)
{
    task_add_immediate(status_event_out, (void *)((network_status_t){ .changed = changed, .flags = sta_status }).value);
}

static void status_ap_event_out (void *data)
{
    networking.event(ap_if_name, (network_status_t){ .value = (uint32_t)data });
}

static void status_ap_event_publish (network_flags_t changed)
{
    task_add_immediate(status_ap_event_out, (void *)((network_status_t){ .changed = changed, .flags = ap_status }).value);
}

static void ap_scan (void *data)
{
    // https://esp32.com/viewtopic.php?t=5536
    // https://esp32.com/viewtopic.php?t=7305
/*
    static const wifi_scan_config_t scan_config = {
        .ssid = 0,
        .bssid = 0,
        .channel = 0,
        .scan_time.active = {
          .min = 500,
          .max = 1500
        },
        .scan_type = WIFI_SCAN_TYPE_ACTIVE,
        .show_hidden = false
    };
*/
    if(!(xEventGroupGetBits(wifi_event_group) & SCANNING_BIT) && esp_wifi_scan_start(NULL, false) == ESP_OK)
        xEventGroupSetBits(wifi_event_group, SCANNING_BIT);

    if(sta_status.ap_scan_completed) {
        sta_status.ap_scan_completed = Off;
        status_event_publish((network_flags_t){ .ap_scan_completed = On });
    }
}

void wifi_ap_scan (void)
{
    ap_scan(NULL);
}

ap_list_t *wifi_get_aplist (void)
{
    if(ap_list.ap_records && xSemaphoreTake(aplist_mutex, pdMS_TO_TICKS(10)) == pdTRUE)
        return &ap_list;
    else
        return NULL;
}

void wifi_release_aplist (void)
{
    xSemaphoreGive(aplist_mutex);
}

char *iptoa (void *ip)
{
    static char aip[INET6_ADDRSTRLEN + 20]; // + 20 due to compiler issue?

    inet_ntop(AF_INET, ip, aip, INET6_ADDRSTRLEN);

    return aip;
}

static network_info_t *get_info (const char *interface)
{
    static network_info_t info;

    if(interface == sta_if_name || interface == ap_if_name) {

        uint8_t bmac[6];

        memcpy(&info.status, &network, sizeof(network_settings_t));

        *info.mac = '\0';
        *info.status.ip = '\0';
        *info.status.gateway = '\0';
        *info.status.mask = '\0';

        esp_netif_t *netif = interface == sta_if_name ? sta_netif : ap_netif;

        if(netif) {

            esp_netif_ip_info_t ip_info;

            info.wifi_mode = interface == sta_if_name ? WiFiMode_STA : WiFiMode_AP;

            if(esp_netif_get_mac(netif, bmac) == ESP_OK)
                strcpy(info.mac, networking_mac_to_string(bmac));

            if(esp_netif_get_ip_info(netif, &ip_info) == ESP_OK) {

                if(!networking_ismemnull(&ip_info.ip, sizeof(ip_info.ip)))
                    strcpy(info.status.ip, iptoa(&ip_info.ip));

                if(!networking_ismemnull(&ip_info.gw, sizeof(ip_info.gw)))
                    strcpy(info.status.gateway, iptoa(&ip_info.gw));

                if(!networking_ismemnull(&ip_info.netmask, sizeof(ip_info.netmask)))
                    strcpy(info.status.mask, iptoa(&ip_info.netmask));
            }
        }

        info.interface = (const char *)interface;
        info.is_ethernet = false;
        info.link_up = false;
    //    info.mbps = 100;
        info.status.services = services;

#if MQTT_ENABLE
        networking_make_mqtt_clientid(info.mac, info.mqtt_client_id);
#endif

        return &info;
    }

    return NULL;
}

#if TELNET_ENABLE || WEBSOCKET_ENABLE || FTP_ENABLE

static void lwIPHostTimerHandler (void *arg)
{
    if(services.mask)
        sys_timeout(STREAM_POLL_INTERVAL, lwIPHostTimerHandler, NULL);

#if TELNET_ENABLE
    if(services.telnet)
        telnetd_poll();
#endif
#if WEBSOCKET_ENABLE
    if(services.websocket)
        websocketd_poll();
#endif
#if FTP_ENABLE
    if(services.ftp)
        ftpd_poll();
#endif
}

#endif

static void start_services (bool start_ssdp)
{
#if TELNET_ENABLE
    if(network.services.telnet && !services.telnet)
        services.telnet = telnetd_init(network.telnet_port);
#endif

#if WEBSOCKET_ENABLE
    if(network.services.websocket && !services.websocket)
        services.websocket = websocketd_init(network.websocket_port);
#endif

#if FTP_ENABLE
    if(network.services.ftp && !services.ftp)
        services.ftp = ftpd_init(network.ftp_port);
#endif

#if HTTP_ENABLE
    if(network.services.http && !services.http) {
        services.http = httpd_init(network.http_port);
  #if WEBDAV_ENABLE
        if(network.services.webdav && !services.webdav)
            services.webdav = webdav_init();
  #endif
    }
  #if SSDP_ENABLE
    if(start_ssdp && services.http && !services.ssdp)
        services.ssdp = ssdp_init(get_info(*sta_if_name ? sta_if_name : ap_if_name));
  #endif
#endif

#if MDNS_ENABLE
    if(*network.hostname && network.services.mdns && !services.mdns) {
        if((services.mdns = mdns_init() == ESP_OK)) {

            mdns_hostname_set(network.hostname);
            mdns_instance_name_set(network.hostname);

            mdns_txt_item_t device_info[3] = {
                { .key = "version", .value = GRBL_VERSION},
                { .key = "build", .value = NULL},
                { .key = "model", .value = "grblHAL"}
            };
            device_info[1].value = uitoa(GRBL_BUILD);
            mdns_service_add(NULL, "_device-info", "_tcp", 1, device_info, 3); // ESP-IDF does not allow port 0?

            if(services.http)
                mdns_service_add(NULL, "_http", "_tcp", network.http_port, &(mdns_txt_item_t){ .key = "path", .value = "/" }, 1);
            if(services.webdav)
                mdns_service_add(NULL, "_webdav", "_tcp", network.http_port, &(mdns_txt_item_t){ .key = "path", .value = "/" }, 1);
            if(services.ftp)
                mdns_service_add(NULL, "_ftp", "_tcp", network.ftp_port, &(mdns_txt_item_t){ .key = "path", .value = "/" }, 1);
            if(services.websocket)
                mdns_service_add(NULL, "_websocket", "_tcp", network.websocket_port, NULL, 0);
            if(services.telnet)
                mdns_service_add(NULL, "_telnet", "_tcp", network.telnet_port, NULL, 0);
        }
    }
#endif

#if MQTT_ENABLE
    if(!ap_status.mqtt_connected)
        mqtt_connect(get_info(*sta_if_name ? sta_if_name : ap_if_name), &network.mqtt);
#endif

#if TELNET_ENABLE || WEBSOCKET_ENABLE || FTP_ENABLE
    sys_timeout(STREAM_POLL_INTERVAL, lwIPHostTimerHandler, NULL);
#endif
}

static void stop_services (void)
{
    network_services_t running;

    running.mask = services.mask;
    services.mask = 0;

#if xHTTP_ENABLE
    if(running.http)
        httpdaemon_stop();
#endif
#if TELNET_ENABLE
    if(running.telnet)
        telnetd_stop();
#endif
#if WEBSOCKET_ENABLE
    if(running.websocket)
        websocketd_stop();
#endif
#if MDNS_ENABLE
    if(running.mdns)
        mdns_free();
#endif
    if(running.dns)
        dns_server_stop();

    xEventGroupClearBits(wifi_event_group, CONNECTED_BIT|SCANNING_BIT|APSTA_BIT);
}

char *wifi_get_authmode_name (wifi_auth_mode_t authmode)
{
    return authmode == WIFI_AUTH_OPEN ? "open" :
           authmode == WIFI_AUTH_WEP ? "wep" :
           authmode == WIFI_AUTH_WPA_PSK ? "wpa-psk" :
           authmode == WIFI_AUTH_WPA2_PSK ? "wpa-psk" :
           authmode == WIFI_AUTH_WPA_WPA2_PSK ? "wpa-wpa2-psk" :
           authmode == WIFI_AUTH_WPA2_ENTERPRISE ? "wpa-eap" :
           "unknown";
}

static void sta_retry_cb (void *arg)
{
    if((xEventGroupGetBits(wifi_event_group) & CONNECTED_BIT) || *wifi_sta_config.sta.ssid == '\0')
        return;

    // Review 2026-11-10: this used to esp_restart() after 15 minutes offline when the state was Idle. Idle also
    // covers a spindle running under M3 and pauses inside a program, and every restart loses the machine position,
    // so the lathe no longer reboots itself. It just keeps retrying.

    esp_wifi_connect(); // a failure raises WIFI_EVENT_STA_DISCONNECTED again, which schedules the next try
}

static void sta_schedule_retry (void)
{
    if(sta_retry_timer == NULL) {
        const esp_timer_create_args_t args = { .callback = sta_retry_cb, .name = "sta_retry" };
        if(esp_timer_create(&args, &sta_retry_timer) != ESP_OK)
            return;
    }

    esp_timer_stop(sta_retry_timer);
    esp_timer_start_once(sta_retry_timer, (uint64_t)sta_retry_ms * 1000ULL);

    sta_retry_ms = sta_retry_ms >= STA_RETRY_MAX_MS / 2 ? STA_RETRY_MAX_MS : sta_retry_ms * 2;
}

static void sta_reconnect_reset (void)
{
    sta_retry_ms = STA_RETRY_MIN_MS;
    sta_down_since = 0;
    if(sta_retry_timer)
        esp_timer_stop(sta_retry_timer);
}

static void ip_event_handler (void *arg, esp_event_base_t event_base, int32_t event_id, void *event_data)
{
    switch(event_id) {

        case IP_EVENT_STA_GOT_IP:
            // handle IP change (ip_change)
            xEventGroupSetBits(wifi_event_group, CONNECTED_BIT);
            sta_reconnect_reset();
            ap_list.ap_selected = wifi_sta_config.sta.ssid;
            memcpy(&ap_list.ip_addr, &((ip_event_got_ip_t *)event_data)->ip_info.ip, sizeof(ip4_addr_t));
            strcpy(ap_list.ap_status, "Connected");
            start_services(network.services.ssdp);
            if(services.dns) {
                services.dns = Off;
                dns_server_stop();
            }
            if(xEventGroupGetBits(wifi_event_group) & APSTA_BIT) {
                strcpy(wifi.sta.ssid, (char *)wifi_sta_config.sta.ssid);
                strcpy(wifi.sta.password, (char *)wifi_sta_config.sta.password);
                // commit to EEPROM?
            } else
                ap_scan(NULL);
            if(!sta_status.ip_aquired) {
                sta_status.ip_aquired = On;
                status_event_publish((network_flags_t){ .ip_aquired = On });
            }
            break;

        case IP_EVENT_STA_LOST_IP:
            if(sta_status.ip_aquired) {
                sta_status.ip_aquired = Off;
                status_event_publish((network_flags_t){ .ip_aquired = On });
            }
            break;

        default:
            break;
    }
}

static void wifi_event_handler (void *arg, esp_event_base_t event_base, int32_t event_id, void *event_data)
{
    if(event_base == WIFI_EVENT) switch(event_id) {

        case WIFI_EVENT_AP_START:
            if(xEventGroupGetBits(wifi_event_group) & APSTA_BIT) {
                start_services(false);
                services.dns = dns_server_start(sta_netif);
//                task_add_immediate(ap_scan, NULL);
            }
            if(!ap_status.ap_started) {
                ap_status.ap_started = ap_status.ip_aquired = On;
                status_ap_event_publish((network_flags_t){ .ap_started = On, .ip_aquired = On });
            }
            break;
/*??
        case WIFI_EVENT_AP_STOP:
            task_add_immediate(report_plain, "WIFI AP SCAN COMPLETED");
            wifi_stop();
            break;
*/
        case WIFI_EVENT_AP_STACONNECTED:
            task_add_immediate(report_plain, "WIFI AP CONNECTED");
            if(xEventGroupGetBits(wifi_event_group) & APSTA_BIT) {
                if(!(xEventGroupGetBits(wifi_event_group) & CONNECTED_BIT)) {
                    /* // screws up dns?
                    if(!(xEventGroupGetBits(wifi_event_group) & SCANNING_BIT)) {
                      //  ap_list.ap_selected = NULL;
                      //  ap_scan(NULL);
                    }
                    */
                    if(!services.dns)
                        services.dns = dns_server_start(sta_netif);
                }
            } else
                start_services(network.services.ssdp);
            break;

        case WIFI_EVENT_AP_STADISCONNECTED:
#if TELNET_ENABLE
            telnetd_close_connections();
#endif
#if WEBSOCKET_ENABLE
            websocketd_close_connections();
#endif
            if(xEventGroupGetBits(wifi_event_group) & APSTA_BIT)
                ap_scan(NULL);
#if SSDP_ENABLE
            else if(!(xEventGroupGetBits(wifi_event_group) & CONNECTED_BIT))
                ssdp_stop();
#endif
            task_add_immediate(report_plain, "WIFI AP DISCONNECTED");
            break;
                
        case WIFI_EVENT_STA_START:
            if(*wifi_sta_config.sta.ssid != '\0')
                esp_wifi_connect();
            break;

        case WIFI_EVENT_STA_DISCONNECTED:
            //stop_services();
            if(sta_down_since == 0) { // once per outage, not on every reconnect retry
                sta_down_since = esp_timer_get_time();
                // Rev: stock closed these once per drop; each failed retry also raises this event, and these
                // raw lwIP calls race the tcpip thread, so keep them to the first disconnect only.
#if TELNET_ENABLE
                telnetd_close_connections();
#endif
#if WEBSOCKET_ENABLE
                websocketd_close_connections();
#endif
                task_add_immediate(report_plain, "WIFI STA DISCONNECTED");
            }
            // Rev patch: keep the credentials and try again (stock code wiped them and gave up)
            if(*wifi_sta_config.sta.ssid != '\0')
                sta_schedule_retry();
            if((xEventGroupGetBits(wifi_event_group) & APSTA_BIT) && !(xEventGroupGetBits(wifi_event_group) & CONNECTED_BIT)) {
                if(!services.dns)
                    services.dns = dns_server_start(sta_netif);
//                ap_list.ap_selected = NULL;
//                ap_scan(NULL);
            }
/*
            switch(((wifi_event_ap_stadisconnected_t *)event_data)->disconnected.reason) {

                case WIFI_REASON_4WAY_HANDSHAKE_TIMEOUT:
                // fall through
                case WIFI_REASON_NO_AP_FOUND:
                    strcpy(ap_list.ap_status, "Connection failed");
                // fall through
                case WIFI_REASON_ASSOC_LEAVE:
                    memset(&wifi_sta_config, 0, sizeof(wifi_config_t));
                    esp_wifi_set_config(ESP_IF_WIFI_STA, &wifi_sta_config);
                    ap_list.ap_selected = NULL;
                    if(true)
                        ap_scan(NULL);
                    break;

                default:
                    if(xEventGroupGetBits(wifi_event_group) & CONNECTED_BIT)
                        esp_wifi_connect(); // This is a workaround as ESP32 WiFi libs don't currently auto-reassociate.
                    break;
            }
*/
            xEventGroupClearBits(wifi_event_group, CONNECTED_BIT);
            //TCPStreamNotifyLinkStatus(false);
            break;

        case WIFI_EVENT_SCAN_DONE:

            xEventGroupClearBits(wifi_event_group, SCANNING_BIT);

            if(xSemaphoreTake(aplist_mutex, pdMS_TO_TICKS(10)) == pdTRUE) {

                if(ap_list.ap_records)
                    free(ap_list.ap_records);

                ap_list.ap_num = 0;
                esp_wifi_scan_get_ap_num(&ap_list.ap_num);


                if((ap_list.ap_records = (wifi_ap_record_t *)malloc(sizeof(wifi_ap_record_t) * ap_list.ap_num)))
                    esp_wifi_scan_get_ap_records(&ap_list.ap_num, ap_list.ap_records);

                if(!sta_status.ap_scan_completed) {
                    sta_status.ap_scan_completed = On;
                    status_event_publish((network_flags_t){ .ap_scan_completed = On });
                }
                xSemaphoreGive(aplist_mutex);
            }
            // Start a new scan in 10 secs if no station connected...
//          if(!(xEventGroupGetBits(wifi_event_group) & CONNECTED_BIT))
//              task_add_delayed(ap_scan, NULL, 10000);
            break;

        default:
            break;
    } 
}

static inline void set_addr (char *ip, ip4_addr_t *addr)
{
    memcpy(ip, addr, sizeof(ip4_addr_t));
}

static inline void get_addr (esp_ip4_addr_t *addr, char *ip)
{
    memcpy(addr, ip, sizeof(esp_ip4_addr_t));
}

static bool init_adapter (esp_netif_t *netif, network_settings_t *settings)
{
    memcpy(&network, settings, sizeof(network_settings_t));

    if(network.telnet_port == 0)
        network.telnet_port = NETWORK_TELNET_PORT;
    if(network.websocket_port == 0)
        network.websocket_port = NETWORK_WEBSOCKET_PORT;
    if(network.http_port == 0)
        network.http_port = NETWORK_HTTP_PORT;
    if(network.ftp_port == 0)
        network.ftp_port = NETWORK_FTP_PORT;

    esp_netif_ip_info_t ipInfo;

    if(network.ip_mode == IpMode_Static) {

        if(networking_ismemnull(&network.mask, sizeof(ip4_addr_t))) {
            ip4_addr_t addr;
            if(inet_pton(AF_INET, "255.255.255.0", &addr) != 1)
                set_addr(network.mask, &addr);
        }

        get_addr(&ipInfo.ip, network.ip);
        get_addr(&ipInfo.gw, network.gateway);
        get_addr(&ipInfo.netmask, network.mask);
        esp_netif_set_ip_info(netif, &ipInfo);
    }

    return network.ip_mode == IpMode_DHCP;
}

static wifi_mode_t settingToMode (grbl_wifi_mode_t mode)
{
    return mode == WiFiMode_AP ? WIFI_MODE_AP :
           mode == WiFiMode_STA ? WIFI_MODE_STA :
           mode == WiFiMode_APSTA ? WIFI_MODE_APSTA : WIFI_MODE_NULL;
}

bool wifi_start (void)
{
    wifi_mode_t currentMode;

    if(nvs_address == 0)
        return false;

#if !WIFI_SOFTAP
    if(wifi.mode == WiFiMode_APSTA) // Reset to default
        wifi.mode = WIFI_MODE;
#endif

    if(esp_wifi_get_mode(&currentMode) == ESP_ERR_WIFI_NOT_INIT) {

        esp_netif_init();
        esp_event_loop_create_default();

        wifi_event_group = xEventGroupCreate();
        aplist_mutex = xSemaphoreCreateMutex();
        xEventGroupClearBits(wifi_event_group, SCANNING_BIT);

        if(esp_event_handler_instance_register(WIFI_EVENT, ESP_EVENT_ANY_ID, wifi_event_handler, NULL, NULL) != ESP_OK)
            return false;

        if(esp_event_handler_instance_register(IP_EVENT, IP_EVENT_STA_GOT_IP, ip_event_handler, NULL, NULL) != ESP_OK)
            return false;

        wifi_init_config_t cfg = WIFI_INIT_CONFIG_DEFAULT();

        if(esp_wifi_init(&cfg) != ESP_OK)
            return false;

        if(esp_wifi_set_storage(WIFI_STORAGE_RAM) != ESP_OK)
            return false;

        if(esp_wifi_set_mode(WIFI_MODE_NULL) != ESP_OK)
            return false;

        esp_wifi_set_ps(WIFI_PS_NONE);

        currentMode = WIFI_MODE_NULL;
    }

    if(currentMode != settingToMode(wifi.mode) && (wifi.mode == WiFiMode_AP || wifi.mode == WiFiMode_APSTA)) {

        char country[4];
        wifi_config_t wifi_config;

        if(ap_netif == NULL)
            ap_netif = esp_netif_create_default_wifi_ap();

        esp_netif_set_hostname(ap_netif, wifi.ap.network.hostname);

        esp_netif_dhcps_stop(ap_netif);

        wifi.ap.network.ip_mode = IpMode_Static; // Only mode supported

        init_adapter(ap_netif, &wifi.ap.network);

        esp_netif_dhcps_start(ap_netif);

        memset(&wifi_config, 0, sizeof(wifi_config_t));

        if(*wifi.ap.ssid == '\0')
            return false;

        if(strlcpy((char *)wifi_config.ap.ssid, wifi.ap.ssid, sizeof(wifi_config.ap.ssid)) >= sizeof(wifi_config.ap.ssid))
            return false;

        if(*wifi.ap.password == '\0')
            wifi_config.ap.authmode = WIFI_AUTH_OPEN;
        else if(strlcpy((char *)wifi_config.ap.password, wifi.ap.password, sizeof(wifi_config.ap.password)) < sizeof(wifi_config.ap.password))
            wifi_config.ap.authmode = WIFI_AUTH_WPA_WPA2_PSK;
        else
            return false;

        wifi_config.ap.max_connection = 1;
        wifi_config.ap.channel = wifi.ap.channel;

        if(esp_wifi_get_country_code(country) == ESP_OK && strcmp(country, wifi.ap.country))
            esp_wifi_set_country_code(wifi.ap.country, true);

        if(esp_wifi_set_mode(settingToMode(wifi.mode)) != ESP_OK)
            return false;

        if(esp_wifi_set_config(ESP_IF_WIFI_AP, &wifi_config) != ESP_OK)
            return false;

        esp_netif_get_netif_impl_name(ap_netif, ap_if_name);

        if(wifi.mode == WiFiMode_APSTA)
            xEventGroupSetBits(wifi_event_group, APSTA_BIT);
    }

    if(currentMode != settingToMode(wifi.mode) && (wifi.mode == WiFiMode_STA || wifi.mode == WiFiMode_APSTA)) {
        
        if(sta_netif == NULL)
            sta_netif = esp_netif_create_default_wifi_sta();

        esp_netif_set_hostname(sta_netif, wifi.sta.network.hostname);

        esp_netif_dhcpc_stop(sta_netif);
    
        if(init_adapter(sta_netif, &wifi.sta.network))
            esp_netif_dhcpc_start(sta_netif);

        memset(&wifi_sta_config, 0, sizeof(wifi_config_t));

        if(*wifi.sta.ssid != '\0') {

            if(strlcpy((char *)wifi_sta_config.sta.ssid, wifi.sta.ssid, sizeof(wifi_sta_config.sta.ssid)) >= sizeof(wifi_sta_config.sta.ssid))
                return false;

            if(strlcpy((char *)wifi_sta_config.sta.password, wifi.sta.password, sizeof(wifi_sta_config.sta.password)) >= sizeof(wifi_sta_config.sta.password))
                return false;
        }

        if((wifi_sta_config.sta.bssid_set = !networking_ismemnull(wifi.ap.bssid, sizeof(bssid_t))))
            memcpy(wifi_sta_config.sta.bssid, wifi.ap.bssid, sizeof(bssid_t));

        if(esp_wifi_set_mode(settingToMode(wifi.mode)) != ESP_OK)
            return false;

        if(esp_wifi_set_config(ESP_IF_WIFI_STA, &wifi_sta_config) != ESP_OK)
            return false;

        esp_netif_get_netif_impl_name(sta_netif, sta_if_name);

        if(!strcmp(ap_if_name, sta_if_name))
            ap_if_name[2] += 1; // fck ESP
    }

    if(esp_wifi_start() != ESP_OK)
        return false;

    if(wifi.mode == WiFiMode_AP || wifi.mode == WiFiMode_APSTA) {
        ap_status.interface_up = On;
        status_ap_event_publish((network_flags_t){ .interface_up = On });
    }

    if(wifi.mode == WiFiMode_STA || wifi.mode == WiFiMode_APSTA) {
        sta_status.interface_up = On;
        status_event_publish((network_flags_t){ .interface_up = On });
    }

    if(wifi.mode == WiFiMode_APSTA)
        ap_scan(NULL);

    return true;
}

bool wifi_ap_connect (char *ssid, char *password)
{
    bool ok = !ssid || (strlen(ssid) > 0 && strlen(ssid) < sizeof(ssid_t) && strlen(password) < sizeof(password_t));

    if(!ok)
        return false;

    sta_reconnect_reset();

    if(xEventGroupGetBits(wifi_event_group) & CONNECTED_BIT)
        esp_wifi_disconnect(); // TODO: delay until response is sent...

    if(xSemaphoreTake(aplist_mutex, pdMS_TO_TICKS(10)) == pdTRUE) {

        ap_list.ap_selected = NULL;
        memset(&ap_list.ip_addr, 0, sizeof(ip4_addr_t));
        strcpy(ap_list.ap_status, ssid ? "Connecting..." : "");

        xSemaphoreGive(aplist_mutex);
    }

    memset(&wifi_sta_config, 0, sizeof(wifi_config_t));

    if(ssid) {

        strcpy((char *)wifi_sta_config.sta.ssid, ssid);
        strcpy((char *)wifi_sta_config.sta.password, password);

        ok = esp_wifi_set_config(ESP_IF_WIFI_STA, &wifi_sta_config) == ESP_OK && esp_wifi_connect() == ESP_OK;
    }

    return ok;
}

bool wifi_stop (void)
{
    stop_services();

    esp_wifi_stop();

    return true;
}

//

static status_code_t wifi_set_int (setting_id_t setting, uint_fast16_t value)
{
    switch(setting) {

        case Setting_NetworkServices:
            wifi.sta.network.services.mask = wifi.ap.network.services.mask = (uint8_t)value & allowed_services.mask;
            break;

        case Setting_IpMode3:
            wifi.sta.network.ip_mode = (ip_mode_t)value;
            break;

#if TELNET_ENABLE
        case Setting_TelnetPort3:
            wifi.sta.network.telnet_port = wifi.ap.network.telnet_port = (uint16_t)value;
            break;
#endif

#if FTP_ENABLE
        case Setting_FtpPort3:
            wifi.sta.network.ftp_port = wifi.ap.network.ftp_port = (uint16_t)value;
            break;
#endif

#if HTTP_ENABLE
        case Setting_HttpPort3:
            wifi.sta.network.http_port = wifi.ap.network.http_port = (uint16_t)value;
            break;
#endif

#if WEBSOCKET_ENABLE
        case Setting_WebSocketPort3:
            wifi.sta.network.websocket_port = wifi.ap.network.websocket_port = (uint16_t)value;
            break;
#endif

        default:
            break;
    }

    return Status_OK;
}

static uint_fast16_t wifi_get_int (setting_id_t setting)
{
    uint_fast16_t value = 0;

    switch(setting) {

        case Setting_NetworkServices:
            value = wifi.sta.network.services.mask & allowed_services.mask;
            break;

        case Setting_IpMode3:
            value = wifi.sta.network.ip_mode;
            break;

#if TELNET_ENABLE
        case Setting_TelnetPort3:
            value = wifi.sta.network.telnet_port;
            break;
#endif

#if FTP_ENABLE
        case Setting_FtpPort3:
            value = wifi.sta.network.ftp_port;
            break;
#endif

#if HTTP_ENABLE
        case Setting_HttpPort3:
            value = wifi.sta.network.http_port;
            break;
#endif

#if WEBSOCKET_ENABLE
        case Setting_WebSocketPort3:
            value = wifi.sta.network.websocket_port;
            break;
#endif

        default:
            break;
    }

    return value;
}

static status_code_t wifi_set_ip (setting_id_t setting, char *value)
{
    ip4_addr_t addr;

    if(inet_pton(AF_INET, value, &addr) != 1)
        return Status_InvalidStatement;

    status_code_t status = Status_OK;

    switch(setting) {

        case Setting_IpAddress3:
            set_addr(wifi.sta.network.ip, &addr);
            break;

        case Setting_Gateway3:
            set_addr(wifi.sta.network.gateway, &addr);
            break;

        case Setting_NetMask3:
            set_addr(wifi.sta.network.mask, &addr);
            break;

#if MQTT_ENABLE
        case Setting_MQTTBrokerIpAddress:
            set_addr(wifi.sta.network.mqtt.ip, &addr);
            break;
#endif

#if WIFI_SOFTAP

        case Setting_IpAddress2:
            set_addr(wifi.ap.network.ip, &addr);
            break;

        case Setting_Gateway2:
            set_addr(wifi.ap.network.gateway, &addr);
            break;

        case Setting_NetMask2:
            set_addr(wifi.ap.network.mask, &addr);
            break;

#endif

        default:
            status = Status_Unhandled;
            break;
    }

    return status;
}

static char *wifi_get_ip (setting_id_t setting)
{
    static char ip[INET6_ADDRSTRLEN];

    switch(setting) {

        case Setting_IpAddress3:
            inet_ntop(AF_INET, &wifi.sta.network.ip, ip, INET6_ADDRSTRLEN);
            break;

        case Setting_Gateway3:
            inet_ntop(AF_INET, &wifi.sta.network.gateway, ip, INET6_ADDRSTRLEN);
            break;

        case Setting_NetMask3:
            inet_ntop(AF_INET, &wifi.sta.network.mask, ip, INET6_ADDRSTRLEN);
            break;

#if MQTT_ENABLE
        case Setting_MQTTBrokerIpAddress:
            inet_ntop(AF_INET, &wifi.sta.network.mqtt.ip, ip, INET6_ADDRSTRLEN);
            break;
#endif

#if WIFI_SOFTAP

        case Setting_IpAddress2:
            inet_ntop(AF_INET, &wifi.ap.network.ip, ip, INET6_ADDRSTRLEN);
            break;

        case Setting_Gateway2:
            inet_ntop(AF_INET, &wifi.ap.network.gateway, ip, INET6_ADDRSTRLEN);
            break;

        case Setting_NetMask2:
            inet_ntop(AF_INET, &wifi.ap.network.mask, ip, INET6_ADDRSTRLEN);
            break;

#endif

        default:
            *ip = '\0';
            break;
    }

    return ip;
}

static status_code_t wifi_set_bssid (setting_id_t setting, char *value)
{
    if(*value) {

        uint32_t bssid[6];
        if(sscanf(value,"%2X:%2X:%2X:%2X:%2X:%2X", &bssid[5], &bssid[4], &bssid[3],
                                                    &bssid[2], &bssid[1], &bssid[0]) == 6) {

            char c = LCAPS(value[strlen(value) - 1]);
            if(!((c >= '0' && c <= '9') || (c >= 'a' && c <= 'f')))
                return Status_InvalidStatement;

            uint_fast8_t idx;
            for(idx = 0; idx < 6; idx++)
                wifi.ap.bssid[idx] = bssid[idx];
        } else
            return Status_InvalidStatement;
    } else
        memset(wifi.ap.bssid, 0, sizeof(bssid_t));

    return Status_OK;
}

static char *wifi_get_bssid (setting_id_t setting)
{
    static char bssid[18];

    if(networking_ismemnull(wifi.ap.bssid, sizeof(bssid_t)))
        *bssid = '\0';
    else
        sprintf(bssid, MAC_FORMAT_STRING, wifi.ap.bssid[5], wifi.ap.bssid[4], wifi.ap.bssid[3],
                                           wifi.ap.bssid[2], wifi.ap.bssid[1], wifi.ap.bssid[0]);
    return bssid;
}

#if WIFI_SOFTAP

static status_code_t wifi_set_country (setting_id_t setting, char *value)
{
    status_code_t status;

    strcaps(value);

    if((status = validate_country_code(value) ? Status_OK : Status_GcodeValueOutOfRange) == Status_OK)
        strcpy(wifi.ap.country, value);

    return status;
}

static char *wifi_get_country (setting_id_t setting)
{
    return wifi.ap.country;
}

#endif

FLASHMEM static bool is_wifi_enabled (const setting_detail_t *setting, uint_fast16_t offset)
{
#if ETHERNET_ENABLE
    return wifi.mode != WiFiMode_NULL;
#else
    return true;
#endif
}

static const setting_group_detail_t wifi_groups [] = {
    { Group_Root, Group_Networking, "Networking" },
    { Group_Networking, Group_Networking_Wifi, "WiFi" }
};

static const setting_detail_t wifi_settings[] = {
    { Setting_NetworkServices, Group_Networking, "Network Services", NULL, Format_Bitfield, netservices, NULL, NULL, Setting_NonCoreFn, wifi_set_int, wifi_get_int, is_wifi_enabled, { .reboot_required = On } },
    { Setting_WiFi_STA_SSID, Group_Networking_Wifi, "WiFi Station (STA) SSID", NULL, Format_String, "x(64)", NULL, "64", Setting_NonCore, &wifi.sta.ssid, NULL, NULL },
    { Setting_Wifi_AP_BSSID, Group_Networking_Wifi, "WiFi Access Point (AP) BSSID", NULL, Format_String, "x(17)", "17", "17", Setting_NonCoreFn, wifi_set_bssid, wifi_get_bssid, NULL, { .allow_null = On, .reboot_required = On } },
    { Setting_WiFi_STA_Password, Group_Networking_Wifi, "WiFi Station (STA) Password", NULL, Format_Password, "x(32)", "8", "32", Setting_NonCore, &wifi.sta.password, NULL, NULL, { .allow_null = On } },
    { Setting_Hostname3, Group_Networking, "Hostname", NULL, Format_String, "x(64)", NULL, "64", Setting_NonCore, &wifi.sta.network.hostname, NULL, NULL, { .reboot_required = On } },
    { Setting_IpMode3, Group_Networking, "IP Mode", NULL, Format_RadioButtons, "Static,DHCP", NULL, NULL, Setting_NonCoreFn, wifi_set_int, wifi_get_int, NULL, { .reboot_required = On } },
    { Setting_IpAddress3, Group_Networking, "IP Address", NULL, Format_IPv4, NULL, NULL, NULL, Setting_NonCoreFn, wifi_set_ip, wifi_get_ip, NULL, { .reboot_required = On } },
    { Setting_Gateway3, Group_Networking, "Gateway", NULL, Format_IPv4, NULL, NULL, NULL, Setting_NonCoreFn, wifi_set_ip, wifi_get_ip, NULL, { .reboot_required = On } },
    { Setting_NetMask3, Group_Networking, "Netmask", NULL, Format_IPv4, NULL, NULL, NULL, Setting_NonCoreFn, wifi_set_ip, wifi_get_ip, NULL, { .reboot_required = On } },
#if WIFI_SOFTAP
    { Setting_WifiMode, Group_Networking_Wifi, "WiFi Mode", NULL, Format_RadioButtons, "Off,Station,Access Point,Access Point/Station", NULL, NULL, Setting_NonCore, &wifi.mode, NULL, NULL },
    { Setting_WiFi_AP_SSID, Group_Networking_Wifi, "WiFi Access Point (AP) SSID", NULL, Format_String, "x(64)", NULL, "64", Setting_NonCore, &wifi.ap.ssid, NULL, NULL },
    { Setting_WiFi_AP_Password, Group_Networking_Wifi, "WiFi Access Point (AP) Password", NULL, Format_Password, "x(32)", "8", "32", Setting_NonCore, &wifi.ap.password, NULL, NULL, { .allow_null = On } },
    { Setting_Wifi_AP_Country, Group_Networking_Wifi, "WiFi Country Code", NULL, Format_String, "x(2)", "2", "2", Setting_NonCoreFn, wifi_set_country, wifi_get_country, NULL, { .allow_null = On, .reboot_required = On } },
    { Setting_Wifi_AP_Channel, Group_Networking_Wifi, "WiFi Channel (AP)", NULL, Format_Int8, "#0", "1", "13", Setting_NonCore, &wifi.ap.channel, NULL, NULL, { .reboot_required = On } },
    { Setting_Hostname2, Group_Networking, "Hostname (AP)", NULL, Format_String, "x(64)", NULL, "64", Setting_NonCore, &wifi.ap.network.hostname, NULL, NULL, { .reboot_required = On } },
    { Setting_IpAddress2, Group_Networking, "IP Address (AP)", NULL, Format_IPv4, NULL, NULL, NULL, Setting_NonCoreFn, wifi_set_ip, wifi_get_ip, NULL, { .reboot_required = On } },
    { Setting_Gateway2, Group_Networking, "Gateway (AP)", NULL, Format_IPv4, NULL, NULL, NULL, Setting_NonCoreFn, wifi_set_ip, wifi_get_ip, NULL, { .reboot_required = On } },
    { Setting_NetMask2, Group_Networking, "Netmask (AP)", NULL, Format_IPv4, NULL, NULL, NULL, Setting_NonCoreFn, wifi_set_ip, wifi_get_ip, NULL, { .reboot_required = On } },
#else
    { Setting_WifiMode, Group_Networking_Wifi, "WiFi Mode", NULL, Format_RadioButtons, "Off,Station", NULL, NULL, Setting_NonCore, &wifi.mode, NULL, NULL },
#endif
#if TELNET_ENABLE
    { Setting_TelnetPort3, Group_Networking, "Telnet port", NULL, Format_Int16, "####0", "1", "65535", Setting_NonCoreFn, wifi_set_int, wifi_get_int, NULL, { .reboot_required = On } },
#endif
#if HTTP_ENABLE
    { Setting_HttpPort3, Group_Networking, "HTTP port", NULL, Format_Int16, "####0", "1", "65535", Setting_NonCoreFn, wifi_set_int, wifi_get_int, NULL, { .reboot_required = On } },
#endif
#if FTP_ENABLE
    { Setting_FtpPort3, Group_Networking, "FTP port", NULL, Format_Int16, "####0", "1", "65535", Setting_NonCoreFn, wifi_set_int, wifi_get_int, NULL, { .reboot_required = On } },
#endif
#if WEBSOCKET_ENABLE
    { Setting_WebSocketPort3, Group_Networking, "Websocket port", NULL, Format_Int16, "####0", "1", "65535", Setting_NonCoreFn, wifi_set_int, wifi_get_int, NULL, { .reboot_required = On } },
#endif
#if MQTT_ENABLE
    { Setting_MQTTBrokerIpAddress, Group_Networking, "MQTT broker IP Address", NULL, Format_IPv4, NULL, NULL, NULL, Setting_NonCoreFn, wifi_set_ip, wifi_get_ip, NULL, { .reboot_required = On } },
    { Setting_MQTTBrokerPort, Group_Networking, "MQTT broker port", NULL, Format_Int16, "####0", "1", "65535", Setting_NonCore, &wifi.sta.network.mqtt.port, NULL, NULL, { .reboot_required = On } },
    { Setting_MQTTBrokerUserName, Group_Networking, "MQTT broker username", NULL, Format_String, "x(32)", NULL, "32", Setting_NonCore, &wifi.sta.network.mqtt.user, NULL, NULL, { .allow_null = On } },
    { Setting_MQTTBrokerPassword, Group_Networking, "MQTT broker password", NULL, Format_Password, "x(32)", NULL, "32", Setting_NonCore, &wifi.sta.network.mqtt.password, NULL, NULL, { .allow_null = On } },
#endif
};

static const setting_descr_t ethernet_settings_descr[] = {
    { Setting_NetworkServices, "Network services to enable." },
    { Setting_WiFi_STA_SSID, "WiFi Station (STA) SSID." },
    { Setting_Wifi_AP_BSSID, "Optional WiFi Access Point BSSID (MAC) to connect to, colon delimited values." },
    { Setting_WiFi_STA_Password, "WiFi Station (STA) Password." },
    { Setting_Hostname3, "Network hostname." },
    { Setting_IpMode3, "IP Mode." },
    { Setting_IpAddress3, "Static IP address." },
    { Setting_Gateway3, "Static gateway address." },
    { Setting_NetMask3, "Static netmask." },
#if WIFI_SOFTAP
    { Setting_WifiMode, "WiFi Mode." },
    { Setting_WiFi_AP_SSID, "WiFi Access Point (AP) SSID." },
    { Setting_WiFi_AP_Password, "WiFi Access Point (AP) Password." },
    { Setting_Wifi_AP_Country, "ISO3166 country code, controls availability of channels 12-14.\\n"
                               "Set to ""01"" for generic worldwide channels." },
    { Setting_Wifi_AP_Channel, "WiFi Access Point (AP) channel to use.\\n May be overridden when connecting to an Access Point as station or by country setting." },
    { Setting_Hostname2, "Network hostname." },
    { Setting_IpAddress2, "Static IP address." },
    { Setting_Gateway2, "Static gateway address." },
    { Setting_NetMask2, "Static netmask." },
#else
    { Setting_WifiMode, "WiFi Mode." },
#endif
#if TELNET_ENABLE
    { Setting_TelnetPort3, "(Raw) Telnet port number listening for incoming connections." },
#endif
#if FTP_ENABLE
    { Setting_FtpPort3, "FTP port number listening for incoming connections." },
#endif
#if HTTP_ENABLE
    { Setting_HttpPort3, "HTTP port number listening for incoming connections." },
#endif
#if WEBSOCKET_ENABLE
    { Setting_WebSocketPort3, "Websocket port number listening for incoming connections.\n"
                              "NOTE: WebUI requires this to be HTTP port number + 1."
    },
#endif
#if MQTT_ENABLE
    { Setting_MQTTBrokerIpAddress, "IP address for remote MQTT broker. Set to 0.0.0.0 to disable connection." },
    { Setting_MQTTBrokerPort, "Remote MQTT broker portnumber." },
    { Setting_MQTTBrokerUserName, "Remote MQTT broker username." },
    { Setting_MQTTBrokerPassword, "Remote MQTT broker password." },
#endif
};

static void wifi_settings_save (void)
{
    hal.nvs.memcpy_to_nvs(nvs_address, (uint8_t *)&wifi, sizeof(wifi_settings_t), true);
}

#if WIFI_SOFTAP

static void ap_settings_restore (void)
{
    ip4_addr_t addr;

    wifi.ap.network.ip_mode = IpMode_Static;
    strlcpy(wifi.ap.network.hostname, NETWORK_AP_HOSTNAME, sizeof(wifi.ap.network.hostname));
    strlcpy(wifi.ap.ssid, NETWORK_AP_SSID, sizeof(wifi.ap.ssid));
    strlcpy(wifi.ap.password, NETWORK_AP_PASSWORD, sizeof(wifi.ap.password));

    if(inet_pton(AF_INET, NETWORK_AP_IP, &addr) == 1)
        set_addr(wifi.ap.network.ip, &addr);

    if(inet_pton(AF_INET, NETWORK_AP_GATEWAY, &addr) == 1)
        set_addr(wifi.ap.network.gateway, &addr);

    if(inet_pton(AF_INET, NETWORK_AP_MASK, &addr) == 1)
        set_addr(wifi.ap.network.mask, &addr);
}

#endif

static void wifi_settings_restore (void)
{
    ip4_addr_t addr;

    memset(&wifi, 0, sizeof(wifi_settings_t));

    wifi.mode = WIFI_MODE;

// Station

    strlcpy(wifi.sta.network.hostname, NETWORK_STA_HOSTNAME, sizeof(wifi.sta.network.hostname));

    wifi.sta.network.ip_mode = (ip_mode_t)NETWORK_STA_IPMODE;

    if(inet_pton(AF_INET, NETWORK_STA_IP, &addr) == 1)
        set_addr(wifi.sta.network.ip, &addr);

    if(inet_pton(AF_INET, NETWORK_STA_GATEWAY, &addr) == 1)
        set_addr(wifi.sta.network.gateway, &addr);

#if NETWORK_IPMODE == 0
    if(inet_pton(AF_INET, NETWORK_STA_MASK, &addr) == 1)
        set_addr(wifi.sta.network.mask, &addr);
 #else
    if(inet_pton(AF_INET, "255.255.255.0", &addr) == 1)
        set_addr(wifi.sta.network.mask, &addr);
#endif

#if WIFI_SOFTAP

// Access Point

    ap_settings_restore();

#endif

// Common

    wifi.sta.network.telnet_port = wifi.ap.network.telnet_port = NETWORK_TELNET_PORT;
    wifi.sta.network.ftp_port = wifi.ap.network.ftp_port = NETWORK_FTP_PORT;
    wifi.sta.network.http_port = wifi.ap.network.http_port = NETWORK_HTTP_PORT;
    wifi.sta.network.websocket_port = wifi.ap.network.websocket_port = NETWORK_WEBSOCKET_PORT;
    wifi.sta.network.services = wifi.ap.network.services = allowed_services;

#if MQTT_ENABLE

    wifi.sta.network.mqtt.port = NETWORK_MQTT_PORT;

  #ifdef MQTT_IP_ADDRESS
    if(ip4addr_aton(MQTT_IP_ADDRESS, &addr) == 1)
        set_addr(wifi.sta.network.mqtt.ip, &addr);
  #endif

 #ifdef MQTT_USERNAME
    strcpy(wifi.sta.network.mqtt.user, MQTT_USERNAME);
 #endif
 #ifdef MQTT_PASSWORD
    strcpy(wifi.sta.network.mqtt.password, MQTT_PASSWORD);
 #endif

#endif

    hal.nvs.memcpy_to_nvs(nvs_address, (uint8_t *)&wifi, sizeof(wifi_settings_t), true);
}

static void wifi_settings_load (void)
{
    if(hal.nvs.memcpy_from_nvs((uint8_t *)&wifi, nvs_address, sizeof(wifi_settings_t), true) != NVS_TransferResult_OK)
        wifi_settings_restore();

    if(wifi.ap.channel == 0 || wifi.ap.channel > 13)
        wifi.ap.channel = 1;

    if(!validate_country_code(wifi.ap.country))
        strcpy(wifi.ap.country, country_codes[0]);

    wifi.sta.network.services.mask &= allowed_services.mask;
    wifi.ap.network.services.mask &= allowed_services.mask;

#if WIFI_SOFTAP
    if((wifi.mode == WiFiMode_AP || wifi.mode == WiFiMode_APSTA) && networking_ismemnull(&wifi.ap.network.ip, sizeof(ip4_addr_t)))
        ap_settings_restore();
#endif

    if(wifi.sta.network.services.http &&
        wifi.sta.network.services.websocket &&
         wifi.sta.network.websocket_port == wifi.sta.network.http_port)
        wifi.sta.network.websocket_port++;

    if(wifi.ap.network.services.http &&
        wifi.ap.network.services.websocket &&
         wifi.ap.network.websocket_port == wifi.ap.network.http_port)
        wifi.ap.network.websocket_port++;
}

bool wifi_init (void)
{
    static setting_details_t setting_details = {
        .groups = wifi_groups,
        .n_groups = sizeof(wifi_groups) / sizeof(setting_group_detail_t),
        .settings = wifi_settings,
        .n_settings = sizeof(wifi_settings) / sizeof(setting_detail_t),
        .descriptions = ethernet_settings_descr,
        .n_descriptions = sizeof(ethernet_settings_descr) / sizeof(setting_descr_t),
        .save = wifi_settings_save,
        .load = wifi_settings_load,
        .restore = wifi_settings_restore
    };

    if((hal.driver_cap.wifi = (nvs_address = nvs_alloc(sizeof(wifi_settings_t))) != 0)) {

        networking_init();

#if MQTT_ENABLE
        on_client_connected = mqtt_events.on_client_connected;
        mqtt_events.on_client_connected = mqtt_connection_changed;
#endif
        settings_register(&setting_details);

        networking.get_info = get_info;

        allowed_services.mask = networking_get_services_list((char *)netservices).mask;
    }

    return nvs_address != 0;
}

#endif // WIFI_ENABLE
