revjmoney/revturn-lathe-firmware/main/timers.c

/*

  timers.c - driver code for ESP32 processors

  Part of grblHAL

  Copyright (c) 2024-2025 Terje Io
  REVTURN changes Copyright (c) 2026 JMSCNC / Rev. J. Money (jmscnc.com), same license.

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
  You should have received a copy of the GNU General Public License
  along with grblHAL. If not, see <http://www.gnu.org/licenses/>.
*/

#include "driver.h"

#include "hal/timer_hal.h"

#define TIMER_ENTER_CRITICAL(mux)      portENTER_CRITICAL_SAFE(mux);
#define TIMER_EXIT_CRITICAL(mux)       portEXIT_CRITICAL_SAFE(mux);

typedef struct {
    timer_hal_context_t hal;
	uint32_t group;
	portMUX_TYPE mux;
    timer_resolution_t resolution;
    bool claimed;
    timer_cfg_t cfg;
    timer_cap_t cap;
    uint32_t freq_hz;
    uint32_t timebase;
    void (*isr)(void * arg);
} dtimer_t;

IRAM_ATTR static void timer01_isr (void *arg)
{
    timer_ll_clear_intr_status(&TIMERG0, TIMER_1);
    if(!((dtimer_t *)arg)->cfg.single_shot)
        timer_ll_set_alarm_enable(&TIMERG0, TIMER_1, true);

    ((dtimer_t *)arg)->cfg.timeout_callback(((dtimer_t *)arg)->cfg.context);
}

IRAM_ATTR static void timer10_isr (void *arg)
{
    timer_ll_clear_intr_status(&TIMERG1, TIMER_0);
    if(!((dtimer_t *)arg)->cfg.single_shot)
        timer_ll_set_alarm_enable(&TIMERG1, TIMER_0, true);

    ((dtimer_t *)arg)->cfg.timeout_callback(((dtimer_t *)arg)->cfg.context);
}

IRAM_ATTR static void timer11_isr (void *arg)
{
    timer_ll_clear_intr_status(&TIMERG1, TIMER_1);
    if(!((dtimer_t *)arg)->cfg.single_shot)
        timer_ll_set_alarm_enable(&TIMERG1, TIMER_1, true);

    ((dtimer_t *)arg)->cfg.timeout_callback(((dtimer_t *)arg)->cfg.context);
}

static dtimer_t timers[] = {
	{ .hal.dev = &TIMERG0, .hal.idx = 1, .group = 0, .freq_hz = 80000000, .isr = timer01_isr, .mux = portMUX_INITIALIZER_UNLOCKED },
	{ .hal.dev = &TIMERG1, .hal.idx = 0, .group = 1, .freq_hz = 80000000, .isr = timer10_isr, .mux = portMUX_INITIALIZER_UNLOCKED },
	{ .hal.dev = &TIMERG1, .hal.idx = 1, .group = 1, .freq_hz = 80000000, .isr = timer11_isr, .mux = portMUX_INITIALIZER_UNLOCKED }
};

hal_timer_t timerClaim (timer_cap_t cap, uint32_t timebase)
{
    hal_timer_t t;
    uint_fast8_t idx, n_timers = sizeof(timers) / sizeof(dtimer_t);

    for(idx = 0; idx < n_timers; idx++) {
        if((t = timers[idx].claimed ? NULL : &timers[idx])) {
        	timers[idx].claimed = true;
        	timers[idx].timebase = timebase;
        	break;
        }
    }

    return t;
}

bool timerCfg (hal_timer_t timer, timer_cfg_t *cfg)
{
    bool ok;

    if((ok = timer != NULL)) {

    	dtimer_t *dtimer = (dtimer_t *)timer;

        memcpy(&dtimer->cfg, cfg, sizeof(timer_cfg_t));

        timer_config_t timerConfig = {
            .counter_dir = TIMER_COUNT_UP,
            .counter_en  = TIMER_PAUSE,
            .alarm_en    = TIMER_ALARM_EN,
            .intr_type   = TIMER_INTR_LEVEL
        };

        timerConfig.auto_reload = !cfg->single_shot;
        timerConfig.divider = ((dtimer->freq_hz / 1000) * dtimer->timebase) / 1000000;

        timer_init(dtimer->group, dtimer->hal.idx, &timerConfig);
        timer_set_counter_value(dtimer->group, dtimer->hal.idx, 0ULL);
        timer_isr_register(dtimer->group, dtimer->hal.idx, dtimer->isr, timer, ESP_INTR_FLAG_IRAM, NULL);
        timer_enable_intr(dtimer->group, dtimer->hal.idx);
    }

    return ok;
}

IRAM_ATTR bool timerStart (hal_timer_t timer, uint32_t period) // Rev: called from the st2 IRAM timer ISR
{
    dtimer_t *dtimer = (dtimer_t *)timer;

    if(dtimer->cfg.single_shot || period != dtimer->cfg.period) {

        TIMER_ENTER_CRITICAL(&dtimer->mux);
        ((dtimer_t *)timer)->cfg.period = period;
        timer_ll_set_counter_value(dtimer->hal.dev, dtimer->hal.idx, 0);
        timer_ll_set_alarm_value(dtimer->hal.dev, dtimer->hal.idx, (uint64_t)period);
        timer_ll_set_counter_enable(dtimer->hal.dev, dtimer->hal.idx, true);
        timer_ll_set_alarm_enable(dtimer->hal.dev, dtimer->hal.idx, true);
        TIMER_EXIT_CRITICAL(&dtimer->mux);
    }

    return true;
}

IRAM_ATTR bool timerStop (hal_timer_t timer) // Rev: called from the st2 IRAM timer ISR
{
    ((dtimer_t *)timer)->cfg.period = 0;
    timer_ll_set_counter_enable(((dtimer_t *)timer)->hal.dev, ((dtimer_t *)timer)->hal.idx, false);

    return true;
}
