revjmoney/revturn-lathe-firmware/screen/test/fixtures/grblhal-settings.txt

[SETTINGGROUP:0|0|Root]
[SETTINGGROUP:1|0|General]
[SETTINGGROUP:2|0|Control signals]
[SETTINGGROUP:3|0|Limits]
[SETTINGGROUP:5|0|Coolant]
[SETTINGGROUP:6|0|Spindle]
[SETTINGGROUP:9|0|Tool change]
[SETTINGGROUP:11|0|Homing]
[SETTINGGROUP:13|0|Parking/Safety door]
[SETTINGGROUP:14|0|Jogging]
[SETTINGGROUP:15|0|Networking]
[SETTINGGROUP:16|15|WiFi]
[SETTINGGROUP:35|0|Stepper]
[SETTINGGROUP:42|0|MPG/Pendant]
[SETTINGGROUP:43|0|Axis]
[SETTINGGROUP:44|43|X-axis]
[SETTINGGROUP:45|43|Y-axis]
[SETTINGGROUP:46|43|Z-axis]
[SETTINGGROUP:47|43|C-axis]
[SETTING:0|35|Step pulse time|microseconds|6|#0.0|2.0||0|0]
[SETTING:1|35|Step idle delay|milliseconds|5|####0||65535|0|0]
[SETTING:2|35|Step pulse invert||4||||0|0]
[SETTING:3|35|Step direction invert||4||||0|0]
[SETTING:4|35|Invert stepper enable output(s)||4||||0|0]
[SETTING:5|3|Invert limit inputs||4||||0|0]
[SETTING:9|6|PWM spindle options||2|Enable,RPM controls spindle enable signal,Disable laser mode capability,Enable ramping,Ignore on/off delays|||0|0]
[SETTING:10|1|Status report options||1|Position in machine coordinate,Buffer state,Line numbers,Feed & speed,Pin state,Work coordinate offset,Overrides,Probe coordinates,Buffer sync on WCO change,Parser state,Alarm substatus,Run substatus,Enable when homing,Distance-to-go,Extended|||0|0]
[SETTING:11|1|Junction deviation|mm|6|#####0.000|||0|0]
[SETTING:12|1|Arc tolerance|mm|6|#####0.000|||0|0]
[SETTING:13|1|Report in inches||0||||0|0]
[SETTING:14|2|Invert control inputs||1|N/A,N/A,N/A,N/A,N/A,N/A,EStop|||0|0]
[SETTING:15|5|Invert coolant outputs||1|Flood|||0|0]
[SETTING:16|6|Invert spindle signals||1|Spindle enable,Spindle direction,PWM|||1|0]
[SETTING:17|2|Pullup disable control inputs||1|N/A,N/A,N/A,N/A,N/A,N/A,EStop|||0|0]
[SETTING:18|3|Pullup disable limit inputs||4||||0|0]
[SETTING:20|3|Soft limits enable||0||||0|0]
[SETTING:21|3|Hard limits enable||2|Enable,Strict mode,Disable for rotary axes|||0|0]
[SETTING:22|11|Homing cycle||2|Enable,Enable single axis commands,Homing on startup required,Set machine origin to 0,Two switches shares one input,Allow manual,Override locks,N/A,N/A,Per axis feedrates,Run startup scripts only on homing completed|||0|0]
[SETTING:23|11|Homing direction invert||4||||0|0]
[SETTING:24|11|Homing locate feed rate|mm/min|6|#####0.0|||0|0]
[SETTING:25|11|Homing search seek rate|mm/min|6|#####0.0|||0|0]
[SETTING:26|11|Homing switch debounce delay|milliseconds|5|##0|||0|0]
[SETTING:27|11|Homing switch pull-off distance|mm|6|#####0.000|||0|0]
[SETTING:28|1|G73 Retract distance|mm|6|#####0.000|||0|0]
[SETTING:29|35|Pulse delay|microseconds|6|#0.0||20|0|0]
[SETTING:30|6|Maximum spindle speed|RPM|6|#####0.000|||0|0]
[SETTING:31|6|Minimum spindle speed|RPM|6|#####0.000|||0|0]
[SETTING:32|1|Mode of operation||3|Normal,Laser mode,Lathe mode|||0|0]
[SETTING:33|6|Spindle PWM frequency|Hz|6|#####0|||0|0]
[SETTING:34|6|Spindle PWM off value|percent|6|##0.0||100|0|0]
[SETTING:35|6|Spindle PWM min value|percent|6|##0.0||100|0|0]
[SETTING:36|6|Spindle PWM max value|percent|6|##0.0||100|0|0]
[SETTING:37|35|Steppers to keep enabled||4||||0|0]
[SETTING:39|1|Enable legacy RT commands||0||||0|0]
[SETTING:40|14|Limit jog commands||0||||0|0]
[SETTING:41|13|Parking cycle||2|Enable,Deactivate upon init,Enable parking override control|||0|0]
[SETTING:42|13|Parking axis||3|X,Y,Z|||0|0]
[SETTING:43|11|Homing passes||5|##0|1|128|0|0]
[SETTING:44|11|Axes homing, first phase||4||||0|0]
[SETTING:45|11|Axes homing, second phase||4||||0|0]
[SETTING:46|11|Axes homing, third phase||4||||0|0]
[SETTING:47|11|Axes homing, fourth phase||4||||0|0]
[SETTING:56|13|Parking pull-out distance|mm|6|###0.0|||0|0]
[SETTING:57|13|Parking pull-out rate|mm/min|6|###0.0|||0|0]
[SETTING:58|13|Parking target|mm|6|-###0.0|-100000||0|0]
[SETTING:59|13|Parking fast rate|mm/min|6|###0.0|||0|0]
[SETTING:60|1|Restore overrides||0||||0|0]
[SETTING:61|13|Safety door options||1|N/A,Keep coolant state on door open|||0|0]
[SETTING:62|1|Sleep enable||0||||0|0]
[SETTING:63|1|Feed hold actions||1|Disable laser during hold,Restore spindle and coolant state on resume,Set RPM to minimum (except for laser M4)|||0|0]
[SETTING:64|1|Force init alarm||0||||0|0]
[SETTING:70|15|Network Services||1|Telnet,Websocket,HTTP,FTP,N/A,mDNS|||1|0]
[SETTING:73|16|WiFi Mode||3|Off,Station,Access Point,Access Point/Station|||0|0]
[SETTING:74|16|WiFi Station (STA) SSID||7|x(64)||64|0|0]
[SETTING:75|16|WiFi Station (STA) Password||8|x(32)|8|32|0|1]
[SETTING:76|16|WiFi Access Point (AP) SSID||7|x(64)||64|0|0]
[SETTING:77|16|WiFi Access Point (AP) Password||8|x(32)|8|32|0|1]
[SETTING:78|16|WiFi Country Code||7|x(2)|2|2|1|1]
[SETTING:79|16|WiFi Channel (AP)||5|#0|1|13|1|0]
[SETTING:100|44|X-axis travel resolution|step/mm|6|#####0.000##|||0|0]
[SETTING:101|45|Y-axis travel resolution|step/mm|6|#####0.000##|||0|0]
[SETTING:102|46|Z-axis travel resolution|step/mm|6|#####0.000##|||0|0]
[SETTING:103|47|C-axis travel resolution|step/deg|6|#####0.000##|||0|0]
[SETTING:110|44|X-axis maximum rate|mm/min|6|#####0.000|||0|0]
[SETTING:111|45|Y-axis maximum rate|mm/min|6|#####0.000|||0|0]
[SETTING:112|46|Z-axis maximum rate|mm/min|6|#####0.000|||0|0]
[SETTING:113|47|C-axis maximum rate|deg/min|6|#####0.000|||0|0]
[SETTING:120|44|X-axis acceleration|mm/sec^2|6|#####0.000|||0|0]
[SETTING:121|45|Y-axis acceleration|mm/sec^2|6|#####0.000|||0|0]
[SETTING:122|46|Z-axis acceleration|mm/sec^2|6|#####0.000|||0|0]
[SETTING:123|47|C-axis acceleration|deg/sec^2|6|#####0.000|||0|0]
[SETTING:130|44|X-axis maximum travel|mm|6|#####0.000|||0|0]
[SETTING:131|45|Y-axis maximum travel|mm|6|#####0.000|||0|0]
[SETTING:132|46|Z-axis maximum travel|mm|6|#####0.000|||0|0]
[SETTING:133|47|C-axis maximum travel|deg|6|#####0.000|||0|0]
[SETTING:160|44|X-axis backlash compensation|mm|6|#####0.000##|||0|0]
[SETTING:161|45|Y-axis backlash compensation|mm|6|#####0.000##|||0|0]
[SETTING:162|46|Z-axis backlash compensation|mm|6|#####0.000##|||0|0]
[SETTING:163|47|C-axis backlash compensation|deg|6|#####0.000##|||0|0]
[SETTING:310|15|Hostname (AP)||7|x(64)||64|1|0]
[SETTING:312|15|IP Address (AP)||9||||1|0]
[SETTING:313|15|Gateway (AP)||9||||1|0]
[SETTING:314|15|Netmask (AP)||9||||1|0]
[SETTING:320|15|Hostname||7|x(64)||64|1|0]
[SETTING:321|15|IP Mode||3|Static,DHCP|||1|0]
[SETTING:322|15|IP Address||9||||1|0]
[SETTING:323|15|Gateway||9||||1|0]
[SETTING:324|15|Netmask||9||||1|0]
[SETTING:325|15|Telnet port||5|####0|1|65535|1|0]
[SETTING:326|15|HTTP port||5|####0|1|65535|1|0]
[SETTING:327|15|Websocket port||5|####0|1|65535|1|0]
[SETTING:328|15|FTP port||5|####0|1|65535|1|0]
[SETTING:337|16|WiFi Access Point (AP) BSSID||7|x(17)|17|17|1|1]
[SETTING:340|6|Spindle at speed tolerance|percent|6|##0.0|||0|0]
[SETTING:341|9|Tool change mode||3|Normal,Manual touch off,Manual touch off @ G59.3,Automatic touch off @ G59.3,Ignore M6|||0|0]
[SETTING:342|9|Tool change probing distance|mm|6|#####0.0|||0|0]
[SETTING:343|9|Tool change locate feed rate|mm/min|6|#####0.0|||0|0]
[SETTING:344|9|Tool change search seek rate|mm/min|6|#####0.0|||0|0]
[SETTING:345|9|Tool change probe pull-off rate|mm/min|6|#####0.0|||0|0]
[SETTING:346|9|Tool change options||1|Restore position after M6,Change tool at G30,Fast probe pull off|||0|0]
[SETTING:376|35|Rotary axes||1|C-Axis|||0|0]
[SETTING:384|1|Disable G92 persistence||0||||0|0]
[SETTING:392|13|Spindle on delay|s|6|#0.0|0.5|60|0|1]
[SETTING:393|13|Coolant on delay|s|6|#0.0|0.5|20|0|1]
[SETTING:394|6|Spindle on delay|s|6|#0.0|0.5|60|0|1]
[SETTING:395|6|Default spindle||3|PWM,Stepper|||1|0]
[SETTING:396|1|WebUI timeout|minutes|5|##0||999|0|0]
[SETTING:397|1|WebUI auto report interval|milliseconds|5|###0|100|9999|1|1]
[SETTING:398|1|Planner buffer blocks||5|####0|30|1000|1|0]
[SETTING:481|1|Autoreport interval|ms|5|###0|100|1000|1|1]
[SETTING:484|1|Unlock required after E-Stop||0||||0|0]
[SETTING:485|9|Keep tool number over reboot||0||||0|0]
[SETTING:486|1|Lock coordinate systems||1|G59.1,G59.2,G59.3|||0|0]
[SETTING:511|6|Spindle 2||3|Disabled,PWM,Stepper|||1|0]
[SETTING:520|6|Spindle 1 tool number start||5|####0|0|65535|1|0]
[SETTING:534|1|Output NGC debug messages||0||||0|0]
[SETTING:538|35|Fast rotary go to G28||1|C-Axis|||0|0]
[SETTING:539|6|Spindle off delay|s|6|#0.0|0.5|60|0|1]
[SETTING:650|1|File systems options||1|N/A,Hide LittleFS,Hierarchical listing|||0|0]
[SETTING:673|5|Coolant on delay|s|6|#0.0|0.5|20|0|1]
[SETTING:675|9|Macro ATC options||1|Execute M6T0,Fail M6 if tc.macro not found|||0|0]
[SETTING:676|1|Reset actions||1|Clear homed status if position was lost,Clear offsets (except G92),Clear rapids override,Clear feed override|||0|0]
[SETTING:677|6|Stepper spindle options||1|Allow axis control,Sync position,Configure as rotary axis|||0|0]
[SETTING:680|35|Stepper enable delay|ms|5|##0||500|0|0]
[SETTING:700|1|Subroutine options||1|Prescan for internal M98 subroutines|||0|0]
[SETTING:701|1|Rotary options||2|Fix feedrate,Revert metric conversion|||0|0]
[SETTING:703|42|MPG autoreport interval|ms|5|###0|100|1000|1|1]
