revjmoney/revturn-lathe-firmware/(commit log)

2026-11-09 grblHAL ESP32 upstream baseline (ESP32 0b2d3e1 + submodules at pinned commits), flattened
    [config.h, partitions.csv, partitions_s3_8m.csv]
2026-11-09 REVTURN lathe build: WiFi reconnect, reboot on crash, multi-screen websocket, WebUI fixes, stepper spindle units, lathe board config
    [my_machine.h, my_machine_map.h, stepper.c]
2026-11-09 Fix crash: stepper-spindle IRAM ISR called flash code; WiFi close once per outage; yield in reversal wait; README with screenshots
    [driver.c, stepper.c, timers.c, wifi.c]
2026-11-09 Embedded screen: spindle ON / STOP and live speed slider, zero bar and backplot on every screen
2026-11-09 README: calibrated machine settings table
2026-11-09 Printed parts: R4 bed ends and R9 cross slide (STL + STEP), drawings, BOM and print notes
    [cross_slide_saddle_r9.step, cross_slide_saddle_r9.stl, cross_slide_top_plate_r9.step, cross_slide_top_plate_r9.stl, headstock_frame.step, headstock_frame.stl, pulley_30t_motor_bore5_r9.step, pulley_30t_motor_bore5_r9.stl]
2026-11-09 README: junk-bin build notice (salvaged rails, AliExpress headstock, Cricut + StepperOnline motors); adapt STLs and settings
2026-11-09 Stepper spindle: atomic speed/start/stop vs the step ISR, fix ramp branch on a speed drop; screen sends $G so VIEW ONLY shows DIA; STLs licensed CC BY-SA 4.0
2026-11-09 Screen: compact fit-to-window layout and a WEBUI button
2026-11-09 Stepper spindle: take the ISR lock only while the motor runs (locking on every call starved WiFi; screens could not connect)
2026-11-09 Screen: LIMITS switch, stroke limits off by default
2026-11-09 README: link the first 3-motor test run video
2026-11-09 Buy me a coffee links (README, printed parts) and FUNDING.yml sponsor button
2026-11-09 README: more links, spacing fix in printed parts
2026-11-10 Settings: C driver at 8x (13.333 steps/deg), spindle max 200 rpm
2026-11-10 Settings: spindle max 275 rpm
2026-11-10 Expressions, jerk motion, accel profiles, backlash comp, tool nose comp, mDNS, probe and E-stop inputs; guest access for the jog-wheel pendant
    [my_machine.h, my_machine_map.h]
2026-11-10 Remove probe and E-stop inputs: on GPIO 14/13 they starved the WiFi
2026-11-10 Turn jerk-limited motion off: it stalled the steppers
2026-11-10 Review fixes: viewer HOLD works, strict guest line filter, no WiFi self-reboot, no stream jam, Idle state checks
    [wifi.c]
2026-11-10 Hardware: add the direct-drive X option (R8 saddle, top plate and motor plate, 1:1 Oldham coupler)
    [cross_slide_saddle_r8_direct.step, cross_slide_saddle_r8_direct.stl, cross_slide_top_plate_r8_direct.step, cross_slide_top_plate_r8_direct.stl, x_motor_plate_r8_direct.step, x_motor_plate_r8_direct.stl]
2026-11-10 Spindle restart while stopping, responsive reset during reversal, viewer input never parked
    [stepper.c]
2026-11-10 Websocket memory fixes, pendant always filtered, PWM spindle enable off the GPIO5 strap pin
    [my_machine_map.h]
2026-11-10 README: PWM spindle pins
2026-11-11 Hardware: the inline rail X motor mount (on the lathe), belt bracket now an option
    [x_motor_inline_rail_mount_r9.step, x_motor_inline_rail_mount_r9.stl]
2026-11-11 Hardware: inline X motor mount without the side flange (on the lathe); side-tie version kept as an option
    [x_motor_inline_rail_mount_no_side_tie_r9.step, x_motor_inline_rail_mount_no_side_tie_r9.stl]
2026-11-11 Hardware: swivel tool post (0/45/90) with turning, solid 1/4 in and boring holders; FreeCAD lathe assembly + animation
    - tool post: swivel ring + post on the R9 top plate, +/-4 mm height jack, dovetail holders, V shim for round bits;
    STEP + STL, pictures, FreeCAD build script with 132 fit checks
    - assembly/: whole lathe as built (FCStd + STEP), live g-code animation macro with stock panel
    - README: tool post and assembly sections, Z drive as built (big pulley to a separate NEMA 17)
    [REVTURN_lathe_assembly.FCStd, REVTURN_lathe_assembly.step, tool_post_base.step, tool_post_base.stl, tool_post_holder_boring.step, tool_post_holder_boring.stl, tool_post_holder_quarter_inch_solid.step, tool_post_holder_quarter_inch_solid.stl]
2026-11-11 REVTURN by JMSCNC: boots to the REVTURN screen at /, stock WebUI moved to /webui/ (settings only), JMSCNC copyright lines, REVTURN network names and board name, branded screen with ABOUT
2026-11-11 Hardware: all FreeCAD sources (bed ends + R8/R9 builder, X motor mount in all four versions with their FCStd files); README section on rebuilding
    [cross_slide_saddle_r9.step, cross_slide_top_plate_r9.step, headstock_frame.step, inline_motor_mount_EXTENDED_SPLIT_CLAMPS.FCStd, inline_motor_mount_EXTENDED_SPLIT_CLAMPS_NO_SIDE_TIE.FCStd, inline_motor_mount_SOLID_HALF_SIDE_TIE.FCStd, inline_mount_assembly.FCStd, inline_no_side_tie_assembly.FCStd]
2026-11-11 REVTURN website (site/, GitHub Pages workflow) in the control screen's look, 17 live screenshots; README links the site, jmscnc.com, the board and Buy me a coffee
2026-11-11 Website: photo of the REVTURN controller board in BUY ONE
2026-11-11 Beta note: conversational cycles not cut-tested yet (preview, DRY RUN, stroke limits, thread scratch pass)
2026-11-11 Cycle test card; Z at 32x and 22 ipm; resonance + stepper-music tests (tools, findings, reports, charts); website SHAKE AND SING section; no more $5 wording
    [notes.csv, report.csv]
2026-11-11 GPL-3.0-or-later with attribution on everything REVTURN (LICENSE, NOTICE, SPDX headers; printed parts move from CC BY-SA); REVTURN plays Ode to Joy: song generator with dolphin intro and Z bassline, 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
    [lathe.csv, song_notes.csv]
2026-11-11 Publish the REVTURN screen source in screen/ (GPL-3.0-or-later with attribution, 368 tests); resonance recorder now imports it from the repo
    [grblhal-settings.txt]
2026-11-12 Chuck C axis tuning and webcam rpm tests: how-to doc, tools (sweeps, speed test, rpm reader, recorder, shake video), results; C accel 3000 and C max 300 rpm in the settings table; expression programs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
    [lathe.csv]
2026-11-12 WebUI theme: POWERED BY box with the original grblHAL and ESP3D logos and credits (extracted from the WebUI build), REVTURN logo on the left
2026-11-14 Tool post: 10 mm round-bar holder, slides 1/4 in each way on the dovetail, 2 x M4 top clamps (STL, STEP, source, README row)
    [tool_post_holder_10mm_round.step, tool_post_holder_10mm_round.stl]
